agelders2021/xmitter/Documentation/doc_index.md

# Documentation index

Auto-generated by `tools/gen_doc_index.py` on 2026-07-24.  Do not
hand-edit — rerun the script after editing docs.

Two ways to find things:

- **By topic** — scan when you don't remember which file has what.
  Each topic lists file:line hits with the matching line quoted.
- **By file** — each .md's H1/H2/H3 outline. Scan when you know
  the file but not the section.

To search interactively in `less`, use `/pattern` inside the viewer.
For a raw search across all docs from the shell:

    python tools/gen_doc_index.py --search <regex>

---

## By topic

### Toroid winding & cores (T50-6, T68-6, T106-2, FT37, FT82, FT114)

- **Documentation/2026-06-16-supply-and-pcb-strategy.md**
    - L182: (body) toroidal or large E-I primary has 10x inrush regardless of what is
- **Documentation/balun_stage.md**
    - L47: Core: FT82-43 with 5+2 turns
- **Documentation/build_checklist.md**
    - L100: (body) - [ ] **Toroid cores**: T50-6 (VFO LPF — already needed this phase if not
- **Documentation/control_board_BOM_and_wire_plan.md**
    - L1: Control Board BOM + Magnet Wire Plan — 2026-06-16
    - L224: Toroidal inductors (control board)
    - L290: Magnet wire plan - three gauges by stage
- **Documentation/driver_stage.md**
    - L110: Driver output transformer (T68-6)
- **Documentation/jfet_library_readme.md**
    - L128: (body) *Models compiled by Al from OrCAD JFET library (National Semiconductor, 1998),
- **Documentation/LPF_stage.md**
    - L70: (body) L1 and L2 both 540 nH single-wound on a toroidal core.
- **Documentation/PA_stage.md**
    - L185: (body) Toroids are unsuitable for L4, L5, L6. The reasons:
- **Documentation/pcb_fab_checklist.md**
    - L233: (body) mounting holes without conflicting with U1 Si5351 or L6 toroid).
- **Documentation/vfo_input_stage.md**
    - L56: 7-pole low-pass filter (T68-6 inductors, original caps kept)

### Grid bias (OPA454, DAC, slam)

- **CLAUDE.md**
    - L56: (body) existing `bias.kicad_sch` (OPA454 bias generator + LM393 cathode
- **Documentation/2026-06-08-pa-validation.md**
    - L206: (body) DAC + HV op-amp (OPA454) circuit captured in `legacy/20m-leveled-keyed-buffer.md`.
- **Documentation/2026-06-16-supply-and-pcb-strategy.md**
    - L15: (body) + MCU + keyer logic) and PA module board (grid bias + cathode monitor).
- **Documentation/build_checklist.md**
    - L260: Phase 4 — PA + Grid Bias + Cathode Monitor (bias-slam fault path)
- **Documentation/construction.md**
    - L76: (body) Decision (2026-07-09): the control PCB (MC1496 keyer, MCP4921
- **Documentation/control_board_BOM_and_wire_plan.md**
    - L83: (body) **MCP4921** - 12-bit SPI DAC, PDIP-8
- **Documentation/cw_envelope_keyer.md**
    - L179: (body) - DAC: MCP4921, 12-bit, SPI, command word `0x3000` (ch A, buffered, 1x gain,
- **Documentation/design_review_7-5-26.md**
    - L155: (body) - **Grid-bias default state.** MCP4728 EEPROM code 0 → OPA454 output
- **Documentation/driver_stage.md**
    - L291: Q1 — Grid bias polarity
- **Documentation/front_panel_interface.md**
    - L197: (body) writes to the MCP4728 grid-bias DAC.
- **Documentation/grid_bias.md**
    - L1: Grid Bias Subsystem
- **Documentation/kicad_custom_symbols.md**
    - L169: xmitter:OPA454  (DONE — built 2026-06-22)
- **Documentation/pa_cathode_monitor.md**
    - L457: Watchdog gate (grid-bias slam, on the bias sheet)
- **Documentation/PA_stage.md**
    - L43: (body) bias rail (the OPA454 per-tube bias output)

### Cathode monitor, failsafe, fault chain

- **CLAUDE.md**
    - L56: (body) existing `bias.kicad_sch` (OPA454 bias generator + LM393 cathode
- **Documentation/2026-06-16-supply-and-pcb-strategy.md**
    - L15: (body) + MCU + keyer logic) and PA module board (grid bias + cathode monitor).
- **Documentation/build_checklist.md**
    - L260: Phase 4 — PA + Grid Bias + Cathode Monitor (bias-slam fault path)
- **Documentation/construction.md**
    - L88: (body) cathode monitor ADC path
- **Documentation/design_review_7-5-26.md**
    - L18: (body) Design is conceptually sound. The 7-layer cathode failsafe, DPDT T/R
- **Documentation/front_panel_interface.md**
    - L195: (body) cathode monitor path (currently spec'd at 1 kHz per channel on the
- **Documentation/grid_bias.md**
    - L28: (body) monitor's diode-OR; conceptually the "CT_FAULT" signal) via a 2N7000
- **Documentation/i2c_bus.md**
    - L81: (body) inter-board header, and its LM393 cathode monitor sends digital
- **Documentation/pa_cathode_monitor.md**
    - L1: PA Cathode Current Monitor and Failsafe Chain
    - L377: Why diode-OR (not the simpler wired-tie)
- **Documentation/PA_stage.md**
    - L325: Q3 — Cathode monitor and fault chain
- **Documentation/pcb_fab_checklist.md**
    - L7: (body) Scope: **analog control board only** (bias + cathode monitor + VFO +

### PA (6146B, operating point, push-pull, tank)

- **CLAUDE.md**
    - L3: (body) 20 m CW vacuum-tube transmitter. Push-pull 6146B PA, push-pull 12HG7 driver,
- **Documentation/2026-06-08-pa-validation.md**
    - L101: R17 sweep at V6 = 160 V
    - L123: V6 sweep at R17 = 300 Ω
    - L373: `tools/sweep_bias_drive.py` — paired (bias, V6) sweep for grid-voltage-constrained analysis
    - L430: 3. Koren tube model unphysical negative plate current
- **Documentation/2026-06-16-supply-and-pcb-strategy.md**
    - L33: (body) - Loads: 6146B plate center tap (push-pull pair)
- **Documentation/balun_stage.md**
    - L25: (body) differential PA output (driven push-pull from the PA link
- **Documentation/build_checklist.md**
    - L228: Phase 3 — Driver (push-pull 12HG7)
- **Documentation/construction.md**
    - L143: Balance and matching between the two push-pull channels
- **Documentation/control_board_BOM_and_wire_plan.md**
    - L259: (body) 12HG7 plates and 6146B grids. The only bifilar-wound transformer
- **Documentation/cw_envelope_keyer.md**
    - L23: (body) - **PA:** push-pull 6146B beam tetrodes
- **Documentation/driver_stage.md**
    - L3: (body) Push-pull pair of 12HG7 beam pentodes (TV horizontal-sweep tubes,
- **Documentation/grid_bias.md**
    - L3: (body) Per-tube negative grid-bias generation for the push-pull 6146B PA, with a
- **Documentation/LPF_stage.md**
    - L175: (body) - `Documentation/PA_stage.md` — upstream PA stage and tank
- **Documentation/pa_cathode_monitor.md**
    - L3: (body) Per-tube cathode-current monitoring on the push-pull 6146B PA, with all the
- **Documentation/PA_stage.md**
    - L1: PA Stage — Current State
- **Documentation/vfo_input_stage.md**
    - L33: (body) - Si5351 module produces a 3.3 V CMOS push-pull square wave at the

### Driver (12HG7, 12BY7A, output xfmr)

- **CLAUDE.md**
    - L3: (body) 20 m CW vacuum-tube transmitter. Push-pull 6146B PA, push-pull 12HG7 driver,
- **Documentation/2026-06-08-pa-validation.md**
    - L62: (body) - **Re = 200 Ω** (was 1 kΩ) — increases modulator gain (12HG7 driver wants ~8 V p-p input)
- **Documentation/2026-06-16-supply-and-pcb-strategy.md**
    - L45: (body) - Loads: 12HG7 plate center tap
- **Documentation/build_checklist.md**
    - L228: Phase 3 — Driver (push-pull 12HG7)
- **Documentation/construction.md**
    - L101: (body) PCB near the MC1496 output and reaches the 12HG7 driver grids
- **Documentation/control_board_BOM_and_wire_plan.md**
    - L9: (body) LM7171 post-amps + 12HG7 driver topology)
- **Documentation/cw_envelope_keyer.md**
    - L24: (body) - **Driver:** push-pull 12HG7 pentodes
- **Documentation/driver_stage.md**
    - L1: Driver Stage — Current State
    - L110: Driver output transformer (T68-6)
- **Documentation/PA_stage.md**
    - L40: (body) - Each tube grid is driven from the driver output transformer
- **Documentation/vfo_input_stage.md**
    - L272: (body) - The 12HG7 push-pull driver is on the driver board, not the

### Balun / broadband transformer

- **CLAUDE.md**
    - L52: (body) Empty stubs `pa/driver/balun/lpf_output.kicad_sch` still linked at
- **Documentation/2026-06-08-pa-validation.md**
    - L92: Balun subcircuit (`Balun_6to1_subcircuit.sch`)
- **Documentation/balun_stage.md**
    - L1: Balun Stage — Current State
- **Documentation/build_checklist.md**
    - L353: Phase 5 — Balun + Output LPF + ATU
- **Documentation/control_board_BOM_and_wire_plan.md**
    - L14: (body) driver / output LPF / future ATU toroids, #18 AWG for the balun
- **Documentation/design_review_7-5-26.md**
    - L10: (body) buffer_keyer, VFO, arduino, interface). Excluded: PA / driver / balun /
- **Documentation/LPF_stage.md**
    - L9: (body) Single-impedance design for 50 Ω only (PA → balun → this LPF → coax
- **Documentation/PA_stage.md**
    - L5: (body) (then through the 6:1 balun to 50 Ω unbalanced, through the LPF,
- **Documentation/pcb_fab_checklist.md**
    - L10: (body) still empty stubs — `pa`, `driver`, `balun`, `lpf_output` — are

### Output LPF (7-pole, Chebyshev)

- **Documentation/2026-06-08-pa-validation.md**
    - L36: (body) **LPF** upgraded from 5-pole to **7-pole Chebyshev** (same fc = 17.5 MHz, 0.1 dB ripple)
- **Documentation/balun_stage.md**
    - L4: (body) output to a 50 Ω unbalanced output for the output LPF, coax run,
- **Documentation/build_checklist.md**
    - L353: Phase 5 — Balun + Output LPF + ATU
- **Documentation/control_board_BOM_and_wire_plan.md**
    - L5: (body) toroidal inductor in the project (control board, driver, PA, output LPF).
- **Documentation/cw_envelope_keyer.md**
    - L184: (body) - **Reconstruction LPF + level scaler (single passive stage):**
- **Documentation/design_review_7-5-26.md**
    - L11: (body) LPF sheets (Phase 3–5), front-panel sheet population, firmware
- **Documentation/LPF_stage.md**
    - L1: Output LPF Stage — Current State
- **Documentation/pa_cathode_monitor.md**
    - L130: (body) supply. C_FILT in parallel makes the node a single-pole LPF with R_S:
- **Documentation/PA_stage.md**
    - L5: (body) (then through the 6:1 balun to 50 Ω unbalanced, through the LPF,
- **Documentation/vfo_input_stage.md**
    - L56: 7-pole low-pass filter (T68-6 inductors, original caps kept)

### VFO / Si5351 / VFO buffer

- **CLAUDE.md**
    - L49: (body) keyer chain), `vfo.kicad_sch` (Si5351 VFO), `arduino.kicad_sch` (Metro
- **Documentation/2026-06-08-pa-validation.md**
    - L22: VFO subcircuit (`vfo_subcircuit.sch`)
- **Documentation/2026-06-16-supply-and-pcb-strategy.md**
    - L207: Why this partition (not "VFO sensitivity to HV")
- **Documentation/build_checklist.md**
    - L29: Phase 1 — VFO
- **Documentation/component_bins.md**
    - L5: (body) **Sources:**  `KiCAD/analog` (+ `arduino`, `buffer_keyer`, `vfo`, `interface`),
- **Documentation/construction.md**
    - L77: (body) envelope DAC, Si5351 VFO, MCP4728 quad DAC, PCF8575 expander,
- **Documentation/control_board_BOM_and_wire_plan.md**
    - L3: (body) Sourcing-ready parts list for the control board (VFO + keyer + envelope
- **Documentation/cw_envelope_keyer.md**
    - L349: I²C address — MCP4728 vs Si5351 collision
- **Documentation/design_review_7-5-26.md**
    - L10: (body) buffer_keyer, VFO, arduino, interface). Excluded: PA / driver / balun /
- **Documentation/front_panel_interface.md**
    - L34: (body) - **Front panel** holds: WH2004A 20×4 LCD, MBL-600 optical encoder (VFO
- **Documentation/i2c_bus.md**
    - L30: (body) - **0x60 — Si5351A VFO.** Adafruit PID 5640 breakout. Analog control
- **Documentation/LPF_stage.md**
    - L167: (body) (cutoff 17.5 MHz, suppresses Si5351 harmonics) is a different
- **Documentation/pa_cathode_monitor.md**
    - L239: (body) already carries Si5351 (0x60), MCP4728 (0x62 after reprogram), and
- **Documentation/pcb_fab_checklist.md**
    - L7: (body) Scope: **analog control board only** (bias + cathode monitor + VFO +
- **Documentation/vfo_input_stage.md**
    - L1: VFO Input Stage — Current State
    - L145: Optional J310 source follower
    - L196: Q1 — J310 source follower: keep or remove?
    - L221: Q2 — Si5351 output drive strength
    - L239: Q3 — Pi pad value if Si5351 fundamental is too high
    - L257: Q4 — Termination of unused Si5351 outputs

### Keyer / CW envelope / raised cosine

- **CLAUDE.md**
    - L4: (body) MC1496-based VCA keyer with envelope shaping, Adafruit Metro ESP32-S3 control.
- **Documentation/2026-06-08-pa-validation.md**
    - L59: Keyer subcircuit (`keyer.sch`)
    - L67: LM7171 post-keyer amplifier (new subcircuit `Op_Amp_Out.sch`)
- **Documentation/2026-06-16-supply-and-pcb-strategy.md**
    - L15: (body) + MCU + keyer logic) and PA module board (grid bias + cathode monitor).
- **Documentation/build_checklist.md**
    - L101: (body) yet on hand), T68-6 (alternate), T106-2 (PA tank), FT37-43 (keyer
- **Documentation/construction.md**
    - L76: (body) Decision (2026-07-09): the control PCB (MC1496 keyer, MCP4921
- **Documentation/control_board_BOM_and_wire_plan.md**
    - L3: (body) Sourcing-ready parts list for the control board (VFO + keyer + envelope
- **Documentation/cw_envelope_keyer.md**
    - L1: CW Envelope Keyer — Context for Claude Code
    - L60: Public API (what the WinKey layer calls)
    - L150: Calibration (predistortion) — TODO
- **Documentation/design_review_7-5-26.md**
    - L106: (body) which feeds RS-422 receiver, envelope keyer, and cathode monitor
- **Documentation/front_panel_interface.md**
    - L262: (body) which source the WinKey scheduler reads. The unselected source is
- **Documentation/grid_bias.md**
    - L191: (body) normal key-up/key-down bias change. WinKey signals trigger the DAC
- **Documentation/kicad_custom_symbols.md**
    - L221: xmitter:MC1496  (optional, secondary priority)
- **Documentation/pa_cathode_monitor.md**
    - L132: (body) envelope's harmonics (well above the ~200 Hz envelope content); fast enough
- **Documentation/PA_stage.md**
    - L122: (body) Per-tube envelope at OPERATE (V_supply = 600 V, V_SCREEN = 200 V,
- **Documentation/pcb_fab_checklist.md**
    - L8: (body) buffer/keyer + Arduino carrier + Interface). The PA module is a separate
- **Documentation/vfo_input_stage.md**
    - L5: (body) sinusoidal signal to the MC1496 carrier input.

### Front panel / RJ45 umbilical / PCF8575 / LCD

- **CLAUDE.md**
    - L18: (body) | `KiCAD/` | KiCad PCB design files. One project per board: `analog/` (fabricated Rev A...
- **Documentation/2026-06-08-pa-validation.md**
    - L295: (body) The bias DAC's update rate (~360 kHz on MCP4725 fast-mode I²C) is far faster
- **Documentation/2026-06-16-supply-and-pcb-strategy.md**
    - L241: Umbilical considerations
- **Documentation/build_checklist.md**
    - L113: Phase 2 — User Interface (encoders + front panel)
- **Documentation/component_bins.md**
    - L6: (body) `KiCAD/bias`, `KiCAD/frontpanel`.
- **Documentation/construction.md**
    - L44: (body) - Result looks **punched, not filed** — front panel quality
- **Documentation/control_board_BOM_and_wire_plan.md**
    - L165: (body) **WH2004A LCD contrast**
- **Documentation/cw_envelope_keyer.md**
    - L369: (body) 0x20 / 0x21 PCF8575, and leaves room around 0x48 for any future
- **Documentation/design_review_7-5-26.md**
    - L46: (body) MCP4728 0.1" header (SDA/SCL) ─── PCB traces ─── PCF8575 x2 + RJ45
- **Documentation/front_panel_interface.md**
    - L272: RJE1D-188 footprint verification — REOPENED, pending Rev A fit check
    - L315: PCF8575 breakout footprint verification
- **Documentation/grid_bias.md**
    - L184: (body) - **DAC EEPROM safe-park.** MCP4725 startup value = 0 → bias = −85 V
- **Documentation/i2c_bus.md**
    - L10: (body) - **0x20 — PCF8575 (main).** Adafruit PID 5904 breakout. Analog control
- **Documentation/kicad_custom_symbols.md**
    - L268: (body) (Front Panel Express, SendCutSend, Protocase contacts).
- **Documentation/pa_cathode_monitor.md**
    - L240: (body) the two per-tube MCP4725 bias DACs.
- **Documentation/pcb_fab_checklist.md**
    - L66: RJE1D-188 shielded RJ45 socket
    - L90: PCF8575 breakout
- **KiCAD/MULTIBOARD_REVERT.md**
    - L22: (body) `bias/`, `frontpanel/`, pointing at the shared libs one directory up.

### I²C bus, addresses

- **CLAUDE.md**
    - L89: (body) | `Documentation/i2c_bus.md` | **Single source of truth** for I²C device addresses acro...
- **Documentation/2026-06-08-pa-validation.md**
    - L295: (body) The bias DAC's update rate (~360 kHz on MCP4725 fast-mode I²C) is far faster
- **Documentation/2026-06-16-supply-and-pcb-strategy.md**
    - L200: (body) - Bias DAC (MCP4728)
- **Documentation/build_checklist.md**
    - L38: (body) default **0x60** (no ADDR jumper — solder bridge is too small for
- **Documentation/construction.md**
    - L77: (body) envelope DAC, Si5351 VFO, MCP4728 quad DAC, PCF8575 expander,
- **Documentation/control_board_BOM_and_wire_plan.md**
    - L371: I²C bus routing — decision
- **Documentation/cw_envelope_keyer.md**
    - L349: I²C address — MCP4728 vs Si5351 collision
- **Documentation/design_review_7-5-26.md**
    - L30: C1. MCP4728 EEPROM reprogram single-point-of-failure — RESOLVED 2026-07-06
- **Documentation/front_panel_interface.md**
    - L329: Adafruit I²C QT Rotary Encoder footprint + pin-order verification
- **Documentation/grid_bias.md**
    - L185: (body) immediately on cold boot, before MCU initializes I²C or runs any
- **Documentation/i2c_bus.md**
    - L1: I²C bus address plan
- **Documentation/kicad_custom_symbols.md**
    - L138: xmitter:MCP4728  (DONE — built 2026-06-19)
- **Documentation/pa_cathode_monitor.md**
    - L238: (body) - **Bus simplicity.** One fewer I²C address to manage on a bus that
- **Documentation/PA_stage.md**
    - L305: (body) op-amp (one per tube) driven by a firmware MCP4728 DAC, per
- **Documentation/pcb_fab_checklist.md**
    - L99: I²C QT rotary encoder
    - L113: Si5351A STEMMA breakout

### Power supply, rails, transformer, sequencing

- **Documentation/2026-06-08-pa-validation.md**
    - L249: (body) #### Firmware sequencing
- **Documentation/2026-06-16-supply-and-pcb-strategy.md**
    - L1: Power Supply and PCB Strategy — 2026-06-16
    - L24: Power supply
    - L26: Rail inventory
    - L129: Sequencing
    - L146: Inrush limiting
    - L168: Tube filament inrush
- **Documentation/build_checklist.md**
    - L24: (body) Power supply design is being handled in a separate chat. Slots are reserved
- **Documentation/control_board_BOM_and_wire_plan.md**
    - L99: (body) **1N4738A** - 8.2V Zener diode for -8.3V rail derivation
- **Documentation/cw_envelope_keyer.md**
    - L367: (body) correct sequencing.
- **Documentation/design_review_7-5-26.md**
    - L96: C3. +12 V rail source on the analog board is ambiguous
- **Documentation/driver_stage.md**
    - L299: (body) small negative bias from the −105 V rail via a divider.
- **Documentation/front_panel_interface.md**
    - L384: (body) coils (filament, HV, T/R).
- **Documentation/grid_bias.md**
    - L180: Power-up sequencing and fail-safes
    - L196: Level 0 — Power supply tree
- **Documentation/i2c_bus.md**
    - L12: (body) (factory default). Drives the relay coil FETs (filament, HV, T/R).
- **Documentation/pa_cathode_monitor.md**
    - L135: (body) The +3.3 V rail must be **stiff enough to absorb the fault current** transient
- **Documentation/pcb_fab_checklist.md**
    - L144: (body) - [x] Filament / HV / T/R relay drivers are on the **arduino sheet**,

### PCB fab, DRC, ERC, footprint, JLCPCB

- **CLAUDE.md**
    - L46: (body) Analog control board Rev A fabricated (JLCPCB order Y2-13077341A,
- **Documentation/2026-06-08-pa-validation.md**
    - L474: (body) ngspice's ~20 MB footprint per process, that's nothing.
- **Documentation/2026-06-16-supply-and-pcb-strategy.md**
    - L16: (body) - Fab house: **JLCPCB** for both boards.
- **Documentation/build_checklist.md**
    - L140: (body) - [ ] RJ45 footprint verified against datasheet page 2 — see
- **Documentation/component_bins.md**
    - L97: (body) - The following `Value` fields leaked their footprint/pin info into
- **Documentation/construction.md**
    - L56: (body) lay parts on it to verify clearance, ergonomics, and visual
- **Documentation/design_review_7-5-26.md**
    - L6: (body) review — footprint verification and pin-order checks live in
- **Documentation/front_panel_interface.md**
    - L272: RJE1D-188 footprint verification — REOPENED, pending Rev A fit check
    - L315: PCF8575 breakout footprint verification
    - L329: Adafruit I²C QT Rotary Encoder footprint + pin-order verification
- **Documentation/grid_bias.md**
    - L160: (body) no polarity concern, smaller footprint).
- **Documentation/kicad_custom_symbols.md**
    - L33: (body) footprint in `KiCAD/xmitter.pretty/` — this doc extends the approach to
- **Documentation/kicad_routing_cheatsheet.md**
    - L137: DRC & save
- **Documentation/pa_cathode_monitor.md**
    - L534: (body) - [ ] PCB layout: cathode socket area to analog board distance, twisted-pair
- **Documentation/pcb_fab_checklist.md**
    - L59: 1. Custom footprint verification
    - L184: 3. Electrical rules check (ERC)
    - L207: 4. Component footprint coverage
    - L249: 6. Design rules (DRC) — set before routing
- **Documentation/vfo_input_stage.md**
    - L216: (body) footprint on the PCB with provision for a 0 Ω jumper bypass.
- **KiCAD/MULTIBOARD_REVERT.md**
    - L5: (body) KiCad projects sharing one footprint library:

### Firmware, ESP-IDF, FreeRTOS, tasks

- **CLAUDE.md**
    - L4: (body) MC1496-based VCA keyer with envelope shaping, Adafruit Metro ESP32-S3 control.
- **Documentation/2026-06-16-supply-and-pcb-strategy.md**
    - L91: (body) - Loads: Metro ESP32-S3 (via its USB or external power), cathode
- **Documentation/build_checklist.md**
    - L35: (body) - [ ] Adafruit Metro ESP32-S3 confirmed on hand and verified working
- **Documentation/construction.md**
    - L78: (body) Metro ESP32-S3) does **not** go inside the main chassis with the
- **Documentation/control_board_BOM_and_wire_plan.md**
    - L34: (body) optionally Metro ESP32-S3).
- **Documentation/cw_envelope_keyer.md**
    - L28: (body) - **Controller:** Adafruit Metro ESP32-S3, FreeRTOS, dual-core.
- **Documentation/ESP-IDF_Setup_Windows.md**
    - L1: ESP-IDF Setup on Windows
    - L26: Step 2: ESP-IDF Extension
- **Documentation/front_panel_interface.md**
    - L63: (body) quadrature/debounce/state-machine code in the ESP32-S3 firmware
- **Documentation/i2c_bus.md**
    - L20: (body) ESP32-S3 module itself. Not a discrete part in the design — comes with
- **Documentation/kicad_custom_symbols.md**
    - L4: (body) ESP32-S3, Adafruit Si5351A STEMMA QT, etc.) tend to show every pin with
- **Documentation/pa_cathode_monitor.md**
    - L218: (body) **built-in ESP32-S3 ADC** (12-bit, on-chip, ADC1 module). Two analog

### BOM, sourcing, cost

- **CLAUDE.md**
    - L19: (body) | `Documentation/` | Design docs, generated PDFs, sourcing spreadsheets, datasheets |
- **Documentation/2026-06-08-pa-validation.md**
    - L479: (body) - `20m-leveled-keyed-buffer.md` — VFO pad/LPF sections rewritten; BOM updated; added "P...
- **Documentation/2026-06-16-supply-and-pcb-strategy.md**
    - L407: (body) - Pick the actual Hammond part numbers and lock them into the BOM
- **Documentation/build_checklist.md**
    - L96: (body) - [ ] **OPA454** — HV op-amp, sometimes on extended lead at Mouser/DigiKey
- **Documentation/construction.md**
    - L4: (body) each phase of the build surfaces new techniques or sourcing
- **Documentation/control_board_BOM_and_wire_plan.md**
    - L1: Control Board BOM + Magnet Wire Plan — 2026-06-16
- **Documentation/front_panel_interface.md**
    - L78: (body) (Mouser 523-RJE1D18821401). Shielded 8P8C, right-angle THT, tab-down,
- **Documentation/grid_bias.md**
    - L281: BOM summary (this sheet)
- **Documentation/kicad_custom_symbols.md**
    - L51: File-write caveat (KiCad 10 BOM gotcha)
- **Documentation/pa_cathode_monitor.md**
    - L418: BOM
- **Documentation/pcb_fab_checklist.md**
    - L286: 8. Ordering / BOM alignment
- **Documentation/vfo_input_stage.md**
    - L61: (body) are E12 standard silver mica values for easy sourcing. The slight

### Build checklist, phases, long-lead

- **CLAUDE.md**
    - L37: Build checklist
- **Documentation/build_checklist.md**
    - L1: Build Checklist
    - L29: Phase 1 — VFO
    - L113: Phase 2 — User Interface (encoders + front panel)
    - L228: Phase 3 — Driver (push-pull 12HG7)
    - L260: Phase 4 — PA + Grid Bias + Cathode Monitor (bias-slam fault path)
    - L353: Phase 5 — Balun + Output LPF + ATU
    - L379: Phase 6 — Integration / first light
- **Documentation/cw_envelope_keyer.md**
    - L145: (body) **Edge time convention:** `edge_ms` is the **full** phase 0→1 duration. The
- **Documentation/design_review_7-5-26.md**
    - L11: (body) LPF sheets (Phase 3–5), front-panel sheet population, firmware
- **Documentation/front_panel_interface.md**
    - L404: (body) relay is chosen — see Phase 4 checklist).
- **Documentation/i2c_bus.md**
    - L44: (body) `build_checklist.md` Phase 1. Provides grid-bias control voltages
- **Documentation/pcb_fab_checklist.md**
    - L1: PCB Fabrication Pre-Flight Checklist
    - L312: 9. Fab-house-specific pre-flight

### Component bins / physical inventory

_no hits_

### Legacy / obsolete / superseded

- **Documentation/2026-06-08-pa-validation.md**
    - L206: (body) DAC + HV op-amp (OPA454) circuit captured in `legacy/20m-leveled-keyed-buffer.md`.
- **Documentation/build_checklist.md**
    - L221: (body) - [x] ~~**ADS1115 breakout** (Cathode Monitor phase).~~ No longer needed;
- **Documentation/control_board_BOM_and_wire_plan.md**
    - L8: (body) - Removal of the obsolete FT37-43 keyer T1 transformer (superseded by
- **Documentation/cw_envelope_keyer.md**
    - L231: (body) (original derivation is in `legacy/20m-leveled-keyed-buffer.md`).
- **Documentation/design_review_7-5-26.md**
    - L50: (body) Corresponding schematic changes: **SDA/SCL board connections removed
- **Documentation/driver_stage.md**
    - L146: (body) > The 4.8 µH / 1.14 µH numbers date from an earlier legacy analysis
- **Documentation/ESP-IDF_Setup_Windows.md**
    - L106: (body) - **"Configure ESP-IDF Extension"** command no longer exists in extension
- **Documentation/front_panel_interface.md**
    - L43: (body) paddle (see "Paddle jack — two possible paths" below). **No longer
- **Documentation/PA_stage.md**
    - L229: (body) resonance with grid drive removed
- **Documentation/pcb_fab_checklist.md**
    - L88: (body) shield tails (Ø1.57 plated), not 4. Original guesses removed.
- **Documentation/vfo_input_stage.md**
    - L8: (body) are referenced for context but their specifics live in legacy docs.

---

## By file (outline)

### CLAUDE.md

- L1: xmitter project — Claude Code project instructions
  - L13: Directory map
  - L23: If the user ever sets up another fresh machine
  - L37: Build checklist
  - L44: Current focus
  - L77: Existing design references
  - L92: Conventions
  - L105: Tooling regeneration commands

### Documentation/2026-06-08-pa-validation.md

- L1: PA Validation Session — 2026-06-08
  - L8: Summary
  - L20: Changes committed this session
    - L22: VFO subcircuit (`vfo_subcircuit.sch`)
    - L59: Keyer subcircuit (`keyer.sch`)
    - L67: LM7171 post-keyer amplifier (new subcircuit `Op_Amp_Out.sch`)
    - L85: PA subcircuit (`PA_subcircuit.sch`)
    - L92: Balun subcircuit (`Balun_6to1_subcircuit.sch`)
  - L96: PA sweep results
    - L101: R17 sweep at V6 = 160 V
    - L123: V6 sweep at R17 = 300 Ω
    - L149: Grid voltage constraint (the binding limit)
    - L186: Corrected operating point
    - L202: Bias rail strategy: hardware−rail vs firmware−adjusted
    - L224: Two-state bias operation (refinement of the strategy above)
    - L308: Grid-bias subcircuit implementation files
  - L332: New tooling
    - L334: `tools/sweep_param.py` — generic ngspice parameter sweep
    - L373: `tools/sweep_bias_drive.py` — paired (bias, V6) sweep for grid-voltage-constrained analysis
    - L388: `tools/gui_plot.py` change
    - L393: `tools/plot.py` change
  - L399: Lessons learned (worth remembering)
    - L401: 1. ngspice transient sampling vs. RMS/mean accuracy
    - L418: 2. ngspice transient window length vs. RMS/mean validity
    - L430: 3. Koren tube model unphysical negative plate current
    - L444: 4. Diode in series with a 0 V voltage source = SPICE pain
    - L455: 5. The `uic` flag and `.IC` components in QUCS-S
    - L467: 6. Parallel ngspice == real speedup
  - L476: Updated/replaced docs
  - L481: Deferred (next session)

### Documentation/2026-06-16-supply-and-pcb-strategy.md

- L1: Power Supply and PCB Strategy — 2026-06-16
  - L9: Summary of decisions made this session
  - L24: Power supply
    - L26: Rail inventory
    - L96: Topology — three transformers
    - L129: Sequencing
    - L146: Inrush limiting
    - L168: Tube filament inrush
  - L186: PCB partitioning
    - L188: Decision: two boards
    - L207: Why this partition (not "VFO sensitivity to HV")
    - L241: Umbilical considerations
    - L253: Board stackup and rules
  - L270: Fab house decision
  - L298: Surface finish decision
  - L322: EDA tool decision
  - L348: KiCad project structure
    - L381: Net classes for the PA module board
  - L398: Open items for next session

### Documentation/balun_stage.md

- L1: Balun Stage — Current State
  - L9: Block diagram
  - L29: Component values
  - L47: Core: FT82-43 with 5+2 turns
  - L80: Wire gauge
  - L94: Power dissipation
  - L111: Open question
    - L113: Common-mode choking on the antenna coax
  - L123: What is NOT in this stage
  - L133: References

### Documentation/build_checklist.md

- L1: Build Checklist
  - L29: Phase 1 — VFO
    - L33: Verify before starting
    - L74: Verify before declaring done
    - L91: Procure now for later phases
  - L113: Phase 2 — User Interface (encoders + front panel)
    - L117: Verify before starting
    - L161: PCB Rev A fab order
    - L175: Verify before declaring done
    - L215: Procure now for later phases
  - L228: Phase 3 — Driver (push-pull 12HG7)
    - L232: Verify before starting
    - L241: Verify before declaring done
    - L251: Procure now for later phases
  - L260: Phase 4 — PA + Grid Bias + Cathode Monitor (bias-slam fault path)
    - L268: Verify before starting
    - L314: Verify before declaring done
    - L344: Procure now for later phases
  - L353: Phase 5 — Balun + Output LPF + ATU
    - L357: Verify before starting
    - L363: Verify before declaring done
    - L373: Procure now for later phases
  - L379: Phase 6 — Integration / first light
    - L383: Verify before starting
    - L391: Verify before declaring done
  - L412: Reference

### Documentation/component_bins.md

- L1: xmitter component bins  —  24-bin allocation
  - L15: Resistors  (8 bins)
  - L31: Capacitors  (6 bins)
  - L45: Semiconductors  —  bagged & labeled  (2 bins)
  - L55: Individual ICs  —  one bin each  (8 bins)
  - L71: Summary
  - L84: Notes

### Documentation/construction.md

- L1: Construction Notes
  - L7: Chassis and front-panel fabrication
    - L9: Custom CNC panel / chassis services
    - L38: Workflow advantages for this build
    - L47: Caveat — commit the layout first
    - L62: Open items
  - L74: Electronics-in-a-separate-box strategy
    - L83: Why the two-box split
    - L98: Signal chain from PCB to driver tubes
    - L123: Why BNC (not RCA, SMA, or PL-259)
    - L143: Balance and matching between the two push-pull channels
    - L158: Grounding scheme summary
    - L175: Open items — two-box construction

### Documentation/control_board_BOM_and_wire_plan.md

- L1: Control Board BOM + Magnet Wire Plan — 2026-06-16
  - L24: Suppliers used in this list
  - L47: Active devices (control board)
  - L107: Passives - resistors (control board)
  - L190: Passives - capacitors (control board)
  - L224: Toroidal inductors (control board)
  - L253: Cores and inductors - other project boards
  - L290: Magnet wire plan - three gauges by stage
  - L336: Sockets and connectors
  - L371: I²C bus routing — decision
  - L404: Trim caps for tuning
  - L413: Summary by supplier
  - L478: Open items

### Documentation/cw_envelope_keyer.md

- L1: CW Envelope Keyer — Context for Claude Code
  - L9: What this module does
    - L19: Where it sits in the rig
  - L46: RTOS / core model
  - L60: Public API (what the WinKey layer calls)
    - L74: Minimal integration example
  - L94: Design decisions that must NOT be undone
  - L128: Tuning parameters (top of the .cpp)
  - L150: Calibration (predistortion) — TODO
  - L166: Fail-safe requirement (do not skip — this is a tube PA)
  - L177: Hardware notes
  - L297: Next-phase enhancement: DAC-driven digital carrier null
    - L322: Hardware additions
    - L349: I²C address — MCP4728 vs Si5351 collision
    - L388: Coverage analysis
    - L413: Firmware
    - L426: Tradeoff vs running PNPs at fixed bias only
  - L446: Open work / next steps
  - L458: Environment

### Documentation/design_review_7-5-26.md

- L1: Design Review — 2026-07-05
  - L16: Bottom line
  - L28: Real conceptual concerns
    - L30: C1. MCP4728 EEPROM reprogram single-point-of-failure — RESOLVED 2026-07-06
    - L77: C2. K_MAIN mains-interlock relay is not schematically represented
    - L96: C3. +12 V rail source on the analog board is ambiguous
  - L117: Correctly deferred (not concerns)
  - L130: Housekeeping items (already known, not conceptual)
  - L144: Confirmed conceptually sound
  - L194: Explore-agent findings that were false-positives
  - L226: Recommended next-phase work order

### Documentation/driver_stage.md

- L1: Driver Stage — Current State
  - L12: Block diagram
  - L53: Component values
    - L55: Grid path (per tube; lower index = lower tube)
    - L67: Screen path (per tube — see C2/C4 split below)
    - L77: Plate path (per tube)
    - L88: C2 and C4 are two physical caps each
  - L110: Driver output transformer (T68-6)
  - L194: Power dissipation
    - L200: Per-tube tube dissipation
    - L215: Resistor power dissipation
    - L229: Supply currents needed
  - L244: Component selection notes
    - L246: Resistors
    - L254: Capacitors
    - L271: Inductors
    - L282: Sockets
  - L289: Open questions
    - L291: Q1 — Grid bias polarity
    - L301: Q2 — Plate supply voltage tolerance
    - L309: Q3 — Heater wiring (series vs parallel)
  - L317: What is NOT in this stage
  - L326: References

### Documentation/ESP-IDF_Setup_Windows.md

- L1: ESP-IDF Setup on Windows
  - L8: Prerequisites
  - L20: Step 1: VS Code
  - L26: Step 2: ESP-IDF Extension
  - L31: Step 3: Open the xmitter workspace
  - L35: Step 4: Launch EIM (Installation Manager)
  - L44: Step 5: EIM Custom Install
  - L61: Step 6: Reconnect VS Code to the install
  - L83: Step 7: Verify
  - L93: Paths created on disk
  - L104: Gotchas
  - L117: Hardware-side step (for the machine where the Metro lives)
  - L127: Keep both machines in sync

### Documentation/front_panel_interface.md

- L1: Front-Panel Interface
  - L32: Physical topology
  - L94: T568B pin map
  - L120: Grounding rule (SINGLE-POINT)
  - L135: RS-422 termination
  - L152: Interrupt handling (decision: polling now, INT hardware reserved)
  - L232: Paddle jack — two possible paths
  - L267: Open items (verify before PCB fab)
    - L272: RJE1D-188 footprint verification — REOPENED, pending Rev A fit check
    - L315: PCF8575 breakout footprint verification
    - L329: Adafruit I²C QT Rotary Encoder footprint + pin-order verification
    - L357: Schematic — Interface sheet complete (2026-07-13)
    - L395: Control functions — not yet designed
    - L410: Ordering
    - L437: Fabrication (front-panel PCB)
  - L455: Signal chain (end-to-end, for reference)

### Documentation/grid_bias.md

- L1: Grid Bias Subsystem
  - L10: Why this matters
  - L34: System block diagram
  - L78: Architecture decisions
    - L80: Precision reference vs supply rail are SEPARATE nets
    - L101: Why the LM4040 bias resistor is 2.2 kΩ
    - L110: Why R_pad sits between the DAC input and the IN+ pin
    - L127: Why both 2N7000s share one R_GATE
    - L136: Why bypass caps are shared between U5 and U10
    - L153: Why 1 µF instead of 10 µF on the bulk caps
  - L162: Transfer function
  - L180: Power-up sequencing and fail-safes
  - L194: Layer-by-layer design
    - L196: Level 0 — Power supply tree
    - L212: Level 1 — Bias gain stage (one per tube)
    - L229: Level 2 — Bias-slam (one MOSFET per tube, shared gate driver)
    - L241: Level 3 — Supply bypass (shared between U5 and U10)
  - L257: Inter-sheet I/O
  - L281: BOM summary (this sheet)
  - L308: Calibration procedure (bring-up)
  - L328: Open items
  - L343: Related docs

### Documentation/i2c_bus.md

- L1: I²C bus address plan
  - L8: Device inventory
  - L47: Bus topology
  - L77: Bias board
  - L85: Reserved / expansion slots
  - L92: Ruled-out configurations (do not re-propose)
  - L104: Cross-references

### Documentation/jfet_library_readme.md

- L1: Qucs-S Extended JFET & Dual-Gate MOSFET Library
  - L2: Files Included
  - L14: Installation
  - L25: The BF961 — Important Notes
    - L42: Typical Bias (VHF Amplifier)
    - L48: AGC Operation
    - L52: BF961 vs BF981 vs BF998
  - L66: JFET Library — Device Quick Reference
    - L68: N-Channel JFETs
    - L89: P-Channel JFETs
  - L102: SPICE Model Caveats
  - L115: Simulation Tips for Dual-Gate MOSFETs in Qucs-S

### Documentation/kicad_custom_symbols.md

- L1: KiCad Custom Symbols — xmitter library
  - L13: Why custom symbols
  - L36: Library location
  - L51: File-write caveat (KiCad 10 BOM gotcha)
  - L62: Workflow — building a custom symbol
  - L94: Planned custom symbols for this project
    - L96: xmitter:Metro_ESP32S3
    - L132: xmitter:MCP4921_DAC  (optional, secondary priority)
    - L138: xmitter:MCP4728  (DONE — built 2026-06-19)
    - L169: xmitter:OPA454  (DONE — built 2026-06-22)
    - L221: xmitter:MC1496  (optional, secondary priority)
  - L229: Verification checklist before placing a custom symbol
  - L246: Reference — KiCad symbol file format
  - L263: Related docs

### Documentation/kicad_routing_cheatsheet.md

- L1: KiCad 10 PCB Routing Cheatsheet
  - L8: Routing
  - L21: Layers & vias
  - L32: Track width & router mode
  - L44: Edit & select
  - L58: Zones (ground pour)
    - L68: "B doesn't fill my pour" — troubleshooting
  - L114: View & navigation
  - L127: Measurement & info
  - L137: DRC & save
  - L146: Grid & display
  - L155: Cursor tricks
  - L161: Handy workflow

### Documentation/LPF_stage.md

- L1: Output LPF Stage — Current State
  - L14: Block diagram
  - L28: Component values
  - L40: Design choices
  - L68: Inductor build
  - L90: Capacitor selection
  - L113: Expected response
  - L137: Power dissipation
  - L149: ATU interaction
  - L159: What is NOT in this stage
  - L171: References

### Documentation/pa_cathode_monitor.md

- L1: PA Cathode Current Monitor and Failsafe Chain
  - L6: Why this matters
  - L21: System block diagram
  - L57: Layer-by-layer design
    - L59: Level 0 — Cathode resistor + RF bypass
    - L78: Level 1 — PTC fuse (resettable thermal)
    - L97: Level 2 — Series current limiter
    - L119: Level 3 — Schottky clamps + anti-alias filter
    - L143: Level 4 — Op-amp buffer (ADC isolation)
    - L169: Level 5 — Hardware comparator (FAST hardware trip)
    - L215: Level 6 — Firmware soft trip
    - L265: Level 7 — Persistent fault log
  - L283: Per-tube wiring + grounding
  - L310: Layout rules (binding decisions for this build)
    - L312: F1 and R_S stay paired in F1 → R_S order
    - L329: F1 thermal: chassis muffin fan over 6146 socket area
    - L338: Sense cable: shielded coax, shield grounded at tube end
  - L349: Calibration procedure (bring-up)
  - L366: Per-tube → both-tubes summing
    - L377: Why diode-OR (not the simpler wired-tie)
  - L418: BOM
  - L457: Watchdog gate (grid-bias slam, on the bias sheet)
  - L493: Open items
  - L537: Related docs

### Documentation/PA_stage.md

- L1: PA Stage — Current State
  - L12: Block diagram
  - L57: Component values (per side; lower index = lower tube)
    - L59: Grid network
    - L69: Cathode
    - L77: Screen path (per tube — two bypass caps each)
    - L88: Plate path (per tube)
    - L101: Output coupling / load
  - L111: Operating point (validated 2026-06-08)
  - L145: Plate tank design
  - L172: Parasitic suppression
  - L183: Construction notes — air-core coils required
  - L221: Neutralization
  - L233: Power dissipation
    - L235: Per-tube dissipation budget (OPERATE state)
    - L251: Resistor power (worst-case bounds)
    - L276: Supply currents
  - L293: Tube sockets
  - L300: Open questions
    - L302: Q1 — Per-tube bias control
    - L316: Q2 — Bench-time peak grid voltage margin
    - L325: Q3 — Cathode monitor and fault chain
  - L332: What is NOT in this stage
  - L344: References

### Documentation/pcb_fab_checklist.md

- L1: PCB Fabrication Pre-Flight Checklist
  - L31: Current status snapshot (2026-07-14)
  - L59: 1. Custom footprint verification
    - L66: RJE1D-188 shielded RJ45 socket
    - L90: PCF8575 breakout
    - L99: I²C QT rotary encoder
    - L113: Si5351A STEMMA breakout
  - L127: 2. Schematic completeness
    - L132: Interface sheet — `KiCAD/interface.kicad_sch`
    - L156: Arduino sheet — `KiCAD/arduino.kicad_sch`
    - L164: Front_Panel sheet — `KiCAD/front_panel.kicad_sch`
    - L173: Root — `KiCAD/KiCAD.kicad_sch`
  - L184: 3. Electrical rules check (ERC)
  - L207: 4. Component footprint coverage
  - L226: 5. Physical / mechanical
  - L249: 6. Design rules (DRC) — set before routing
  - L271: 7. Two-board directory split — decided (deferred)
  - L286: 8. Ordering / BOM alignment
  - L312: 9. Fab-house-specific pre-flight
  - L336: Sign-off

### Documentation/vfo_input_stage.md

- L1: VFO Input Stage — Current State
  - L10: Block diagram
  - L44: Components and values
    - L46: Pi-pad attenuator (20 dB, 50 Ω in / 50 Ω out)
    - L56: 7-pole low-pass filter (T68-6 inductors, original caps kept)
    - L135: Output coupling and termination
    - L145: Optional J310 source follower
  - L155: Source of truth
  - L167: Simulation vs hardware
  - L194: Open design questions
    - L196: Q1 — J310 source follower: keep or remove?
    - L221: Q2 — Si5351 output drive strength
    - L239: Q3 — Pi pad value if Si5351 fundamental is too high
    - L257: Q4 — Termination of unused Si5351 outputs
  - L265: What is NOT in this stage
  - L278: Related docs and files

### KiCAD/MULTIBOARD_REVERT.md

- L1: Multi-board split — how to revert
  - L26: If the split turns out to be a mistake
    - L28: Option 1 — throw away the branch entirely (cleanest)
    - L38: Option 2 — you already merged the split into master
    - L49: Option 3 — surgical rollback (keep some stages, drop others)
  - L62: What to check after any revert
  - L70: Files intentionally NOT changed by the migration
