agelders2021/xmitter/Documentation/Grid_Bias_Schematic.pdf

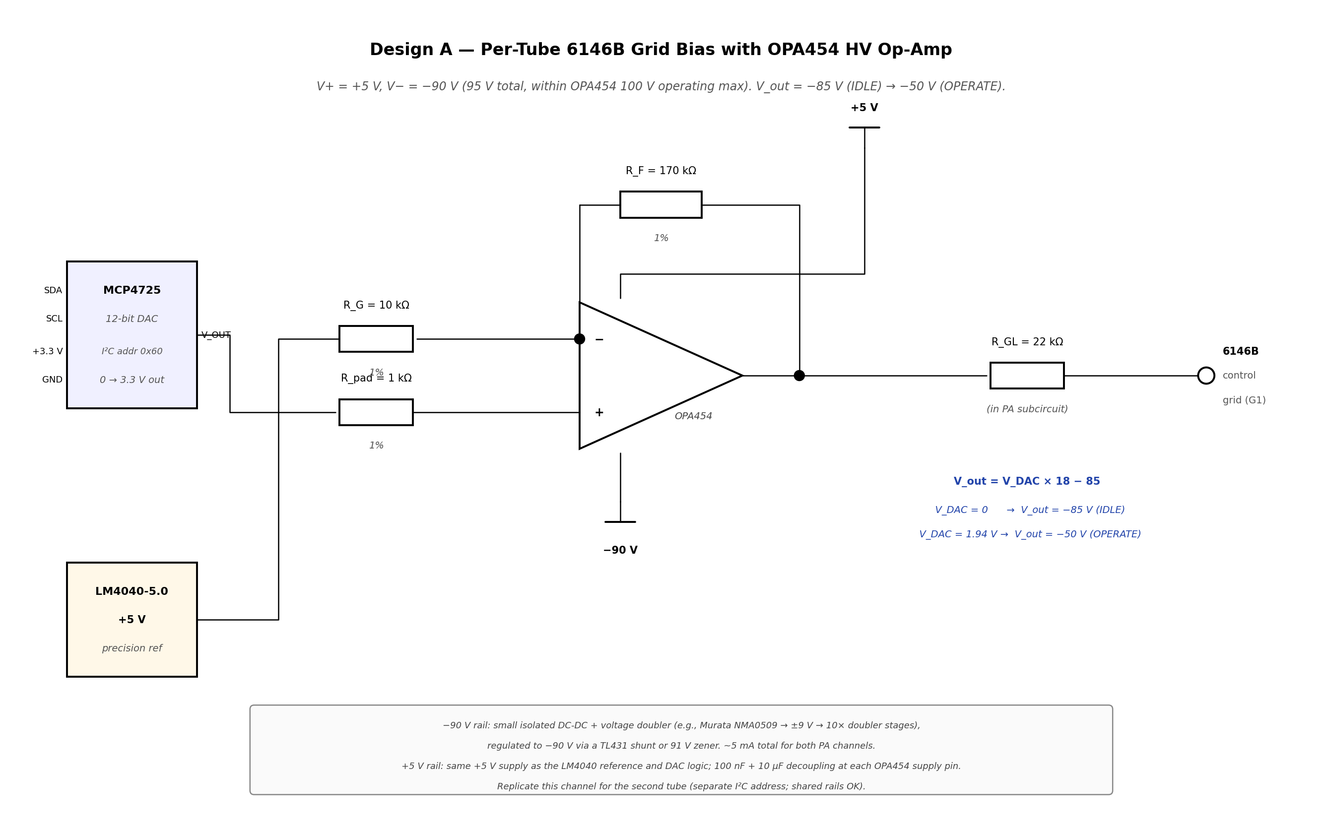
[picture p2: page 1]

Figure 1. Design A — OPA454 HV op-amp version. One channel; replicate for the second tube.

# Design A — OPA454 Components & Transfer Function

Ref | Value / Part | Notes
DAC | MCP4725 (×2) | I²C 12-bit; EEPROM startup = 0 → output = 0 V → V_out = −85 V (IDLE)
Op-amp | OPA454 (×2) | HV op-amp, V+ = +5 V / V− = −90 V (95 V total, within 100 V op max)
V_REF | LM4040DIZ-5.0 | Precision +5 V shunt reference
R_pad | 1 kΩ 1% | DAC → (+) input series; impedance matching
R_G | 10 kΩ 1% | (−) input ↔ V_REF (+5 V)
R_F | 170 kΩ 1% (or 169 kΩ E96) | Feedback (−) ↔ V_out
Decoupling | 100 nF X7R + 10 µF on each rail at the OPA454
+5 V rail | Same as DAC / LM4040 supply | Trivial current; share existing rail
−90 V rail | Isolated DC-DC (e.g., Murata NMA0509) + voltage doubler + TL431 shunt regulator ~5 mA for both PA channels
R_GL | 22 kΩ (already in PA subcircuit) | Unchanged

## Transfer Function

V_out = V_DAC × (1 + R_F/R_G) − V_REF × R_F/R_G = V_DAC × 18 − 85

V_DAC = 0 V → V_out = −85 V (IDLE: tubes deeply cut off, zero plate current)
V_DAC = 1.94 V → V_out = −50 V (OPERATE: shallow class C, ready for envelope) — DAC code 2410 (of 4095)
V_DAC = 3.3 V → V_out = −25.6 V (firmware MUST cap below this — would forward-bias the grid)

Common-mode input range check: with V+ = +5 V / V− = −90 V and OPA454's typical 3 V CM margin, the (+) input range is roughly −87 V to +2 V. V_DAC at the (+) input swings 0 to ~2 V (firmware-bounded), inside the range with margin.
Output swing check: rail-to-rail−2 V gives output range −88 V to +3 V. Comfortably covers −85 V (IDLE) and −50 V (OPERATE).
Supply margin: the +5 V / −90 V choice gives 95 V total — 5 V under the OPA454 100 V operating max, well under the 105 V absolute max.

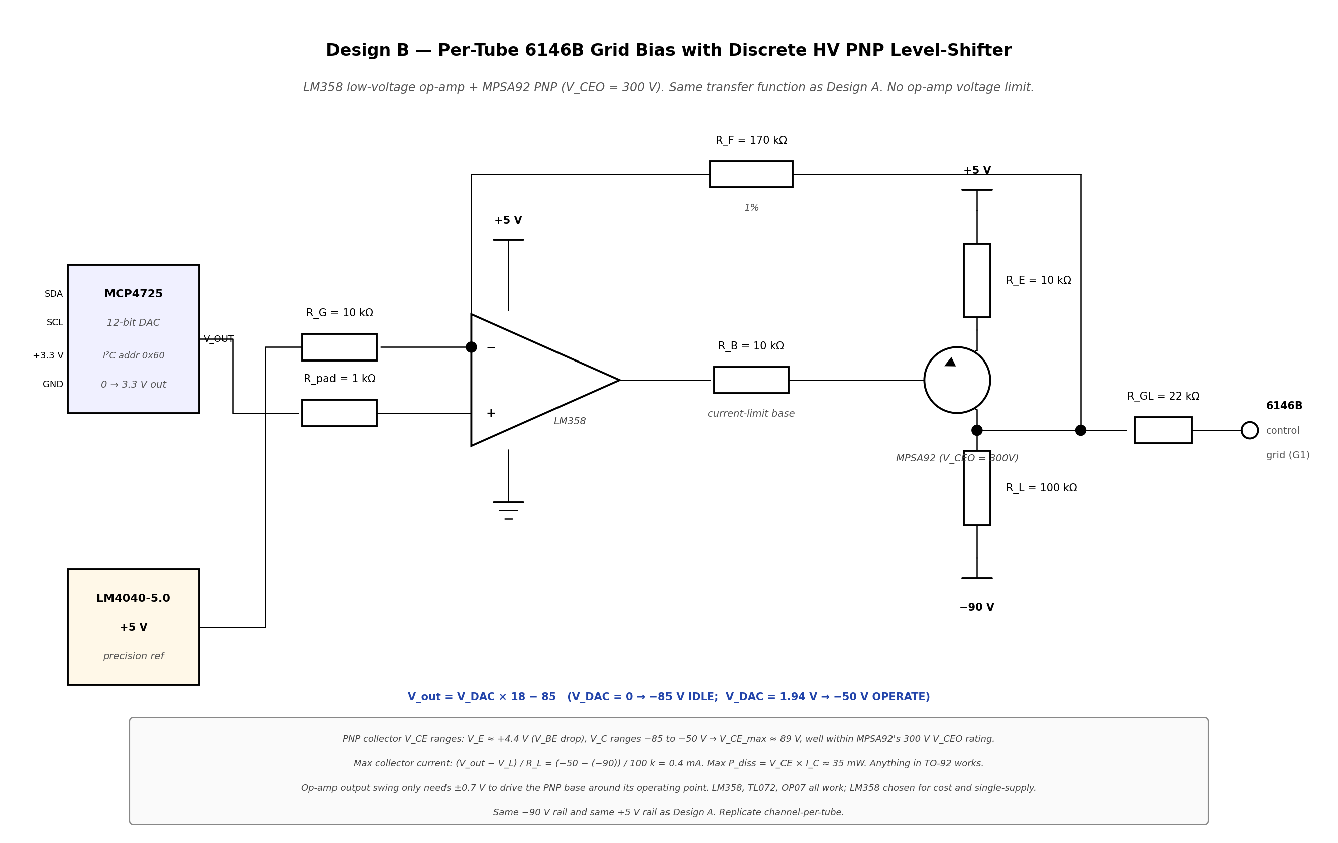
[picture p3: page 3]

Figure 2. Design B — LM358 + discrete MPSA92 PNP level-shifter. Same transfer function as Design A; no op-amp voltage limit.

# Design B — Discrete PNP Components & Notes

Ref | Value / Part | Notes
DAC | MCP4725 (×2) | Same as Design A
Op-amp | LM358 (×2; one half each), or TL072 | LV op-amp, single +5 V supply — no HV constraint
HV transistor | MPSA92 (×2) | PNP, V_CEO = 300 V, TO-92; alternative: KSP44, ZTX560, 2N5401 (160 V)
V_REF | LM4040DIZ-5.0 | Same +5 V shunt reference as Design A
R_pad | 1 kΩ 1% | DAC → (+) input series
R_G | 10 kΩ 1% | (−) input ↔ V_REF (+5 V)
R_F | 170 kΩ 1% (or 169 kΩ E96) | Feedback from PNP collector ↔ (−) input
R_B | 10 kΩ | Base current limit; sets loop slew comfortably
R_E | 10 kΩ | Emitter resistor to +5 V; sets ~0.4 mA emitter current
R_L | 100 kΩ | Collector pull-down to −90 V; sets load impedance
Decoupling | 100 nF X7R at each LM358 supply pin; 1 nF NP0 across each transistor B-E for HF stability
+5 V rail | Shared with DAC, LM4040, LM358
−90 V rail | Same isolated DC-DC as Design A | Loads R_L (×2 tubes); ~1 mA total
R_GL | 22 kΩ (already in PA subcircuit) | Unchanged

## Transfer Function and Operation

Same as Design A: V_out = V_DAC × 18 − 85
The PNP collector node is the output. LM358 closes the loop via R_F sensing the collector voltage; the op-amp drives the PNP base to whatever level forces V_(−) = V_(+) = V_DAC. No supply-voltage limits on the loop because the HV stress is borne entirely by the PNP transistor.

PNP stress check: V_CE_max ≈ V_E − V_C_min = +4.4 V − (−85 V) = 89 V — well below MPSA92's 300 V V_CEO rating (3.4× margin). Max I_C = (V_out − V_neg) / R_L = (−50 − (−90)) / 100 kΩ = 0.4 mA. Max P_diss = V_CE × I_C ≈ 35 mW (any TO-92 fits comfortably).
Op-amp swing required: the LM358 only needs to swing about ±0.7 V around the PNP base operating point — fully within single-supply LM358 specs. Even at the IDLE end (V_out = −85 V → I_C ≈ 0), the op-amp output stays within rails.
Why this exists: if the OPA454 is unobtainable, of dubious authenticity (the marketplace has counterfeits), or you prefer not to operate any single part at its supply max, the discrete design is electrically equivalent and built from in-stock generics. The MPSA92 is a $0.10 part in singles.

# Shared: Two-State Operation, Power-Up, Fail-Safe, Layout

## Two-State Operation

Bias has two firmware-managed states with smooth transitions:
IDLE (key-up): DAC = 0 → V_out = −85 V → 6146B fully cut off, plate current = 0, standby dissipation = 0 W per tube. This is the safe-park state.
OPERATE (key-down): DAC = 2410 (of 4095) → V_out = −50 V → shallow class C, smooth conduction onset, full envelope dynamic range available to the predistortion LUT.
Per-tube trim: the OPERATE DAC code may differ by a few counts between tubes to balance for tube-to-tube spread. Calibrated at bring-up via the cathode-current monitor.

## Power-Up Sequence and Firmware Timing

Power-on: Rails come up (+5 V, −90 V). MCP4725 EEPROM startup value = 0 → DAC = 0 V → V_out = −85 V on both tubes. PA is in deep cutoff before the MCU finishes booting.
Key-down sequence: (1) WinKey signals key-down; (2) per-tube bias DACs commanded IDLE → OPERATE (each ~25 µs over I²C); (3) wait 200 µs for op-amp + grid input cap to settle; (4) launch envelope DAC raised-cosine ramp from 0 → CODE_FULL.
Key-up sequence: (1) envelope DAC ramps to 0 over 3–5 ms; (2) wait 1 ms guard after envelope nulls; (3) bias DACs commanded OPERATE → IDLE; (4) wait 200 µs to confirm tubes back in cutoff.

## Fail-Safe

Three independent layers:
(1) DAC EEPROM safe-park: startup value 0 → IDLE bias on cold boot, before MCU initializes I²C.
(2) Watchdog gate: esp_task_wdt pulls a hardware GPIO that removes screen voltage if the MCU hangs. PA goes dark even if the DAC is stuck in OPERATE.
(3) Cathode-current monitor: independent ADC-based sense (separate circuit) triggers a soft-shutdown if either tube exceeds its current limit. Captured separately in the cathode-sense design notes.

## Layout Notes

- Keep the op-amp/transistor output trace short and away from RF; the 22 kΩ grid leak provides isolation but route bias on a separate layer from RF signals where possible.
- −90 V rail is small-current but high-voltage. Use ≥150 V rated film/ceramic capacitors for bypass. Standard 25 V ceramics will fail.
- Allocate distinct I²C addresses for the two per-tube DACs (MCP4725 supports 0x60–0x67 via the A0/A1/A2 pads). Collisions kill the I²C bus.

- Design B only: mount the PNP transistor close to its base resistor and decouple its emitter with 100 nF to its supply pin side. The PNP is fast (f_T ≈ 50 MHz) and can ring without proper damping if the base is driven through long inductive traces.

## Design A vs. Design B Comparison

| Design A (OPA454) | Design B (Discrete PNP)
Op-amp | OPA454 (HV) | LM358 (LV) + MPSA92 PNP
Cost | ~$5 (single-source TI) | ~$0.50 (LM358 + MPSA92)
Supply margin | 5 V under op max (100 V) — adequate | Unlimited (PNP V_CEO = 300 V)
Parts count | 5 R + 1 IC + 1 ref + bypass | 6 R + 1 IC + 1 transistor + 1 ref + bypass
Convenience | Single IC handles everything | Two-stage; transistor needs care for HF stability
Counterfeit risk | OPA454 has known counterfeit sources | MPSA92 / LM358 are generic — no incentive to fake
Authenticity check | Power test before installing; check the laser-etched marking; genuine vs. relabel can be hard to tell Not really an issue
