agelders2021/xmitter/Documentation/ATU_analysis.pdf

L1 2.14 uH

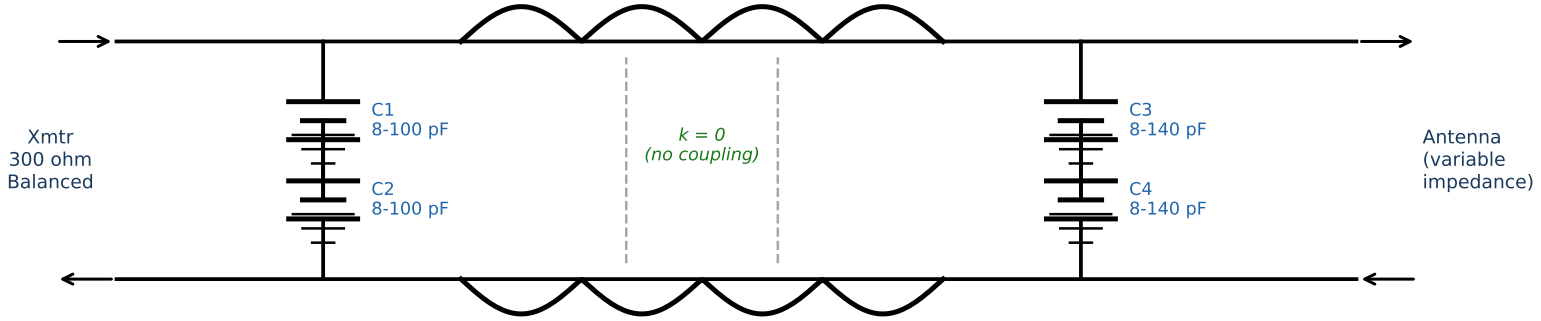
[picture p10: figure]
Xmtr 300 ohm Balanced; k = 0 (no coupling); Antenna (variable impedance)

L2 2.14 uH

### Balanced Pi-Network Topology

k | Effective XL (diff.) | % of k=0 | Assessment
0.99 (original) | 3.8 ohm | 1% | Essentially zero | matching impossible
0.90 | 38.2 ohm | 10% | Severely limited matching range
0.00 (recommended) | 382 ohm | 100% | Full matching range available

### Coupling Constant Effect on Differential Inductance (L = 2.14 uH each, f = 14.2 MHz)

Why k = 0 is required:

For a balanced (push-pull) circuit the two inductors carry equal and opposite currents.
The effective differential inductance is 2L(1-k), so a high coupling constant drastically
reduces the series reactance available for impedance matching.

With k=0.99 the inductors act as near-perfect transformers and cancel each other differentially, leaving only 3.8 ohm of series reactance far too little for any useful matching.
The inductors must not be magnetically coupled: wind them on separate cores or orient at 90 deg.

# ATU Matching Range Analysis

20m CW Transmitter Balanced Pi-Network ATU Analysis | 14.2 MHz

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

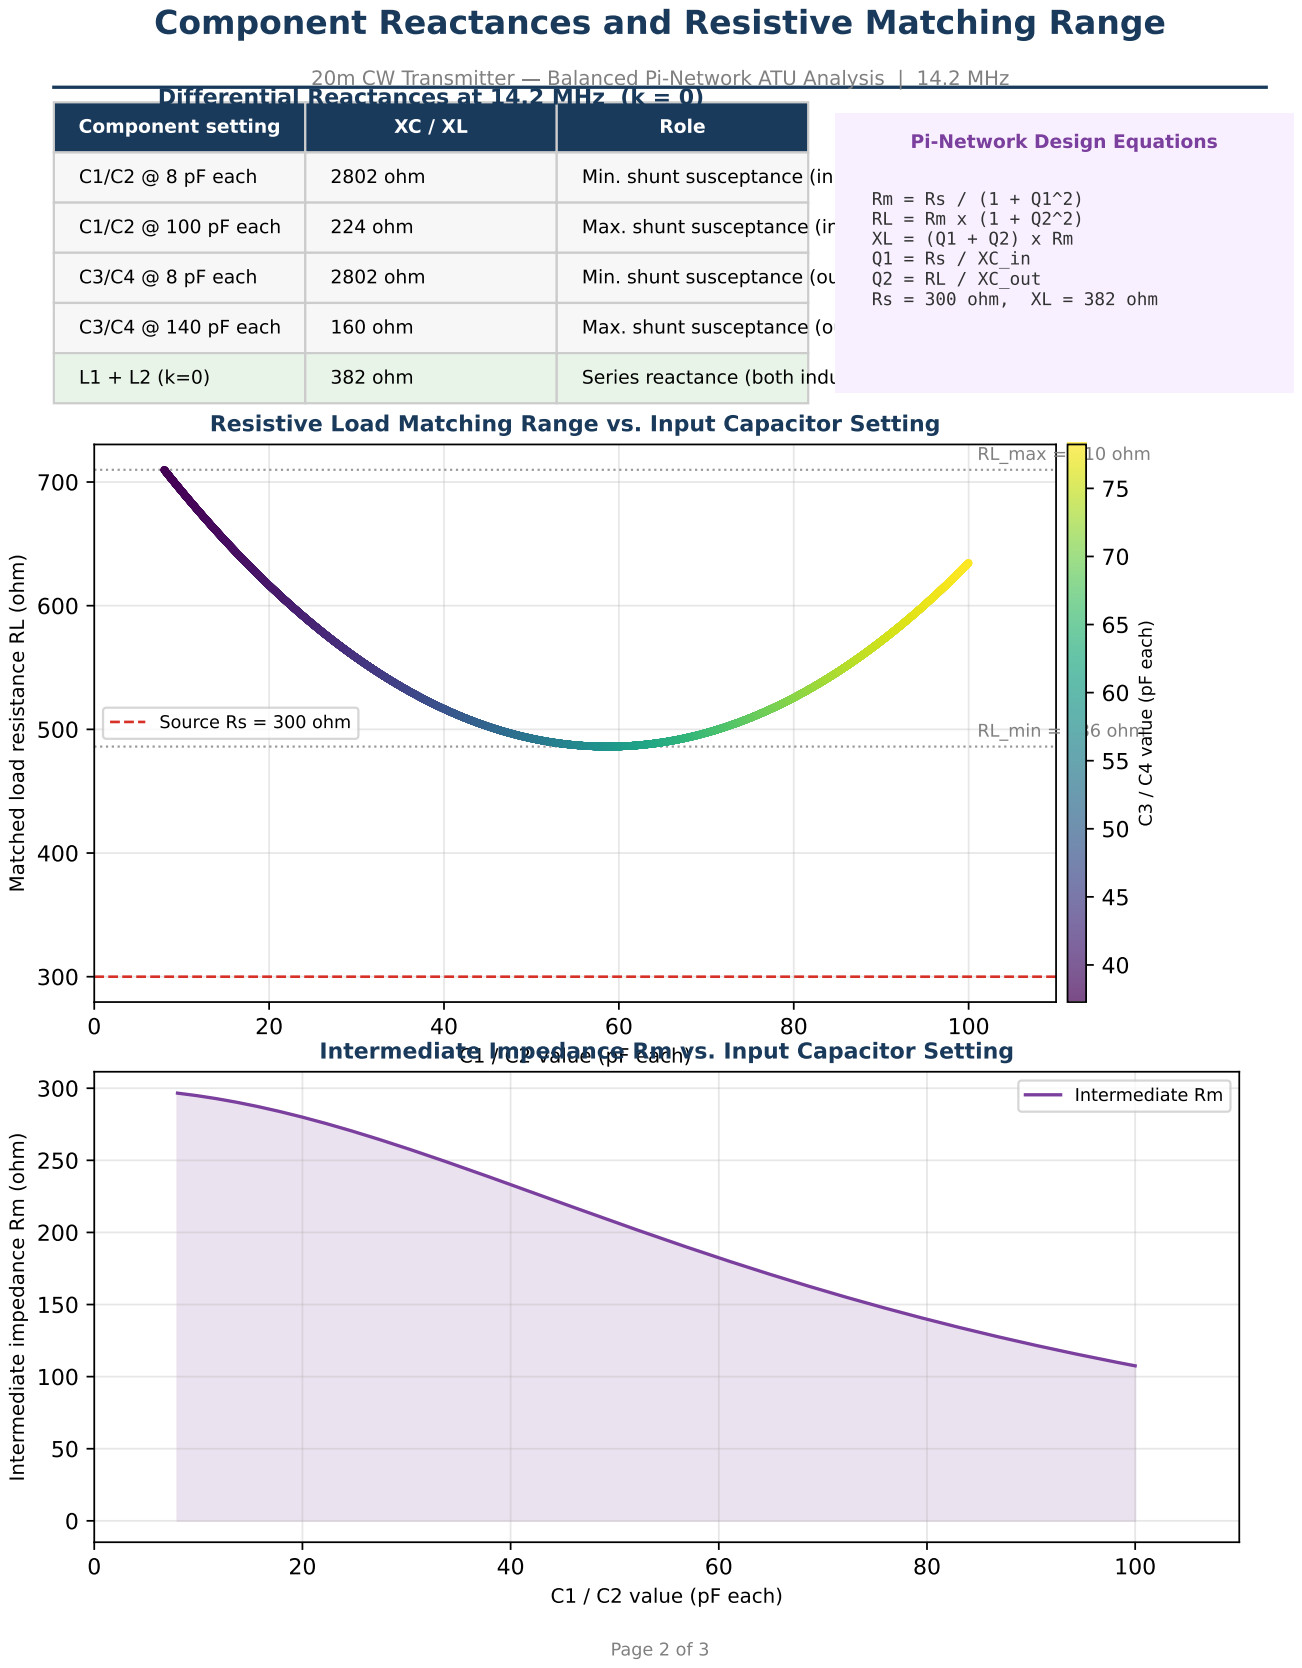
[picture p11: page 2]

500 | 400 | 300 | 200 | 100 | 0 | 100 | 200 | 300
Load reactance X (ohm) | antenna terminal, differential

+160
ohm

-382
ohm
Series inductors (k=0) | Output C3/C4 @ 140 pF

### Approximate Tunable Load Reactance Range

Inductive | loads (output | cap @ 140 pF: | XC = 160 ohm)
Capacitive loads (series | inductors: XL | = 382 ohm)

Inductive limit (+160 ohm): set by the maximum output capacitance (140 pF each). The output cap must resonate the inductive load component. Larger output caps extend this limit.

Capacitive limit (-382 ohm): set by the total series inductance (XL = 382 ohm, k=0). The inductor resonates a capacitive load; larger inductors extend this limit. Both bounds are conservative | the actual tunable range for complex loads is somewhat wider because the resistive and reactive parts interact.
Parameter | Value / Range
Frequency | 14.2 MHz (20m CW)
Source impedance | 300 ohm balanced
Each inductor | 2.14 uH -> XL = 191 ohm per inductor
Series XL (k=0, diff.) | 382 ohm (both inductors, push-pull drive)
Input caps C1/C2 | 8 pF - 100 pF each -> XC_diff: 224 - 2800 ohm
Output caps C3/C4 | 8 pF - 140 pF each -> XC_diff: 160 - 2800 ohm
Coupling constant | k = 0 (physically separate, non-coupled inductors)
Resistive load range | 486 - 710 ohm (always steps UP from 300 ohm source)
Max inductive load X | +160 ohm (output cap limited)
Max capacitive load X | -382 ohm (series inductor limited)
Approximate network Q | 1.1 - 1.3 across the tuning range

## Design Summary

Observations: The network steps the 300 ohm source UP to 486 - 710 ohm for purely resistive loads. It cannot match loads below ~486 ohm because the series inductance (382 ohm > Rs = 300 ohm) forces a minimum network Q of ~1.1. For a near-resonant folded dipole (~300 ohm +/- small X) this ATU works well. For low-impedance loads (short antenna, ground-mounted vertical) a different topology or smaller inductors would be needed. The inductive range (+160 ohm) may be limiting if the antenna operates well below resonance; larger output capacitors would extend it.

# Reactive Load Range and Design Summary

20m CW Transmitter Balanced Pi-Network ATU Analysis | 14.2 MHz
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
