agelders2021/xmitter/Documentation/driver_pushpull_6CL6.pdf

# Push-Pull 6CL6 RF Driver Stage

Class AB1 push-pull -- more drive headroom for the upgraded PA

## Why push-pull now

With the recent PA upgrade, single-ended 6CL6 was running near its plate dissipation limit. Going to a push-pull pair of 6CL6s splits the load between two tubes, giving substantial headroom while improving linearity and even-harmonic suppression in the driver itself.

## Architecture

Two 6CL6 tubes, mirror-image layout. Each tube drives one half of an interstage transformer with center-tapped primary AND center-tapped secondary. The secondary feeds the PA grids directly, with the secondary CT providing the bias return path. This new Tr_int replaces the existing Tr2 in the PA subcircuit.

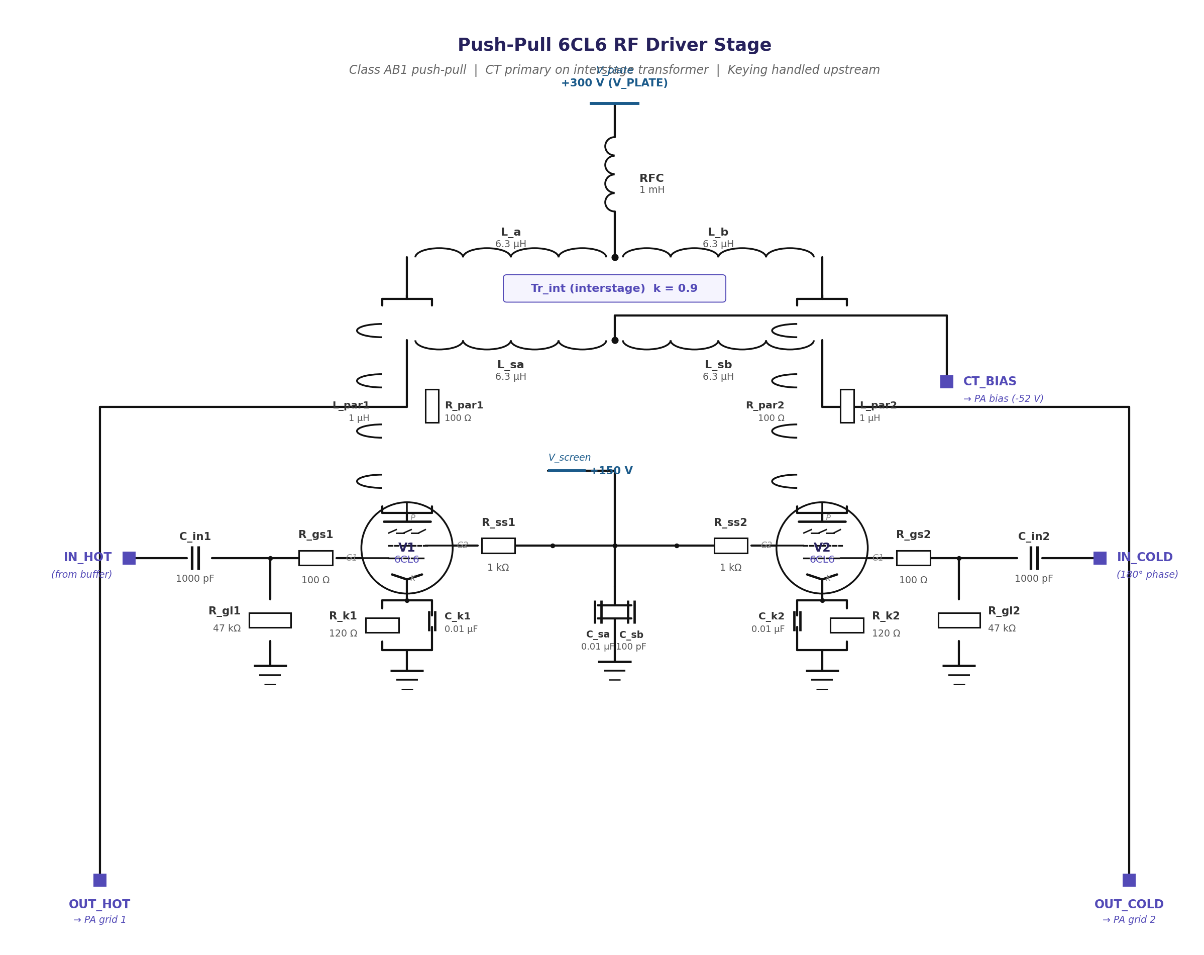
[picture p15: figure]

Figure 1 -- Push-pull 6CL6 driver schematic. Signal flow: IN_HOT/IN_COLD enter from the sides, drive the two grids through coupling caps and grid stoppers. Plates connect to the primary of Tr_int via plate parasitic suppressors. Primary CT goes through RFC to B+. Secondary endpoints route to OUT_HOT/OUT_COLD ports at the bottom; secondary CT becomes the CT_BIAS port for the PA bias return.

## Operating Point

Parameter | Value (per tube)
V_p (plate) | +300 V
V_g2 (screen) | +150 V
V_K (cathode) | +3 V (self-bias)
V_g1 (grid) | −3 V (relative to cathode)
I_p idle | ≈25 mA per tube
I_p peak | ≈60 mA per tube
I_g2 idle | ≈5 mA per tube
Plate dissipation idle | 7.5 W per tube
Class | AB1 push-pull
Combined output capability | ≈10 W to PA grids

## Component Values

Ref | Value | Notes
V1, V2 | 6CL6 | 9-pin beam pentode pair, matched
C_in1, C_in2 | 1000 pF / 500 V | Grid coupling caps
R_gl1, R_gl2 | 47 kΩ / 0.5 W | Grid-leak return to ground
R_gs1, R_gs2 | 100 Ω / 0.5 W | Grid stoppers at G1 pin
R_k1, R_k2 | 120 Ω / 1 W | Cathode self-bias resistors
C_k1, C_k2 | 0.01 µF / 50 V | Cathode bypass caps
R_ss1, R_ss2 | 1 kΩ / 2 W | Screen series stoppers
C_sa | 0.01 µF / 200 V | Screen HF bypass (shared bus)
C_sb | 100 pF / 200 V | Screen VHF bypass (shared bus)
L_par1, L_par2 | 1 µH | Plate parasitic suppressor chokes
R_par1, R_par2 | 100 Ω / 2 W | Plate parasitic damping resistors
RFC | 1 mH / 100 mA | CT-to-B+ choke
Tr_int | CT primary, CT secondary | Interstage transformer; replaces existing Tr2

## Keying Strategy

Keying happens in the buffer/phase-splitter stage that produces IN_HOT and IN_COLD. The driver itself runs continuously when the transmitter is powered. When the keying stage is open, no drive reaches the driver grids, the driver tubes draw only their idle plate current, and no RF reaches the PA.

## Advantages of upstream keying:

* Driver simplified -- no KEY switch in cathode or grid

* Bias network simpler -- both tubes share a clean self-bias setup

* The keying shaper (RC envelope) sees small-signal levels, much easier to design than driving a high-power cathode switching transistor

* No transient bias shift in the driver during keying

## Layout Considerations

Push-pull operation depends on physical symmetry. Important items for the real build:

1. Place V1 and V2 side-by-side with mirror-image wiring
2. Match plate lead lengths to within ~1/2 inch
3. Common screen bypass should be centered between the tubes, with equal-length leads to each tube's screen pin
4. RFC and B+ feed at the primary CT should be physically centered
5. Use matched-pair 6CL6 tubes if possible. If not, add small trimmers (200 Ω in series with each R_k) and adjust for equal plate currents

## Integration with PA Subcircuit

Required changes to PA_Subcircuit.sch:

* Remove the existing Tr2 (L1, L2, L3 and their three K-coupling elements)
* Remove R12 and R13 (the 1Ω series resistor and 1 MΩ DC reference that were associated with the old Tr2 primary)

* Update PA ports from {IN_HOT, IN_COLD, OUT_HOT, OUT_COLD} to {GRID_1, GRID_2, BIAS_IN, OUT_HOT, OUT_COLD}

* Wire the new GRID_1 port directly to V1 grid (through the existing R2 grid stopper and C3 coupling cap which stay in place)
* Wire BIAS_IN through the existing R4/R8 bias isolation resistors to the grid bias junctions

* Same for V2 side: GRID_2 to V2 grid, BIAS_IN reaches both via the existing isolation resistors

## Top-level wiring in Xmitter_top.sch:

Driver_PP_Subcircuit.sch ports {OUT_HOT, OUT_COLD, CT_BIAS} connect to PA_Subcircuit.sch ports {GRID_1, GRID_2, BIAS_IN}. The -52 V bias supply at the top level connects to CT_BIAS directly (the secondary CT of Tr_int will feed it through to both PA grids via the in-PA bias network).

## Simulation Plan

1. Build Driver_PP_Subcircuit.sch with the components shown
2. Test the driver in isolation first: load OUT_HOT/OUT_COLD with a 10 kΩ differential resistor (representing the PA grid loading), drive IN_HOT and IN_COLD with two anti-phase sine sources at 0.1 V, 14.2 MHz. Verify clean differential output at

~30-50 V pk-pk

3. Adjust Tr_int turns ratio if needed for the load impedance
4. Modify PA_Subcircuit.sch as described, save
5. Update Xmitter_top.sch with the new driver-PA wiring
6. Use the same IC and NODESET pattern we developed for the PA, but now also need IC values for the driver plate nodes (≈+300 V) and cathode nodes (≈+3 V)

## Tube Model Note

Verify tube.lib has a 6CL6 model. If not, the 12BY7A model is a close electrical equivalent and can be substituted for simulation purposes. A 6AG7 model would also work with slightly different bias point.
