agelders2021/xmitter/Documentation/flat-toroid.jpg

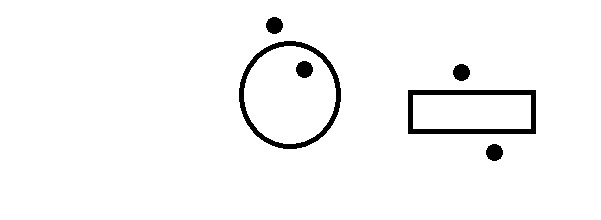
Documentation/flat-toroid.jpg
