agelders2021/xmitter/xmitter_prj/12by7a_pchar.png

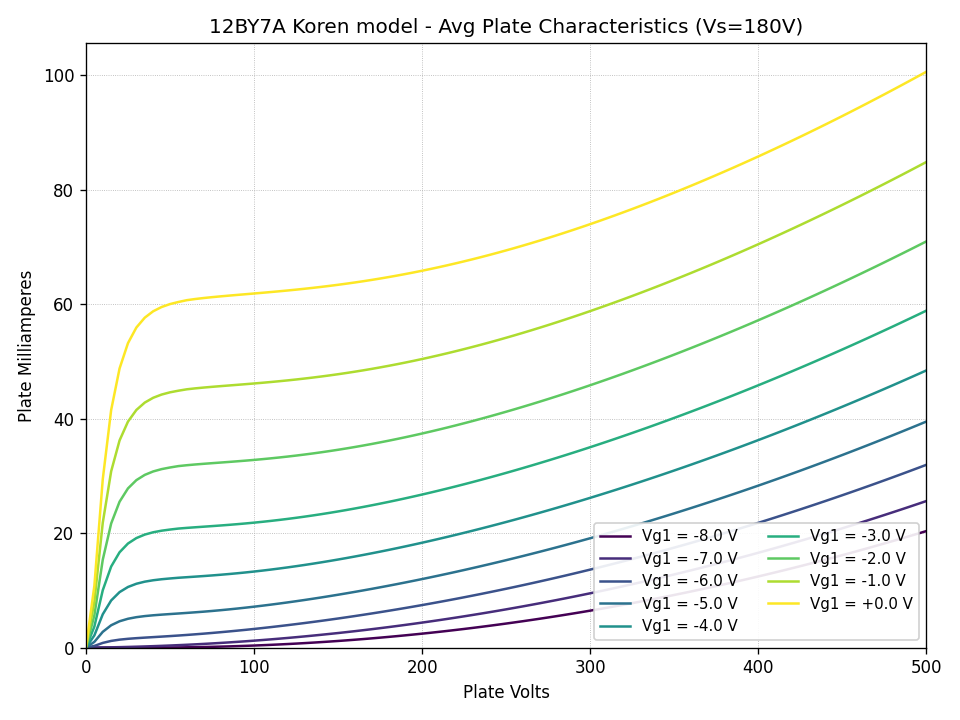
xmitter_prj/12by7a_pchar.png
