agelders2021/xmitter/xmitter_prj/12hg7_pchar.png

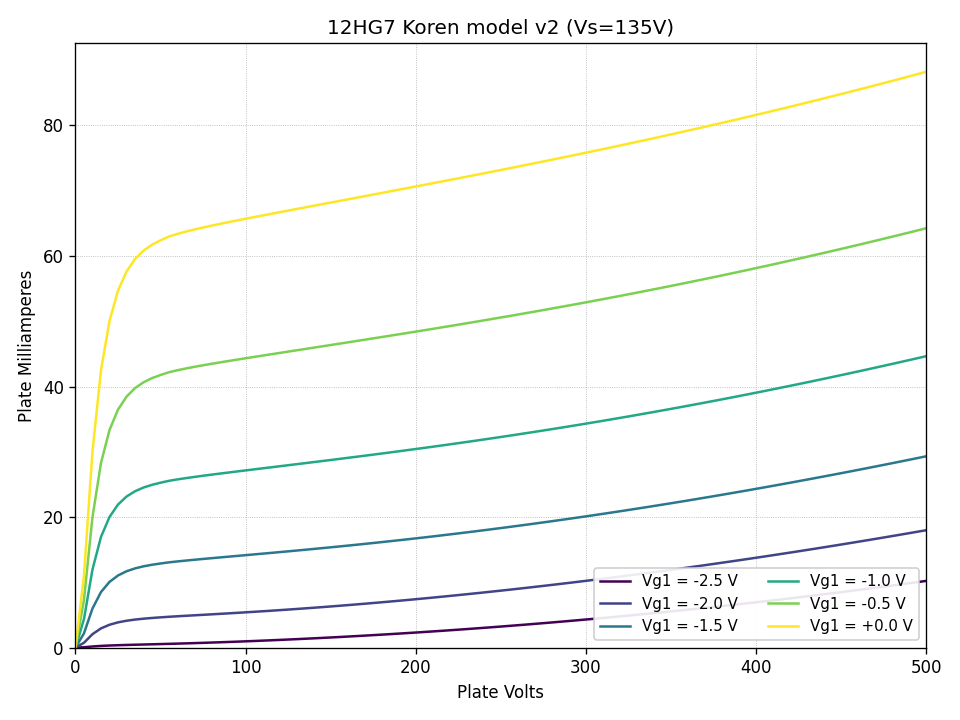
xmitter_prj/12hg7_pchar.png
