agelders2021/xmitter/xmitter_prj/6146b_pchar.png

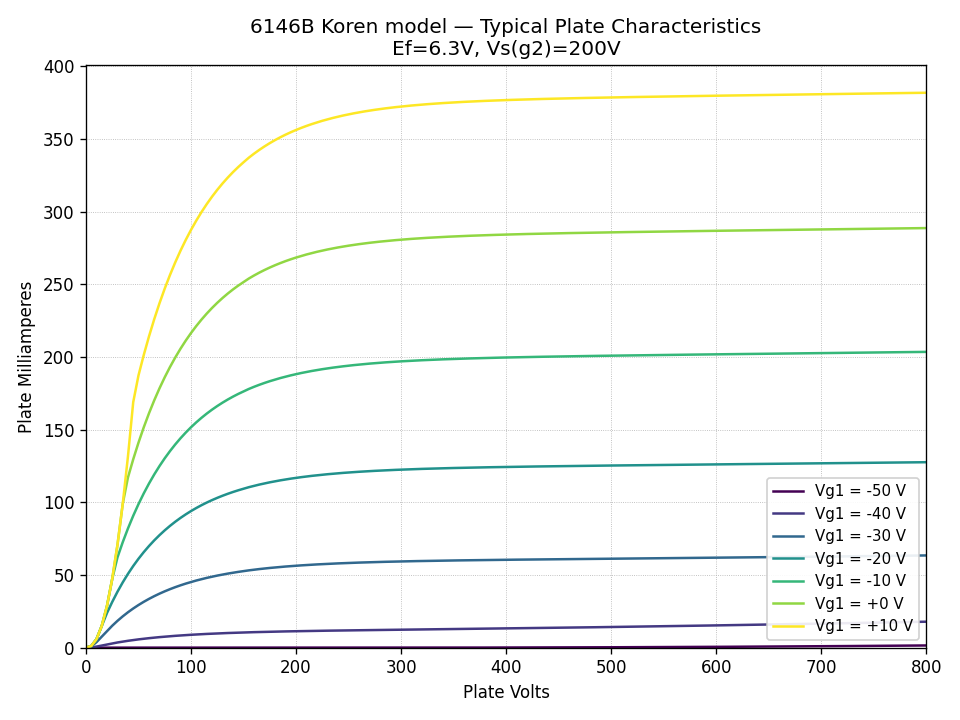
xmitter_prj/6146b_pchar.png
