agelders2021/xmitter/Documentation/VFO_Keyer_Order.xlsx

Sheet: VFO + Keyer Order
Section | Ref | Value / Description | Package | Qty | On Hand | Ordered | Received | Ordered From | Mfr P/N | Mouser P/N | Digi-Key P/N | Unit $ | Ext $ | Notes
VFO |  | --- Si5351 module + jumper hardware ---
VFO | U1 | Adafruit Si5351A STEMMA QT breakout | breakout | 1 | 1 | 1 |  | Adafruit | Adafruit 5566 |  | 1528-5566-ND | $11.95 |  | OWN this; Adafruit P/N 5566. Adafruit-only part. | Adafruit PID 5640
VFO | MTG | M2.5 x 10 mm nylon standoff (F-F) | mech | 4 |  | 10 |  | M |  | 855-R30-1001003 | 36-3475-ND | $0.60 |  | Corner standoffs for Si5351 | Essentra spacers (not threaded)
VFO | SCR | M2.5 x 5 mm nylon pan-head screw | mech | 8 |  | 10 |  | M |  | 534-29390 | 36-29390-ND | $0.20 |  | 2 per standoff
VFO | WIRE | 24 AWG insulated hookup wire (asst colors) | wire | 1 |  | 20 |  |  |  | 602-9314-4-100-NC025 |  | $12.00 |  | For 7 jumpers Si5351 to PCB + general use | Use existing 24 AWG hookup wire stock
VFO |  | --- VFO input + pi pad + 7-pole LPF ---
VFO | RS | 0 ohm 1/4W metal film (damping option) | axial THT | 1 | 1 |  |  |  |  | 603-MFR-25FBF52-0R0 |  | $0.10 |  | Optional damper, default 0R | Have 0Ω in stock
VFO | C_coup | 10 nF NPO/C0G ceramic 100V 5% | radial disc D5mm | 1 |  | 10 |  | M |  | 581-SR152A103JAR |  | $0.45 |  | Si5351 CLK0 to pi pad coupling; blocks 1.65V offset | Vishay Y5P 10nF (fine for DC blocking)
VFO | RP1, RP3 | 62 ohm 1% metal film 1/4W | axial THT | 2 |  | 20 |  | M |  | 603-MFR-25FRF52-62R |  | $0.10 |  | Pi pad input shunt; Pi pad output shunt
VFO | RP2 | 240 ohm 1% metal film 1/4W | axial THT | 1 |  | 10 |  | M |  | 603-MFR-25FRF52-240R |  | $0.10 |  | Pi pad series
VFO | CF1, CF7 | 220 pF silver mica 500V 5% (or 240 if surplus) | axial THT | 2 |  | 4 |  | M | CD15FD221JO3F | 598-CD15FD221JO3F | CD15FD221JO3F-ND | $1.85 |  | LPF outer; surplus item 189 (240pF) acceptable; Same as CF1 | Surplus 240pF × 5 (item 189) + Mouser 220pF × 4 — KEEP ONE, REMOVE OTHER
VFO | CF3, CF5 | 390 pF silver mica 500V 5% | axial THT | 2 |  | 5 |  | Surplus | CD15FD391JO3F | 598-CD15FD391JO3F | CD15FD391JO3F-ND | $1.95 |  | LPF; surplus item 192 exact match | Surplus item 192 (390pF × 5)
VFO | L2-6 | T68-6 iron-powder toroid core | toroid | 5 |  | 14 |  | eBay+Surplus |  |  |  | $0.85 |  | KitsAndParts.com only - neither Mouser nor DK stocks Micrometals cores | Amidon eBay (4) + surplus (10) = 14 T68-6 cores
VFO | WIRE2 | #24 AWG enameled magnet wire (1/4 lb spool) | spool | 1 |  |  |  |  |  |  |  | $8.00 |  | KitsAndParts.com - neither Mouser nor DK stocks ham magnet wire | KitsAndParts #24 AWG 1/4 lb — separate order still needed
VFO | RT1 | 50 ohm 1% metal film 1/4W | axial THT | 1 |  | 5 |  | M |  | 603-MFR-25FRF52-49R9 |  | $0.10 |  | LPF output termination (49.9 ohm = nearest E96) | 50Ω termination
VFO | RGL | 1 Mohm 1% metal film 1/4W | axial THT | 1 | 1 |  |  |  |  | 603-MFR-25FRF52-1M |  | $0.10 |  | MC1496 carrier-port grid-leak; ADD TO SCH | Have 1MΩ in stock
VFO |  | --- J310 source follower buffer (optional, can jumper-bypass) ---
VFO | Q1 | J310 N-channel JFET | TO-92 | 2 |  | 4 |  | M | J310 | 512-J310 | J310-ND | $0.85 |  | 1 + 1 spare; static-sensitive
VFO | R6_V | 270 ohm 1% metal film 1/4W | axial THT | 1 |  | 5 |  | M |  | 603-MFR-25FRF52-270R |  | $0.10 |  | J310 source resistor | 270Ω
VFO | CC1 | 10 nF NPO/C0G ceramic 100V | radial disc D5mm | 1 |  | 10 |  |  |  | 581-SR152A103JAR |  | $0.45 |  | J310 output coupling to MC1496
KEYER |  | --- MC1496 keyer + bias network ---
KEYER | U2 | MC1496P balanced modulator | DIP-14 | 2 |  | 5 |  | eBay | MC1496P | 511-MC1496P | MC1496PG-ND | $2.45 |  | 1 + 1 spare; static-sensitive | eBay 5pcs MC1496PG ($15.30)
KEYER | XU2 | DIP-14 IC socket, machined pin | DIP-14 socket | 1 |  | 4 |  | M | Mill-Max 110-43-314 (machined) | 575-1102873 | AE9990-ND | $0.85 |  | Mill-Max machined preferred over stamped | Mill-Max premium machined
KEYER | R1, R3, R4 | 51 ohm 1% metal film 1/4W | axial THT | 3 |  | 6 |  | M |  | 603-MFR-25FRF52-51R |  | $0.10 |  | MC1496 carrier port termination; MC1496 modulator port; Modulator port + DAC injection shunt at pin 1
KEYER | R2 | 6.8 kohm 1% metal film 1/4W | axial THT | 1 |  | 10 |  | M |  | 603-MFR-25FRF52-6K8 |  | $0.10 |  | MC1496 Iee setting (pin 5) | 6.8kΩ
KEYER | RLa, RLb | 3.9 kohm 1% metal film 1/4W (match w/ RLb) | axial THT | 2 |  | 6 |  | M |  | 603-MFR-25FRF52-3K9 |  | $0.10 |  | Output load; order 4-5 and match by DMM; See RLa note | Yageo 0.5% precision (better than spec)
KEYER | R5, R7, R9, R10 | 8.2 kohm 1% metal film 1/4W | axial THT | 4 | 4 | 8 |  | M |  | 603-MFR-25FRF52-8K2 |  | $0.10 |  | PNP T1 base (symmetry); PNP T2 base (symmetry; match R5); PNP null injection | Have 8.2k in stock — can REMOVE from cart
KEYER | R6_K, R8_K | 2.7 kohm 1% metal film 1/4W | axial THT | 2 |  | 6 |  | M |  | 603-MFR-25FRF52-2K7 |  | $0.10 |  | PNP T1 collector bias; PNP T2 collector bias (match R6_K)
KEYER | R11, R12 | 22 kohm 1% metal film 1/4W | axial THT | 2 | 2 |  |  |  |  | 603-MFR-25FRF52-22K |  | $0.10 |  | Carrier bias divider top; Carrier bias divider bottom | Have 22k in stock
KEYER | R13 | 1.5 kohm 1% metal film 1/4W | axial THT | 1 | 1 |  |  |  |  | 603-MFR-25FRF52-1K5 |  | $0.10 |  | Modulator input divider | Have 1.5k in stock
KEYER | Re | 2.0 kohm 1% metal film 1/4W | axial THT | 1 | 1 |  |  |  |  | 603-MFR-25FRF52-2K |  | $0.10 |  | MC1496 emitter degen (gain set) | Have 2k in stock
KEYER | C1 | 330 pF NPO/C0G ceramic 100V (or silver mica) | radial disc D5mm | 1 |  | 5 |  | Surplus | CD15FD331JO3F (silver mica option) | 581-SR152A331JAR |  | $0.45 |  | Carrier port coupling; surplus item 191 also fine | Surplus item 191 (330pF silver mica × 5)
KEYER | C2 | 0.1 uF X7R ceramic 50V | radial 5mm | 2 |  | 5 |  | mou |  | 80-C320C104K5R | 399-9866-ND | $0.20 |  | MC1496 pin 10 bypass + 1 spare
KEYER | T1 | 2N3906 PNP general-purpose | TO-92 | 4 |  | 5 |  | M | 2N3906 | 610-2N3906 | 2N3906FS-ND | $0.20 |  | PNP null injection; buy 4 and pair by Vbe | 2N3906 PNP; match by Vbe
KEYER | T2 | 2N3906 (covered above) | TO-92 | 0 |  |  |  |  |  |  |  |  |  | Paired with T1 from the 4 ordered
KEYER |  | --- LM7171 differential post-amps (one per MC1496 output side) ---
KEYER | U3,4 | LM7171AIN high-speed op-amp | DIP-8 | 3 | 4 | 4 |  | M | LM7171AIN/NOPB | 926-LM7171AIN/NOPB | LM7171AIN/NOPB-ND | $7.95 |  | 2 needed + 1 spare | LM7171BIN (B grade, not A — fine for AC-coupled RF use)
KEYER | XU3,4 | DIP-8 IC socket, machined pin | DIP-8 socket | 3 | 4 | 4 |  | M | (machined) | 575-1102871 | AE9986-ND | $0.55 |  | For LM7171 x 2 + MCP4921 | Mill-Max DIP-8 machined
KEYER | C_IN, C_OUT | 100 nF X7R ceramic 50V | radial 5mm | 8 |  | 30 |  | m | m | 80-C320C104K5R | 399-9866-ND | $0.20 |  | 2 per LM7171 input AC couple; 2 per LM7171 output AC couple
KEYER | R_B | 100 kohm 1% metal film 1/4W | axial THT | 2 | 2 |  |  |  |  | 603-MFR-25FRF52-100K |  | $0.10 |  | LM7171 input bias | Have 100k in stock — REMOVE from cart (qty 5)
KEYER | R_F | 47 kohm 1% metal film 1/4W | axial THT | 2 | 2 |  |  |  |  | 603-MFR-25FRF52-47K |  | $0.10 |  | LM7171 feedback (gain 5.8) | Have 47k in stock — REMOVE from cart (qty 5)
KEYER | R_G | 10 kohm 1% metal film 1/4W | axial THT | 2 | 2 | 5 |  | M | m | 603-MFR-25FRF52-10K |  | $0.10 |  | LM7171 inverting leg to GND | Have 10k 1% in stock; ordered 0.1% precision (optional upgrade)
KEYER |  | --- Envelope DAC + reconstruction LPF ---
KEYER | U5 | MCP4921-E/P 12-bit SPI DAC | DIP-8 | 2 | 2 | 2 |  | eBay | MCP4921-E/P | 579-MCP4921-E/P | MCP4921-E/P-ND | $3.25 |  | 1 + 1 spare | eBay 2pcs MCP4921 DIP-8 ($17.43) — REMOVE Mouser line 22
KEYER | R_F_D | 1.5 kohm 1% metal film 1/4W | axial THT | 1 | 1 |  |  |  |  | 603-MFR-25FRF52-1K5 |  | $0.10 |  | DAC output to MC1496 pin 1 | Have 1.5k in stock (same as R13)
KEYER | C_F | 680 nF polypropylene film (MKP) 63V+ | box 5mm | 2 |  | 4 |  | M | Wima MKP4 680 nF / 63 V | 871-B32921C3684K | 495-1395-ND | $1.20 |  | DAC reconstruction LPF + 1 spare | WIMA MKP4 680nF/100V
KEYER |  | --- Per-IC supply bypass (one cap per supply pin) ---
KEYER | CB_IC | 100 nF X7R ceramic 50V (per-IC bypass) | radial 5mm | 10 |  | 30 |  | M |  | 80-C320C104K5R | 399-9866-ND | $0.20 |  | 1 at MC1496 pin 7 + 4 at LM7171 supplies + 1 at MCP4921 + spares | Kemet 0.1uF X7R × 30 (covers C2/C_IN/C_OUT/bypass)
KEYER | CB_BLK | 10 uF tantalum 25V (per-rail bulk) | radial 5mm | 4 |  | 10 |  | M | Kemet T350F106K025AT | 80-T350F106K025AT | 399-3801-ND | $0.85 |  | Bulk: +12V, -8.3V, +5V, +3.3V | Aluminum electrolytic ECA-1EM100 (substituted from tantalum, saved $13)
KEYER | U_NULL | MCP4728 (Adafruit 4470 breakout) | Breakout PCB, 0.1" 10-pin header | 1 | 1 | 1 | 1 | Adafruit | Adafruit 4470 |  |  |  |  | Quad 12-bit I2C DAC. Used for digital carrier null (2 ch) + spare (2 ch). Factory addr 0x60 collides with Si5351 — reprogram EEPROM to 0x62 in firmware bring-up (LDAC sequence). Wire LDAC to ESP32 GPIO.
POWER |  | --- Power input terminal block + -8.3V derivation from -90V ---
POWER | J_PWR | 2-pos screw terminal block 5.08 mm pitch (3 blocks = 6 positions for 5 rails) | THT 2pos × 3 | 3 |  | 3 |  | M |  | 651-1715022 | 277-1273-ND | $1.85 |  | 5-pos (1715061) was out of stock; using 3 × 2-pos for 6 total positions. Suggested rail groupings: (+12V, GND) (+5V, GND) (-8.3V, -90V). Phoenix Contact MKDSN 1,5/2-5,08.
POWER | D1 | 1N4738A 8.2V zener 1W | DO-41 | 5 |  | 8 |  | M | 1N4738A | 512-1N4738A | 1N4738A-TPCT-ND | $0.18 |  | -8.3V derivation from -90V + spares
POWER | R_DROP | 15 kohm 1W metal film resistor | axial 1W | 2 |  | 5 |  | M |  | 603-PR01000101502JR500 |  | $0.55 |  | -8.3V dropper from -90V rail + 1 spare | 15kΩ 1W (different from 1/4W stock)
CONN |  | --- Off-board connectors / headers ---
CONN | J_RFOUT | 3-pin male header 0.1" pitch | THT 1x3 | 1 |  | 2 |  | M |  | 649-69190-403HLF | S1011E-03-ND | $0.50 |  | RF output to driver: HOT+, HOT-, GND
CONN | J_SPI | 5-pin male header 0.1" pitch | THT 1x5 | 1 |  | 2 |  | M |  | 649-69190-405HLF | S1011E-05-ND | $0.55 |  | SPI to MCU: SCK, MOSI, CS, LDAC, GND
CONN | J_PAD | 2-pin male header 0.1" pitch | THT 1x2 | 1 |  | 2 |  | M |  | 649-69190-402HLF | S1011E-02-ND | $0.45 |  | Paddle dit/dah input (or use jumper wires)
CONN | WIRE3 | Hookup wire kit 22 AWG (6 colors) | wire | 1 |  |  |  |  |  | 602-9314-4-100-WT005 |  | $30.00 |  | Inter-board + paddle wiring; OWN already? | Use existing hookup wire stock
TEST |  | --- Bench bring-up extras (not on PCB) ---
TEST | PROBE | 50 ohm BNC bulkhead jack | panel | 2 |  |  |  |  |  | 523-31-221-RFX | ACX1230-ND | $6.50 |  | Scope tap-offs at LPF out and MC1496 out (optional) | Optional, defer
 |  |  |  |  |  |  |  |  |  |  | TOTAL:

Sheet: Instructions
VFO + Keyer Parts Order - Instructions
Columns:
Section VFO / KEYER / POWER / CONN / TEST
Ref Reference designator from the KiCad schematic
Value Spec to order (value + tolerance + voltage)
Package Physical form factor for the PCB footprint
Qty Number to order (includes spares where critical)
On Hand Mark X if you already have it in stock
Ordered Mark X when the PO goes out
Received Mark X when the parts arrive
Ordered From Which supplier you actually ordered from (M / DK / A / KP)
Mouser P/N Mouser catalog number
Digi-Key P/N Digi-Key catalog number (where known; some parts left blank
because Yageo MFR-25 axial resistor P/Ns vary by value - search
Digi-Key for "Yageo MFR-25" + value + tolerance)
Unit $ Estimated unit price (verify when ordering)
Ext $ Auto = Qty x Unit $
Notes Substitutions, matching requirements, gotchas
Sections:
VFO Si5351 module + jumper hardware + pi pad + 7-pole LPF + J310 buffer
KEYER MC1496 + bias network + PNP null injection + LM7171 post-amps + MCP4921 envelope DAC
POWER Power input terminal block + bulk bypass + -8.3V derivation from -90V
CONN Off-board headers (SPI, RF out, paddle)
TEST Bench bring-up extras (BNC tap-offs for scope, etc.)
Bench bring-up notes:
- Bench supplies provide +12V, -8.3V, +5V (and -90V if testing on-board zener+dropper)
- First bring-up: bypass J310 source follower with 0R jumper at Q1 footprint
- Match PNP transistors T1/T2 by DMM Vbe (~5mV tolerance) for cleanest carrier null
- Match RLa/RLb (3.9k) by DMM for differential balance (~1% tolerance)
- MC1496 R4 (51 ohm at pin 1) forms divider with R_F_D (1.5k); sets envelope DAC scale
NOT included on this list (separate orders):
- WH2004A LCD display (separate parts list when display section is built)
- Rotary encoder + paddle key (your choice; not blocking bench bring-up)
- MCU board (Adafruit Metro ESP32-S3 - already owned)
- PA-side parts: bias DAC MCP4728, OPA454, cathode monitor, MCP23017 GPIO expander
- Power supply transformers, mains hardware, chassis
