agelders2021/xmitter/Documentation/Parts_List.xlsx

Sheet: xmitter.sch
xmitter.sch
18 components
Reference | Type | Value | Type / Spec (core, voltage, wattage)
R1 | R | 50Ohm | Metal film 1/4 W 1 % 50Ohm (default; check operating power)
R6 | R | 1MOhm | Metal film 1/4 W 1 % 1MOhm (default; check operating power)
R7 | R | 1 MOhm | Metal film 1/4 W 1 % 1 MOhm (default; check operating power)
R8 | R | 1 MOhm | Metal film 1/4 W 1 % 1 MOhm (default; check operating power)
V2 | Vac | {V_IN} | Voltage source: {V_IN} (rail or test source)
V1 | Vac | {V_IN} | Voltage source: {V_IN} (rail or test source)
V3 | Vdc | 275 V | Voltage source: 275 V (rail or test source)
LPF | Sub | LPF_50ohm_subcircuit.sch | Sub-schematic instance: LPF_50ohm_subcircuit.sch
V4 | Vrect | 3.3 V | 3.3 V
V6 | Vdc | 0V | Voltage source: 0V (rail or test source)
Balun | Sub | Balun_6to1_subcircuit.sch | Sub-schematic instance: Balun_6to1_subcircuit.sch
Driver_transformer | Sub | Driver_output_transformer_subcircuit.sch | Sub-schematic instance: Driver_output_transformer_subcircuit.sch
VFO_SUB | Sub | vfo_subcircuit.sch | Sub-schematic instance: vfo_subcircuit.sch
V5 | Vdc | 1.65V | Voltage source: 1.65V (rail or test source)
Driver | Sub | Driver_subcircuit.sch | Sub-schematic instance: Driver_subcircuit.sch
KEYER | Sub | keyer.sch | Sub-schematic instance: keyer.sch
V7 | Vdc | 3.3V | Voltage source: 3.3V (rail or test source)
PA | Sub | PA_subcircuit.sch | Sub-schematic instance: PA_subcircuit.sch

Sheet: vfo_subcircuit.sch
vfo_subcircuit.sch |  |  |  | Need to order
19 components
Reference | Type | Value | Type / Spec (core, voltage, wattage)
VIN | Vac | 1 V | Voltage source: 1 V (rail or test source)
RS | R | 50 Ohm | Metal film 1/4 W 1 % 50 Ω (Si5351 source termination) | x
RT | R | 50 Ohm | Metal film 1/4 W 1 % 50 Ω (LPF load termination) | x
CC1 | C | 10 nF | Ceramic NP0 50 V, 10 nF (J310 gate AC-coupling) | x
RGL | R | 1 MOhm | Metal film 1/4 W 1 % 1 MΩ (J310 gate leak)
VDD | Vdc | 12 V | Voltage source: 12 V (rail or test source)
RS1 | R | 270 Ohm | Metal film 1/4 W 1 % 270 Ω (J310 source bias) | x
T1_J310 | JFET | nfet | JFET (nfet) | x (2)
V2 | Vrect | 3.3 V | 3.3 V
CF1 | C | 220 pF | Silver mica or C0G ceramic, 50 V, 5 %, 220 pF | x
LF2 | L_SPICE | 647nH | 11 t #22 AWG enam. on T68-6 (yel., A_L=5.7 nH/N^2, OD 17.5 / ID 9.4 mm). Target 647 nH; 11 t gives ~690 nH -- spread turns slightly to trim down. Alt core: T50-6 @ 13 t. | x
CF7 | C | 220 pF | Silver mica or C0G ceramic, 50 V, 5 %, 220 pF | x
LF6 | L_SPICE | 647nH | 11 t #22 AWG enam. on T68-6. Same as LF2 (647 nH). Alt core: T50-6 @ 13 t. | x
LF4 | L_SPICE | 715nH | 11 t #22 AWG enam. on T68-6. Target 715 nH; 11 t gives ~690 nH -- bunch turns slightly to trim up. Alt core: T50-6 @ 14 t. | x
CF3 | C | 390 pF | Silver mica or C0G ceramic, 50 V, 5 %, 390 pF (or 360 + 27 pF parallel) | x
CF5 | C | 390 pF | Silver mica or C0G ceramic, 50 V, 5 %, 390 pF | x
RP1 | R | 62 Ohm | Metal film 1/4 W 1 % 62 Ω (E24) or 61.9 Ω (E96) | x
RP2 | R | 240 Ohm | Metal film 1/4 W 1 % 240 Ω (E24) or 249 Ω (E96) | x
RP3 | R | 62Ohm | Metal film 1/4 W 1 % 62 Ω (E24) or 61.9 Ω (E96) | x

Sheet: keyer.sch
keyer.sch |  |  |  | Need to order
34 components
Reference | Type | Value | Type / Spec (core, voltage, wattage)
X1 | SpLib | C:/Users/AlAnd/Git Backed Projects/xmitter/xmitter_prj/MC1496_MODEL.cir | MC1496 / LM1496 (DIP-14 or SO-14) -- balanced modulator
RLa | R | 3.9kOhm | Metal film 1/4 W 1 % 3.9 kΩ (MC1496 load to +12 V) | x
RLb | R | 3.9kOhm | Metal film 1/4 W 1 % 3.9 kΩ (MC1496 load to +12 V) | x
V1 | Vdc | 12 V | Voltage source: 12 V (rail or test source)
R1 | R | 51Ohm | Metal film 1/4 W 1 % 51 Ω (carrier port termination) | x
R2 | R | 6.8 kOhm | Metal film 1/4 W 1 % 6.8 kΩ (MC1496 R_BIAS, pin 5 to GND) | x
R3 | R | 51Ohm | Metal film 1/4 W 1 % 51 Ω (signal port pin 4 bias to GND) | x
R4 | R | 51Ohm | Metal film 1/4 W 1 % 51 Ω (signal port pin 1 bias to GND)
T1 | _BJT | pnp | BJT (pnp) | x
T2 | _BJT | pnp | BJT (pnp) | x
V6 | Vdc | 8.3 V | Voltage source: 8.3 V (rail or test source)
C1 | C | 330pF | Ceramic NP0 100 V, 330 pF, 5 % (carrier coupling to pin 10) | x
C2 | C | 0.1uF | Ceramic NP0 100 V, 0.1 µF (pin 8 AC bypass) | x
V7 | Vdc | 8.3 V | Voltage source: 8.3 V (rail or test source)
V4 | Vdc | 5V | Voltage source: 5V (rail or test source)
R7 | R | 8.2kOhm | Metal film 1/4 W 1 % 8.2 kΩ (null PNP collector load to VEE)
R9 | R | 8.2kOhm | Metal film 1/4 W 1 % 8.2 kΩ (null injection R_INJ to MC1496 pin 1)
R6 | R | 2.7kOhm | Metal film 1/4 W 1 % 2.7 kΩ (null PNP emitter to +5 V) | x
R8 | R | 2.7kOhm | Metal film 1/4 W 1 % 2.7 kΩ (null PNP emitter to +5 V) | x
R5 | R | 8.2kOhm | Metal film 1/4 W 1 % 8.2 kΩ (null PNP collector load to VEE)
R11 | R | 22 kOhm | Metal film 1/4 W 1 % 22 kΩ (pin 8 bias divider, top)
R12 | R | 22kOhm | Metal film 1/4 W 1 % 22 kΩ (pin 8 bias divider, bottom)
R13 | R | 1.5 kOhm | Metal film 1/4 W 1 % 1.5 kΩ (envelope LPF series; also signal-port pin 1 divider top)
C3 | C | 680nF | Film MKT/MKP 50 V, 680 nF (envelope reconstruction LPF, to GND at pin 1) | x
R10 | R | 8.2 kOhm | Metal film 1/4 W 1 % 8.2 kΩ (null injection R_INJ to MC1496 pin 4)
V10 | Vrect | 3.3 V | 3.3 V
OP_AMP2 | Sub | Op_Amp_Out.sch | Sub-schematic instance: Op_Amp_Out.sch
OP_AMP1 | Sub | Op_Amp_Out.sch | Sub-schematic instance: Op_Amp_Out.sch
VFO_SUB1 | Sub | vfo_subcircuit.sch | Sub-schematic instance: vfo_subcircuit.sch
V8 | Vdc | 1.65 V | Voltage source: 1.65 V (rail or test source) | x
R15 | R | 1 MOhm | Metal film 1/4 W 1 % 1 MOhm (default; check operating power)
R16 | R | 1 MOhm | Metal film 1/4 W 1 % 1 MOhm (default; check operating power)
Re | R | 2000Ohm | Metal film 1/4 W 1 % 200 Ω (MC1496 R_E, pins 2-3) | x
V9 | Vdc | 0.0 V | Voltage source: 0.0 V (rail or test source)

Sheet: Op_Amp_Out.sch
Op_Amp_Out.sch
5 components
Reference | Type | Value | Type / Spec (core, voltage, wattage)
R1 | R | 100kOhm | Metal film 1/4 W 1 % 100 kΩ (op-amp + input bias to GND)
RF | R | 30 kOhm | Metal film 1/4 W 1 % 47 kΩ (LM7171 feedback; gain = 5.8)
C_IN | C | 100 nF | Ceramic X7R 50 V, 100 nF (op-amp + input AC coupling)
C_OUT | C | 100 nF | Ceramic X7R 50 V, 100 nF (op-amp output AC coupling)
RG | R | 10 kOhm | Metal film 1/4 W 1 % 10 kΩ (LM7171 inverting input leg to GND)

Sheet: Driver_subcircuit.sch
Driver_subcircuit.sch
26 components
Reference | Type | Value | Type / Spec (core, voltage, wattage)
SUB1 | SpLib | C:/Users/AlAnd/Git Backed Projects/xmitter/xmitter_prj/12hg7_koren.lib | SPICE library device: C:/Users/AlAnd/Git Backed Projects/xmitter/xmitter_prj/12hg7_koren.lib
R2 | R | 1 kOhm | Metal film 1 W 1 % 1 kΩ (screen dropper)
R4 | R | 47 kOhm | Metal film 1/4 W 1 % 47 kΩ (grid leak)
R1 | R | 100Ohm | Carbon comp or metal oxide 1 W 100 Ω (grid stopper)
R3 | R | 100Ohm | Carbon comp or metal oxide 1 W 100 Ω (grid stopper)
C2 | C | 0.01001uF | Ceramic NP0 500 V, 10 nF (cathode bypass)
V1 | Vdc | 150 V | Screen supply rail (+150 V regulated)
L2 | L | 1 mH | Wind on toroid (core TBD) for 1 mH, or molded RFC
SUB2 | SpLib | C:/Users/AlAnd/Git Backed Projects/xmitter/xmitter_prj/12hg7_koren.lib | SPICE library device: C:/Users/AlAnd/Git Backed Projects/xmitter/xmitter_prj/12hg7_koren.lib
R6 | R | 1 kOhm | Metal film 1 W 1 % 1 kΩ (screen dropper)
R7 | R | 47 kOhm | Metal film 1/4 W 1 % 47 kΩ (grid leak)
R8 | R | 100Ohm | Carbon comp or metal oxide 1 W 100 Ω (grid stopper)
R9 | R | 100Ohm | Carbon comp or metal oxide 1 W 100 Ω (grid stopper)
C4 | C | 0.01001uF | Ceramic NP0 500 V, 10 nF (cathode bypass)
V5 | Vdc | 150 V | Screen supply rail (+150 V regulated)
L4 | L | 1 mH | Wind on toroid (core TBD) for 1 mH, or molded RFC
L3 | L | 1uH | 1 µH RF choke -- molded or 12 t T37-2 (red), #26 AWG
L1 | L | 1uH | 1 µH RF choke -- molded or 12 t T37-2 (red), #26 AWG
C5 | C | .01001uF | Ceramic NP0 500 V, 10 nF (screen bypass)
C6 | C | .01uF | Silver mica or C0G 500 V, 10 nF (grid coupling)
C7 | C | .01uF | Silver mica or C0G 500 V, 10 nF (grid coupling)
V2 | Vdc | 275V | Voltage source: 275V (rail or test source)
V6 | Vdc | 275V | Voltage source: 275V (rail or test source)
V11 | Vdc | 3V | Cathode bias rail (+3 V; ideally from independent ref)
V10 | Vac | {V_IN} | Voltage source: {V_IN} (rail or test source)
V8 | Vac | {V_IN} | Voltage source: {V_IN} (rail or test source)

Sheet: Driver_tank_subcircuit.sch
Driver_tank_subcircuit.sch
5 components
Reference | Type | Value | Type / Spec (core, voltage, wattage)
LQ1 | INDQ | {L} | Q-modelled inductor ({L}); construction in transformer notes
LQ2 | INDQ | {L} | Q-modelled inductor ({L}); construction in transformer notes
C1 | C | 25pF | Ceramic X7R or electrolytic, voltage TBD, 25pF
C3 | C | 1000pF | Ceramic X7R or electrolytic, voltage TBD, 1000pF
C4 | C | 1000pF | Ceramic X7R or electrolytic, voltage TBD, 1000pF

Sheet: Driver_output_transformer_subci
Driver_output_transformer_subcircuit.sch
14 components
Reference | Type | Value | Type / Spec (core, voltage, wattage)
LQ1 | INDQ | {INPUT_L} | Driver-side primary half-winding. Wind on a single common core (FT82-43 or T106-2).
LQ2 | INDQ | {INPUT_L} | Driver-side primary half-winding (same core as LQ1).
K1 | K_SPICE | LQ1 | Coupling coefficient k = LQ1 (transformer winding pair, not a physical part)
K2 | K_SPICE | LQ1 | Coupling coefficient k = LQ1 (transformer winding pair, not a physical part)
K3 | K_SPICE | LQ1 | Coupling coefficient k = LQ1 (transformer winding pair, not a physical part)
K4 | K_SPICE | LQ2 | Coupling coefficient k = LQ2 (transformer winding pair, not a physical part)
K5 | K_SPICE | LQ2 | Coupling coefficient k = LQ2 (transformer winding pair, not a physical part)
K6 | K_SPICE | LQ3 | Coupling coefficient k = LQ3 (transformer winding pair, not a physical part)
LQ3 | INDQ | {OUTPUT_L} | PA-grid secondary half-winding (same core).
LQ4 | INDQ | {OUTPUT_L} | PA-grid secondary half-winding (same core).
C1 | C | {C_IN} | Silver mica 1 kV, 6 pF (interwinding stray modelling)
C2 | C | {C_IN} | Silver mica 1 kV, 6 pF (interwinding stray modelling)
C3 | C | 1000pF | Silver mica 1 kV, 1 nF (grid coupling cap)
C4 | C | 1000pF | Silver mica 1 kV, 1 nF (grid coupling cap)

Sheet: PA_subcircuit.sch
PA_subcircuit.sch
38 components
Reference | Type | Value | Type / Spec (core, voltage, wattage)
SUB1 | SpLib | C:/Users/AlAnd/Git Backed Projects/xmitter/xmitter_prj/6146b_koren.lib | SPICE library device: C:/Users/AlAnd/Git Backed Projects/xmitter/xmitter_prj/6146b_koren.lib
R1 | R | 10Ohm | Carbon comp or metal-oxide 2 W 10 Ω (cathode resistor; sense across this)
R3 | R | 1 kOhm | Wirewound 5 W 1 kΩ (screen dropper)
R4 | R | 22 kOhm | Metal film or carbon comp 1/4 W 22 kΩ (grid leak; only ~µA flow)
R5 | R | 10Ohm | Carbon comp or metal-oxide 2 W 10 Ω (cathode resistor; sense across this)
R7 | R | 1 kOhm | Wirewound 5 W 1 kΩ (screen dropper)
R8 | R | 22 kOhm | Metal film or carbon comp 1/4 W 22 kΩ (grid leak)
R10 | R | 1 MOhm | Metal film 1/4 W 1 MΩ (sim load only -- do NOT populate in hardware)
R11 | R | 1 MOhm | Metal film 1/4 W 1 MΩ (sim load only -- do NOT populate in hardware)
K4 | K_SPICE | L4 | Coupling coefficient k = L4 (transformer winding pair, not a physical part)
K5 | K_SPICE | L4 | Coupling coefficient k = L4 (transformer winding pair, not a physical part)
L4 | L_SPICE | 1.71uH | Plate tank inductor half, 1.71 µH. Wind on T106-2 (red, 14 mm OD) or air-core ~20t #18 AWG enamelled, 20 mm diam.
L5 | L_SPICE | 1.71uH | Plate tank inductor half, 1.71 µH. Same core as L4 (push-pull center-tap).
K6 | K_SPICE | L5 | Coupling coefficient k = L5 (transformer winding pair, not a physical part)
C7 | C | 0.24pF | Silver mica 2 kV 1 % 0.24 pF -- VERY small; consider trimmer or stray-only
C6 | C | 0.24pF | Silver mica 2 kV 1 % 0.24 pF -- VERY small; consider trimmer or stray-only
R15 | R | 47Ohm | Carbon comp 5 W 47 Ω (plate stopper; nonmagnetic)
R14 | R | 47Ohm | Carbon comp 5 W 47 Ω (plate stopper; nonmagnetic)
C9 | C | 100pF | Silver mica 500 V, 100 pF (screen RF bypass)
C8 | C | 0.01uF | Ceramic NP0 500 V, 10 nF (screen bypass)
C11 | C | 100pF | Silver mica 500 V, 100 pF (screen RF bypass)
C10 | C | 0.01uF | Ceramic NP0 500 V, 10 nF (screen bypass)
L11 | L | 1 uH | 1 µH plate decouple RFC -- molded, 1 W or 12 t T50-2 (red)
L10 | L | 1 uH | 1 µH plate decouple RFC -- molded, 1 W or 12 t T50-2 (red)
C13 | C | {C_TANK} | Variable tuning cap, 2 kV, ~10-50 pF (plate tank, ±33 pF nominal)
C12 | C | {C_TANK} | Variable tuning cap, 2 kV, ~10-50 pF (plate tank, ±33 pF nominal)
R6 | R | 220Ohm | Carbon comp 2 W 220 Ω (grid stopper)
R2 | R | 220Ohm | Carbon comp 2 W 220 Ω (grid stopper)
V4 | Vdc | {SCREEN} | Screen supply rail (+200 V regulated; ~30 mA per tube)
V2 | Vdc | {SCREEN} | Screen supply rail (+200 V regulated; ~30 mA per tube)
L6 | L_SPICE | 0.27uH | Output link, 0.27 µH. ~4t #18 AWG, 20 mm diam. (or one turn on the L4/L5 chassis-mount tank).
X1 | SpLib | C:/Users/AlAnd/Git Backed Projects/xmitter/xmitter_prj/6146b_koren.lib | SPICE library device: C:/Users/AlAnd/Git Backed Projects/xmitter/xmitter_prj/6146b_koren.lib
R17 | R | 300Ohm | External load model (300 Ω target via balun reflection); not a physical part
V5 | Vdc | 600V | Plate supply rail (+600 V; ~150 mA per tube CW)
V6 | Vac | 160V | Voltage source: 160V (rail or test source)
SUB2 | Sub | grid_bias.sch | Sub-schematic instance: grid_bias.sch
SUB3 | Sub | grid_bias.sch | Sub-schematic instance: grid_bias.sch
V7 | Vdc | 1V | Voltage source: 1V (rail or test source)

Sheet: grid_bias.sch
grid_bias.sch
9 components
Reference | Type | Value | Type / Spec (core, voltage, wattage)
X1 | SpLib | C:/Users/AlAnd/Git Backed Projects/xmitter/xmitter_prj/opa454.lib | OPA454 (DIP-8 or SOIC-8). 100 V op-supply max. ~$5.
LM40405 | Vdc | 5 V | LM4040DIZ-5.0 (TO-92) + 1.5 kΩ 1/4 W bias resistor from +12 V
R_pad | R | 1 kOhm | Metal film 1/4 W 1 % 1 kΩ (DAC -> (+) input impedance)
V2 | Vdc | 85V | -85 V supply rail (small isolated DC-DC + TL431 shunt regulator)
V3 | Vdc | 12 V | +12 V system supply rail
R_GL | R | 22kOhm | Metal film 1/4 W 1 % 22 kΩ (grid leak / RFC to PA grid)
R_F | R | 170 kOhm | Metal film 1/4 W 1 % 170 kΩ (OPA454 feedback; sets gain 18)
R_G | R | 10 kOhm | Metal film 1/4 W 1 % 10 kΩ ((-) input return to +5 V LM4040)
R_GATE | R | 10 kOhm | Metal film 1/4 W 1 % 10 kΩ (Q_SLAM gate driver)

Sheet: grid_bias_check.sch
grid_bias_check.sch
4 components
Reference | Type | Value | Type / Spec (core, voltage, wattage)
RL | R | 1 MOhm | Metal film 1/4 W 1 % 1 MOhm (default; check operating power)
V2 | Vdc | 0V | Voltage source: 0V (rail or test source)
V1 | Vdc | 3.3V | Voltage source: 3.3V (rail or test source)
SUB1 | Sub | grid_bias.sch | Sub-schematic instance: grid_bias.sch

Sheet: Balun_6to1_subcircuit.sch
Balun_6to1_subcircuit.sch
4 components
Reference | Type | Value | Type / Spec (core, voltage, wattage)
LP | L_SPICE | 14uH | Balun primary 14 µH. ~17 turns on FT82-43 ferrite toroid bifilar with secondary.
LS | L_SPICE | 2.33uH | Balun secondary 2.33 µH. ~7 turns on the same FT82-43 core (6:1 impedance, ~2.45:1 turns).
K1 | K_SPICE | LP | Coupling coefficient k = LP (transformer winding pair, not a physical part)
R1 | R | 0.5Ohm | Carbon comp 5 W 0.5 Ω (sim convergence series R; 0 Ω in hardware)

Sheet: LPF_subcircuit.sch
LPF_subcircuit.sch
19 components
Reference | Type | Value | Type / Spec (core, voltage, wattage)
R3 | R | 1 MOhm | Metal film 1/4 W 1 % 1 MOhm (default; check operating power)
R7 | R | 1 MOhm | Metal film 1/4 W 1 % 1 MOhm (default; check operating power)
C3 | C | 52pF | Ceramic X7R or electrolytic, voltage TBD, 52pF
C4 | C | 52pF | Ceramic X7R or electrolytic, voltage TBD, 52pF
L1 | L | {L_OUTER} | Wind on toroid (core TBD) for {L_OUTER}, or molded RFC
L2 | L | {L_OUTER} | Wind on toroid (core TBD) for {L_OUTER}, or molded RFC
L5 | L | {L_OUTER} | Wind on toroid (core TBD) for {L_OUTER}, or molded RFC
L6 | L | {L_OUTER} | Wind on toroid (core TBD) for {L_OUTER}, or molded RFC
L3 | L | {L_MIDDLE} | Wind on toroid (core TBD) for {L_MIDDLE}, or molded RFC
L4 | L | {L_MIDDLE} | Wind on toroid (core TBD) for {L_MIDDLE}, or molded RFC
C5 | C | 37 pF | Ceramic X7R or electrolytic, voltage TBD, 37 pF
V1 | Vac | 1 V | Voltage source: 1 V (rail or test source)
V2 | Vac | 1 V | Voltage source: 1 V (rail or test source)
C6 | C | 4.7pF | Ceramic X7R or electrolytic, voltage TBD, 4.7pF
C7 | C | 4.7pF | Ceramic X7R or electrolytic, voltage TBD, 4.7pF
R11 | R | 225Ohn | Metal film 1/4 W 1 % 225Ohn (default; check operating power)
R8 | R | 225Ohn | Metal film 1/4 W 1 % 225Ohn (default; check operating power)
R10 | R | 450Ohm | Metal film 1/4 W 1 % 450Ohm (default; check operating power)
C8 | C | 37pF | Ceramic X7R or electrolytic, voltage TBD, 37pF

Sheet: LPF_50ohm_subcircuit.sch
LPF_50ohm_subcircuit.sch
5 components
Reference | Type | Value | Type / Spec (core, voltage, wattage)
C1 | C | 300pF | Silver mica 500 V, 300 pF (output LPF shunt)
L1 | L | 540nH | 540 nH series inductor. ~13 t on T50-2 (red, μ=10) #20 AWG. Alt: T50-6.
C2 | C | 450pF | Silver mica 500 V, 450 pF (output LPF shunt center; or 470 pF)
L2 | L | 540nH | 540 nH series inductor. Same as L1.
C3 | C | 300pF | Silver mica 500 V, 300 pF (output LPF shunt)

Sheet: ATU_subcircuit.sch
ATU_subcircuit.sch
12 components
Reference | Type | Value | Type / Spec (core, voltage, wattage)
C1 | C | {C_IN} | Ceramic NP0/X7R 50-100 V, {C_IN}
C2 | C | {C_IN} | Ceramic NP0/X7R 50-100 V, {C_IN}
C3 | C | {C_OUT} | Ceramic NP0 or silver mica 50-500 V, {C_OUT}
C4 | C | {C_OUT} | Ceramic NP0 or silver mica 50-500 V, {C_OUT}
L1 | L_SPICE | {L_LEG} | Wind on toroid (core TBD) for {L_LEG}; see notes for core / turns / wire
L2 | L_SPICE | {L_LEG} | Wind on toroid (core TBD) for {L_LEG}; see notes for core / turns / wire
K1 | K_SPICE | L1 | Coupling coefficient k = L1 (transformer winding pair, not a physical part)
R3 | R | 225Ohm | Metal film 1/4 W 1 % 225Ohm (default; check operating power)
R4 | R | 225Ohm | Metal film 1/4 W 1 % 225Ohm (default; check operating power)
R5 | R | 450Ohm | Metal film 1/4 W 1 % 450Ohm (default; check operating power)
V1 | Vac | 1 V | Voltage source: 1 V (rail or test source)
V2 | Vac | 1 V | Voltage source: 1 V (rail or test source)

Sheet: Digital_subcircuit.sch
Digital_subcircuit.sch
0 components
Reference | Type | Value | Type / Spec (core, voltage, wattage)
