agelders2021/xmitter/Documentation/parts_inventory.xlsx

Category | Part Number | Description | Package | Quantity | Location/Bin | Notes
IC - DDS Synthesizer | AD9852ASTZ | Analog Devices 300 MSPS complete DDS | LQFP-80 (SMD)
IC - Motor Driver | L293DN | Quadruple half-H driver, 600 mA | PDIP-16
IC - Comparator | LM2903N | Dual comparator (best guess) | PDIP-8 |  |  | Dictated 'SN92903'; best guess LM2903N dual comparator
Optocoupler | H11L1VM | Optocoupler with Schmitt trigger output | DIP-6 |  |  | Dictated as 'H11L1V dash M'
IC - Logic | SN74HC174N | Hex D-type flip-flop with clear, 74HC174 | PDIP-16
IC - Timer | NE556N | Dual 556 timer | PDIP-14
IC - Logic | CD4069UBE | Hex inverter (CMOS) | PDIP-14 | 10 |  | Qty dictated 5, corrected to 10
Inductor | 70F106AI | 1 uH RF choke coil | Axial | 6 |  | Qty corrections: 5 -> 1 -> 6 (final 6)
Transistor - JFET | LSK489 | Linear Systems dual low-noise JFET | TO-71 | 3
Transistor - NPN | 2N2222A | NPN general purpose transistor | TO-18 | 6
IC - Logic | 74F10PC | Triple 3-input NAND, FAST logic | PDIP-14 | 10
Resistor |  | 20 ohm 1% metal film resistor | Axial |  |  | No quantity given
Relay |  | SPST RF relay, 28 VDC coil |  | 20 |  | Two dictated entries merged: first (28V coil, no qty) + later 'RF relay SPST qty 20' - VERIFY same part
Unknown |  | Unknown digital display device |  |  |  | No part number or quantity
IC - Logic | CD4013BCN | Dual D flip-flop (CMOS) | PDIP-14 | 10
Socket |  | PLCC socket, 52-pin | PLCC-52 | 3
IC - Timer | TLC555 | TLC555 CMOS timer | PDIP-8 | 1
Oscillator |  | Crystal oscillator, 110.9 MHz |  | 1
IC - Logic | CD4027BCN | Dual JK flip-flop (CMOS) | PDIP-16 | 10 |  | Dictated 'CD40278CN'; best guess CD4027BCN dual JK flip-flop
IC - Memory | CY7C199 | Cypress 32K x 8 static RAM (best guess) | DIP-28 |  |  | Dictated 'Texas Instruments CY78199'; best guess CY7C199 SRAM ('7C199' misheard as '78199')
IC - Comparator | LM339N | Quad comparator | PDIP-14 |  |  | No quantity given
IC - Op Amp | LM324N | Quad op-amp | PDIP-14 |  |  | Dictated '324 in'; best guess LM324N quad op-amp
IC - Logic | SN74LS27N | Triple 3-input NOR | PDIP-14 | 10
IC - Microcontroller | MC68HC811E2 | Motorola 8-bit MCU, 68HC11 family, 2K EEPROM | PLCC-52 | 20 |  | Best guess full part MC68HC811E2FN (PLCC-52); likely pairs with the 52-pin PLCC sockets
Module |  | Digital keyboard/keypad interface module |  | 1
IC - Logic | 74HC04N | Hex inverter | PDIP-14 | 10 |  | Qty originally dictated 3; updated to 10 per later entry
Transistor - PNP | 2N6109G | PNP power transistor | TO-220 | 5
Transformer |  | Power transformer, 25.2 V, 2 A |  | 1
IC - DDS Synthesizer | AD9854ASTZ | Analog Devices 300 MSPS quadrature DDS | LQFP-80 (SMD) | 2 |  | Distinct from AD9852ASTZ in batch 1
Connector |  | Plugs with connectors, male and female |  | ~10 |  | Corrected entry: originally dictated as 'panel mount LEDs unknown, qty 6', then changed per dictation
Resistor |  | Half-watt carbon resistors, value(s) unspecified | Axial | 50+ |  | Dictation began with '20' (ambiguous); qty recorded as 50+
Connector |  | Multiple power connectors, appear to be high voltage |  |  |  | No description / quantity dictated
Resistor |  | 25 ohm 1 W silicon resistor | Axial | 3 |  | Dictated 'silicon' - possibly silicone-coated wirewound
Transistor - PNP | 2N3905 | PNP transistor | TO-92 | 3 |  | Dictated '2N3905 ND' - '-ND' is likely a Digi-Key suffix, dropped
Switch |  | Toggle switch, DPST, 15 A, screw terminals |  | 1 |  | Transcribed 'tub switch'; best guess toggle switch
Socket |  | Wire-wrap IC sockets, approx 16-20 pin | DIP | many |  | Quantity dictated as 'many'
IC - Logic | 74HC02N | Quad 2-input NOR | PDIP-14 | 10
IC - Logic | 74HC00N | Quad 2-input NAND | PDIP-14 | 10 |  | Entered as '73HC00N'; corrected to 74HC00N (no 73-series exists)
IC - Logic | 74HC357N | Quad 2-input multiplexer, 3-state (74x357 family) | PDIP-16 | 8
IC - Power Management | MAX713CPE | Maxim NiCd/NiMH fast-charge controller | PDIP-16 | 3
Diode - Rectifier | 1N5400G | Rectifier diode, 3 A, 50 V | DO-201AD (axial) | 1
Diode - Rectifier | 1N4001-T | Rectifier diode, 1 A, 50 V | Axial | 6
