agelders2021/xmitter/Documentation/Resistor_Sourcing.xlsx

Sheet: Strategy
Resistor Sourcing Strategy
Three-tier approach to covering all ~150 resistor positions:
Tier | Source | Approx Cost | Coverage
1 | 1280-pc 1 % metal-film kit from Amazon (Aniann / Bojack / MCIGICM / Bojack -- all same content) | $15-25 | ~75 % of build (E12-ish, 10R to 1M, 1/4 W, 1 %)
2 | Yageo MFR-25 metal-film 1 % singles from DigiKey | $3-5 | 5 specific values for impedance / gain setting that the kit misses
3 | Specialty parts from DigiKey or Mouser: Ohmite carbon comp + Ohmite Brown Devil wirewound + metal oxide | $25-35 | Plate stoppers, screen droppers, driver high-power positions
Order Checklist
[ ] Amazon: 1280-pc 1 % metal-film resistor kit ($15-25)
[ ] DigiKey: 5 specific metal-film values (see 'DigiKey Metal Film' sheet)
[ ] DigiKey: Ohmite OD series carbon comp 47 ohm 5 W (PA plate stoppers)
[ ] DigiKey: Ohmite Brown Devil 1 kohm 5 W wirewound (PA screen droppers)
[ ] DigiKey: Metal oxide 1 W (driver stage)
[ ] Optional but useful: 0.1 % precision pair for V_REF divider if you want exact 1.5 V threshold
Total estimated cost: $45-65 covering every resistor in the build with spares.

Sheet: Kit Coverage
1280-pc Amazon kit -- value-by-value coverage
Aniann / Bojack / MCIGICM / EEEEE: identical 63-value content.
Value | Status | Used for
1 ohm | skip | Not used in this build
2.2 ohm | skip | Not used in this build
4.7 ohm | skip | Not used in this build
5.6 ohm | skip | Not used in this build
7.5 ohm | skip | Not used in this build
8.2 ohm | skip | Not used in this build
10 ohm | OK | Cathode sense R_C (NB also need 1 W carbon comp version)
15 ohm | skip | Not used in this build
22 ohm | skip | Not used in this build
27 ohm | skip | Not used in this build
33 ohm | skip | Not used in this build
39 ohm | skip | Not used in this build
47 ohm | carbon | PA plate stoppers -- METAL FILM NOT SUITABLE here; use Ohmite OD carbon comp 5 W
56 ohm | skip | Not used in this build
68 ohm | skip | Not used in this build
75 ohm | skip | Not used in this build
82 ohm | skip | Not used in this build
100 ohm | OK | Driver grid stoppers (driver also needs 1 W version)
120 ohm | skip
150 ohm | OK | Possible alt R_F
180 ohm | skip | Not used in this build
220 ohm | OK | PA grid stoppers (R_2, R_6); also 22k positions
270 ohm | OK | J310 source bias RS1
330 ohm | skip | Not used in this build
390 ohm | skip | Not used in this build
470 ohm | OK | Misc
510 ohm | skip | Not used in this build
680 ohm | skip | Not used in this build
820 ohm | skip | Not used in this build
1 kohm | OK | R_pad in keyer + grid_bias, driver screen dropper (also need 1 W wirewound version)
1.5 kohm | OK | LM4040 bias resistor; envelope LPF R13
2.2 kohm | OK | Close-enough alt for 2.32k V_REF divider
3 kohm | OK | V_REF divider top leg
3.9 kohm | OK | MC1496 load RLa, RLb
4.7 kohm | OK | LM393 R_PULL
5.6 kohm | skip | Not used in this build
6.8 kohm | OK | MC1496 R_BIAS
7.5 kohm | skip | Not used in this build
8.2 kohm | OK | Null PNP collector load (R5, R7, R9, R10)
10 kohm | OK | R_G, R_GATE, R_S (in cathode monitor), many places
15 kohm | skip | Not used in this build
22 kohm | OK | PA grid leak, R_GL, MC1496 pin 8 divider
33 kohm | skip | Not used in this build
39 kohm | skip | Not used in this build
47 kohm | OK | LM7171 R_F (= 47k for gain 5.8), driver grid leak
56 kohm | skip | Not used in this build
68 kohm | skip | Not used in this build
75 kohm | skip | Not used in this build
82 kohm | skip | Not used in this build
100 kohm | OK | Op-amp + input bias
150 kohm | OK | Possible alt
180 kohm | skip | Not used in this build
220 kohm | OK | Misc
330 kohm | skip | Not used in this build
470 kohm | OK | LM393 R_HYST hysteresis
560 kohm | skip | Not used in this build
680 kohm | skip | Not used in this build
1 Mohm | OK | Gate leak (J310), sim test loads
1.5 Mohm | skip | Not used in this build
2 Mohm | skip | Not used in this build
3.3 Mohm | skip | Not used in this build
4.7 Mohm | skip | Not used in this build
5.6 Mohm | skip | Not used in this build
10 Mohm | skip | Not used in this build

Sheet: DigiKey Metal Film
DigiKey order -- metal-film 1 % singles the kit doesn't have
These 5 values are impedance- or gain-critical; must be exact. About $2.50-4.00 total for 10 each.
Value | DigiKey search term | Qty | Used for | Why exact value matters
51 ohm | Yageo MFR-25FBF52-51R | 10 | MC1496 R1 R3 R4 -- signal port + carrier port impedance terminations | Substituting 47 R or 56 R shifts MC1496 port impedance; 51 R is the design value
62 ohm | Yageo MFR-25FBF52-62R | 10 | VFO 20 dB Pi pad shunt resistors RP1 RP3 | Pad attenuation depends on exact value; 56 R or 68 R drifts pad ~1.5 dB
200 ohm | Yageo MFR-25FBF52-200R | 10 | MC1496 Re (between pins 2-3) -- sets modulator gain | Modulator gain = R_L / Re. 180 R or 220 R from kit shifts gain ~10 %
240 ohm | Yageo MFR-25FBF52-240R | 10 | VFO 20 dB Pi pad series resistor RP2 | Pad attenuation depends on exact value
170 kohm | Yageo MFR-25FBF52-170K | 10 | OPA454 R_F in grid_bias -- sets bias transfer function gain | V_out = V_DAC * 18 - 85 requires R_F / R_G = 17. Kit's 150 k or 220 k shifts gain too far

Sheet: DigiKey Specialty
DigiKey / Mouser -- specialty parts no general assortment covers
Carbon composition, wirewound, metal oxide. Tube-specific positions where metal film isn't right.
Type | Value | Part / DigiKey search | Qty | Used for | Notes
Carbon comp 5 W | 47 ohm | Ohmite OD470JE or OD470KE | 4 | PA plate stoppers R14 R15 -- one per tube + spares | Non-magnetic / non-inductive structure beats metal film at 14 MHz. Also handles pulse loads.
Carbon comp 2 W | 220 ohm | Ohmite OF221JE | 4 | PA grid stoppers R2 R6 (optional upgrade from metal film) | Metal film works here but carbon comp is the conservative choice for tube grid stoppers.
Wirewound 5 W | 1 kohm | Ohmite Brown Devil B5J1K0E | 4 | PA screen droppers R3 R7 -- one per tube + spares | Non-inductive style (Ohmite Series E). 5 W handles screen current droop.
Metal oxide 1 W | 100 ohm | Yageo FMP100JR-52-100R | 8 | Driver grid stoppers (driver subcircuit) | Non-inductive metal oxide. Carbon comp would also be fine here.
Metal oxide 1 W | 1 kohm | Yageo FMP100JR-52-1K | 4 | Driver screen droppers R2 R6 in driver subcircuit | Drives ~25 mA at 150 V; 1 W gives margin.
Metal film 1 W | 10 ohm | Yageo PR01000101000JR500 | 4 | Cathode sense resistor R_C in PA cathode monitor | 1 W gives 4x margin at 150 mA cathode current (0.225 W dissipation).
Carbon comp 5 W | 0.5 ohm | (any 5 W resistor, sim convergence only) | 1 | Balun primary Rser -- sim convergence ONLY; do NOT install in hardware | 0.5 ohm in series with the balun primary stops a singular matrix in ngspice. The real hardware has no series R.

Sheet: Resistor Inventory
Resistor inventory by value, with source
Cross-reference of every distinct value, where used, what type, and where to buy.
Value | Schematic | Ref desigs | Type required | Source / part
10 ohm | PA_subcircuit | R1, R5 | 1 W metal film | DigiKey: Yageo PR01000101000JR500 (×4)
47 ohm | PA_subcircuit | R14, R15 | 5 W carbon comp | DigiKey: Ohmite OD470 (×4)
51 ohm | keyer | R1, R3, R4 | 1/4 W metal film 1 % | DigiKey: Yageo MFR-25FBF52-51R (×10)
62 ohm | vfo_subcircuit | RP1, RP3 | 1/4 W metal film 1 % | DigiKey: Yageo MFR-25FBF52-62R (×10)
100 ohm | Driver_subcircuit | R1, R3, R8, R9 | 1 W metal oxide | DigiKey: Yageo FMP100JR-52-100R (×8)
200 ohm | keyer | Re | 1/4 W metal film 1 % | DigiKey: Yageo MFR-25FBF52-200R (×10)
220 ohm | PA_subcircuit | R2, R6 | 2 W carbon comp (or metal film) | Kit covers; DigiKey OF221JE if going carbon comp
240 ohm | vfo_subcircuit | RP2 | 1/4 W metal film 1 % | DigiKey: Yageo MFR-25FBF52-240R (×10)
270 ohm | vfo_subcircuit | RS1 | 1/4 W metal film 1 % | Kit covers
470 ohm | various | misc | 1/4 W metal film 1 % | Kit covers
1 kohm | Driver_subcircuit | R2, R6 | 1 W metal oxide | DigiKey: Yageo FMP100JR-52-1K (×4)
1 kohm | PA_subcircuit | R3, R7 | 5 W wirewound non-inductive | DigiKey: Ohmite Brown Devil B5J1K0E (×4)
1 kohm | grid_bias, others | R_pad, misc | 1/4 W metal film 1 % | Kit covers
1.5 kohm | grid_bias | LM4040 bias | 1/4 W metal film 1 % | Kit covers
1.5 kohm | keyer | R13 | 1/4 W metal film 1 % | Kit covers
2.2 kohm | -- alt for 2.32 k | V_REF divider | 1/4 W metal film 1 % | Kit covers; gives ~1.47 V instead of 1.5 V (trim pot covers)
3 kohm | (V_REF top leg) |  | 1/4 W metal film 1 % | Kit covers
3.9 kohm | keyer | RLa, RLb | 1/4 W metal film 1 % | Kit covers
4.7 kohm | cathode_monitor | R_PULL | 1/4 W metal film 1 % | Kit covers
6.8 kohm | keyer | R2 (R_BIAS) | 1/4 W metal film 1 % | Kit covers
8.2 kohm | keyer | R5, R7, R9, R10 | 1/4 W metal film 1 % | Kit covers
10 kohm | many | R_G, R_GATE, R_S | 1/4 W metal film 1 % | Kit covers
22 kohm | PA, grid_bias | R4, R8, R_GL | 1/4 W metal film 1 % | Kit covers
47 kohm | Op_Amp_Out | RF (LM7171) | 1/4 W metal film 1 % | Kit covers
47 kohm | Driver | R4, R7 | 1/4 W metal film 1 % | Kit covers
100 kohm | Op_Amp_Out | R1 (op-amp + bias) | 1/4 W metal film 1 % | Kit covers
170 kohm | grid_bias | R_F (OPA454) | 1/4 W metal film 1 % | DigiKey: Yageo MFR-25FBF52-170K (×10)
470 kohm | cathode_monitor | R_HYST | 1/4 W metal film 1 % | Kit covers
1 Mohm | vfo, grid_bias | RGL, R_LOAD test | 1/4 W metal film 1 % | Kit covers
