agelders2021/xmitter/Documentation/Components/40673.pdf

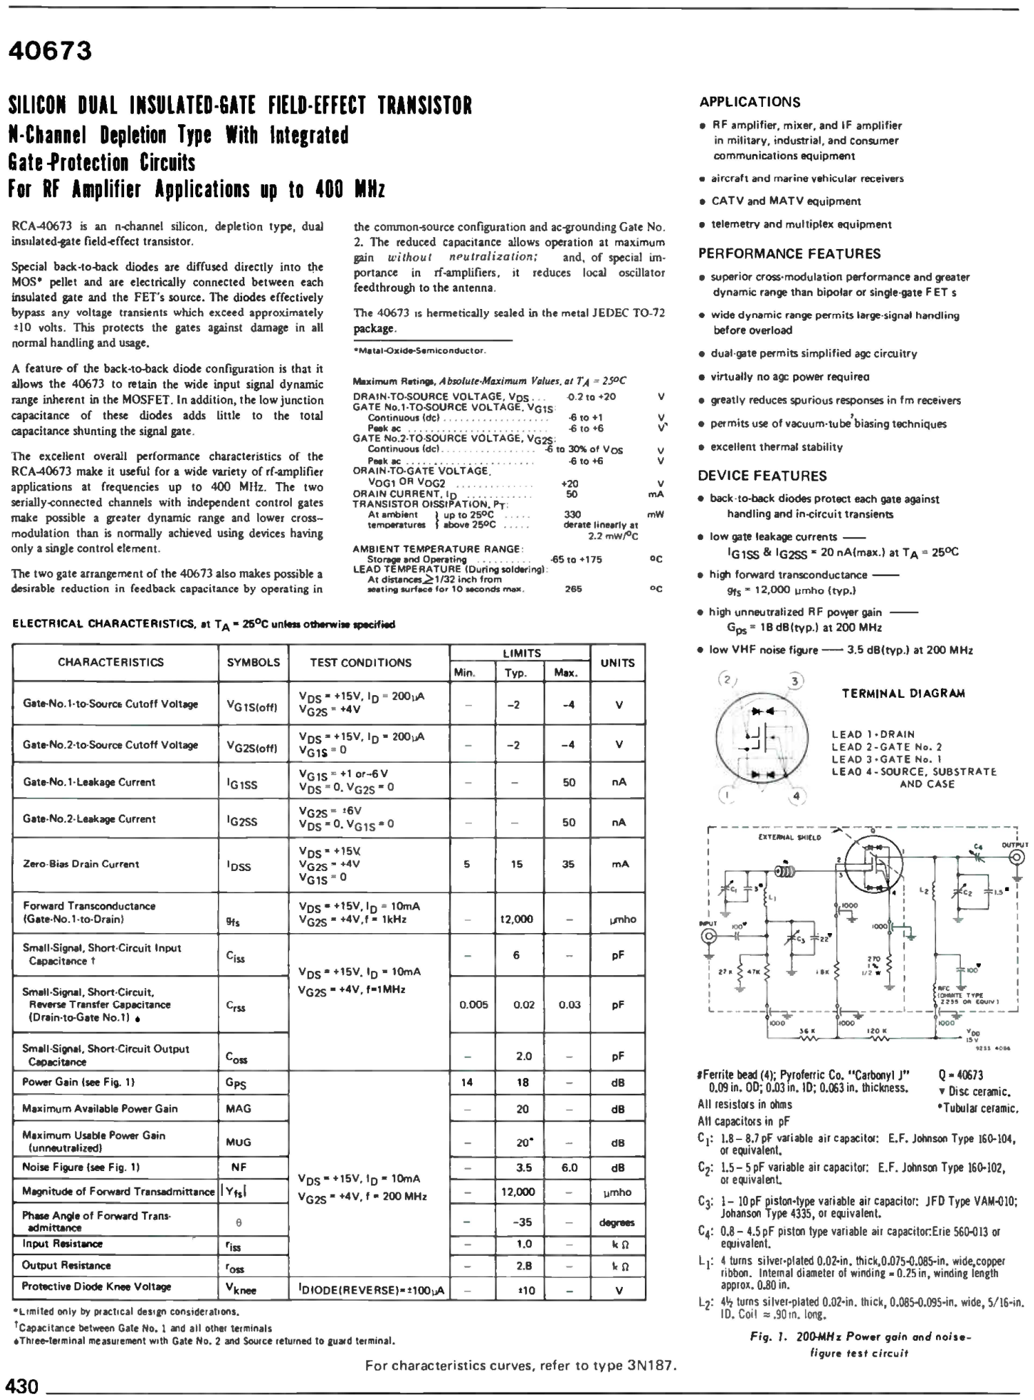
[picture p21: page 1]
