agelders2021/xmitter/Documentation/Components/12HG7.pdf

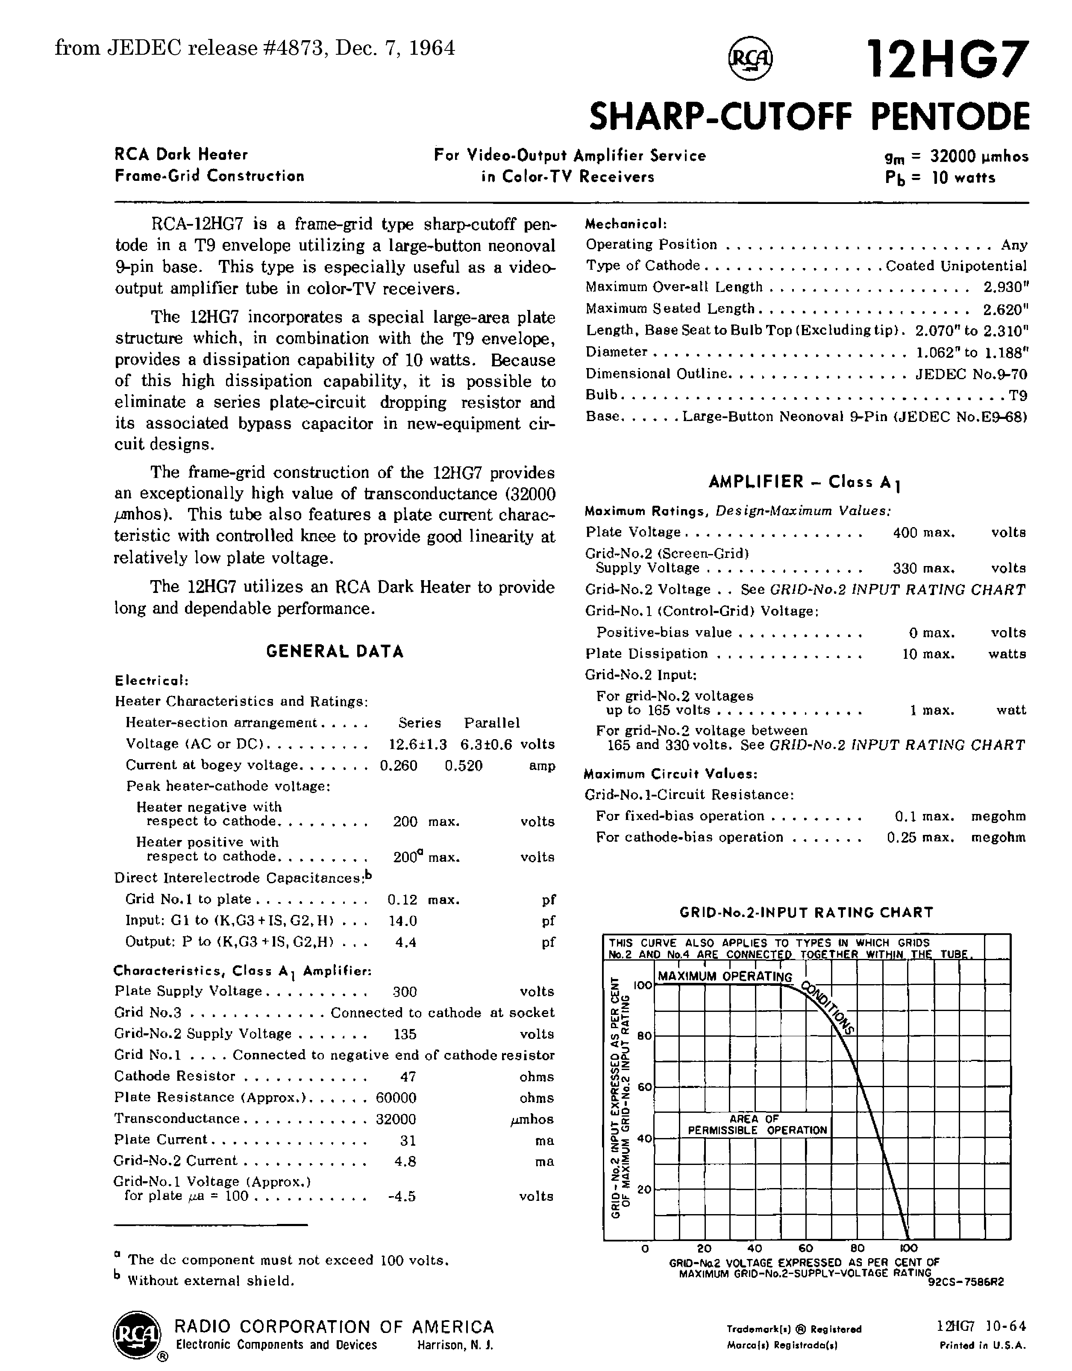
[picture p22: page 1]
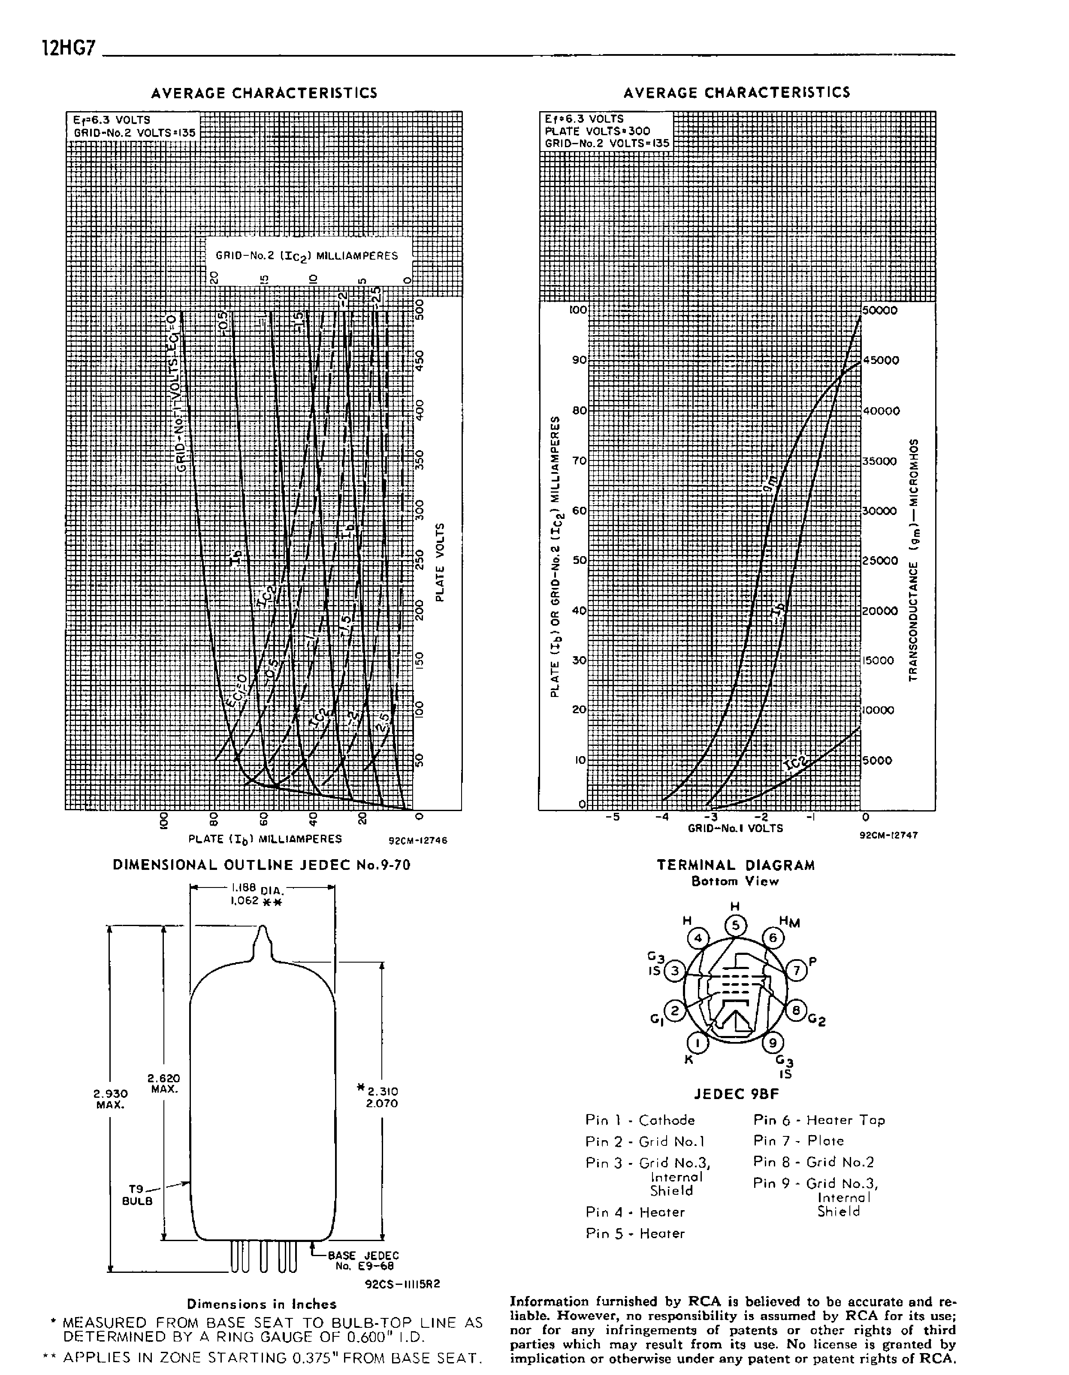
[picture p23: page 2]
