agelders2021/xmitter/Documentation/Components/rotary_encoder_datasheet.jpg

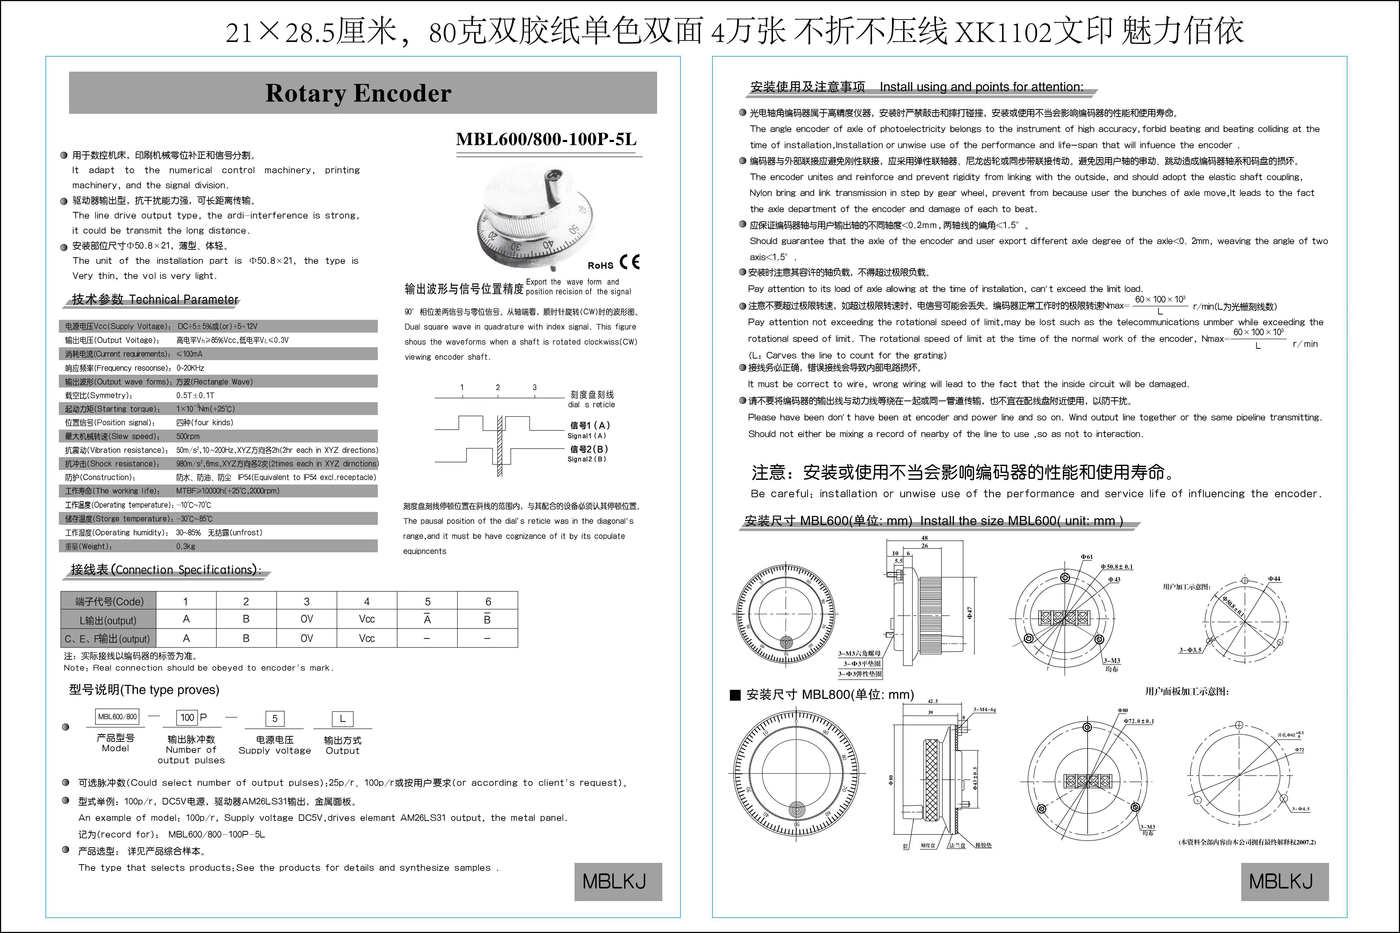
Documentation/Components/rotary_encoder_datasheet.jpg
