agelders2021/xmitter/Documentation/mc1496_buffer_signal_flow.pdf

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

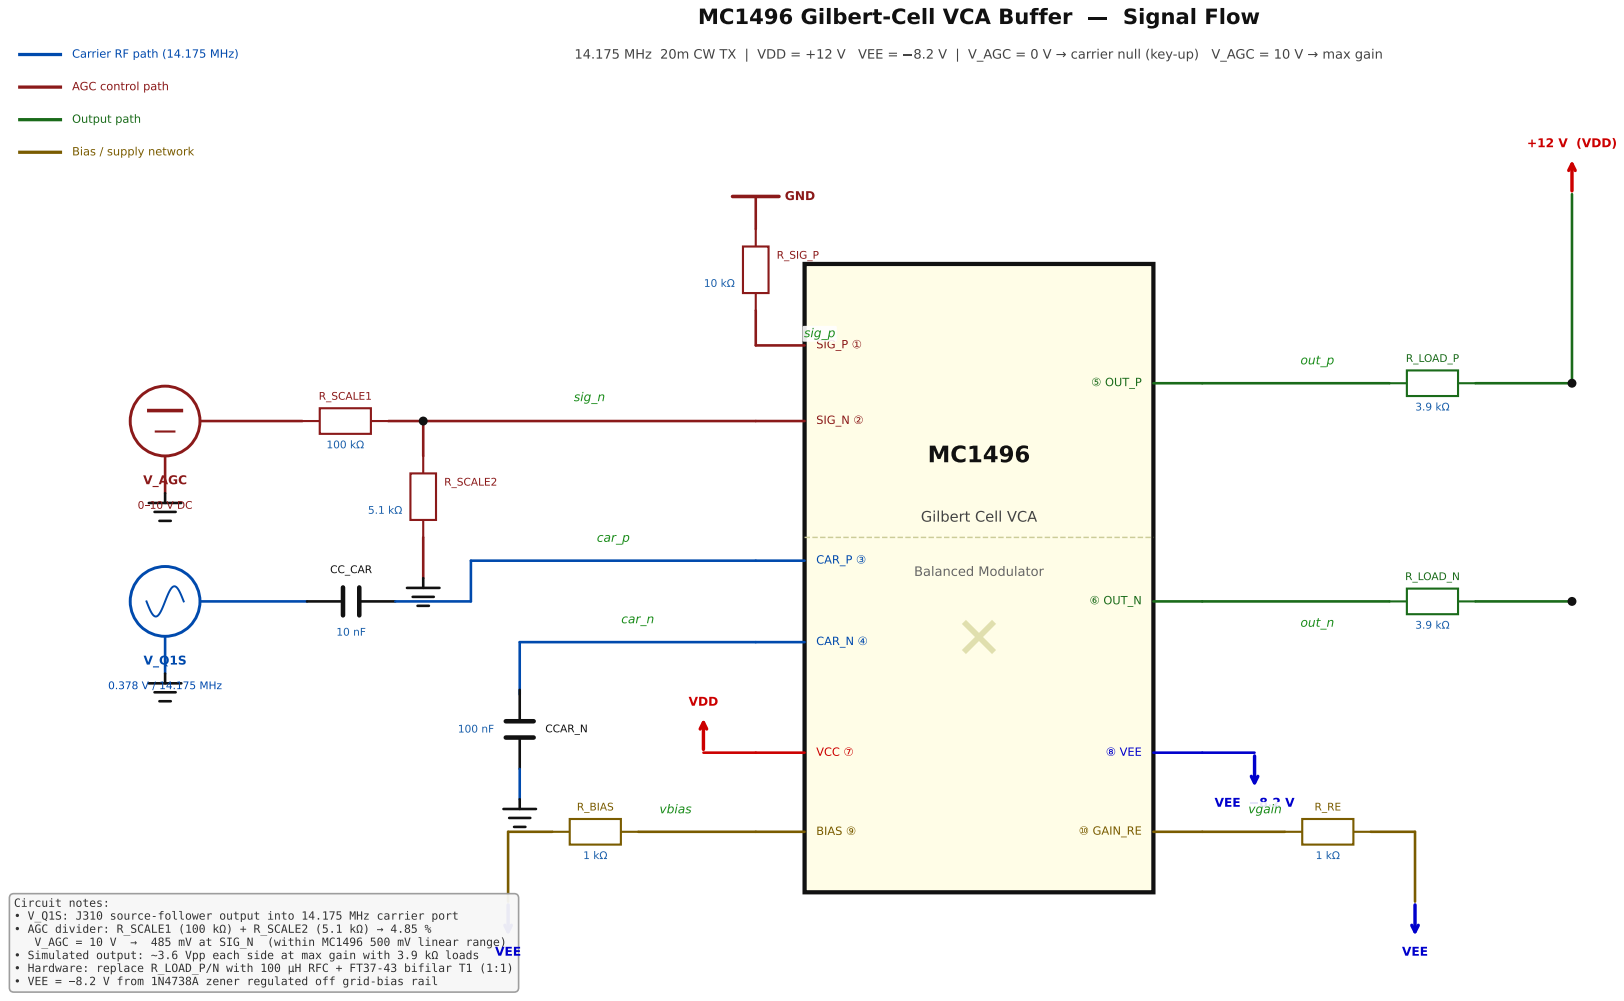
[picture p27: page 1]
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
