agelders2021/xmitter/KiCAD/frontpanel/frontpanel.kicad_pcb

## KiCad design KiCAD/frontpanel/frontpanel.kicad_pcb (2026-07-22)

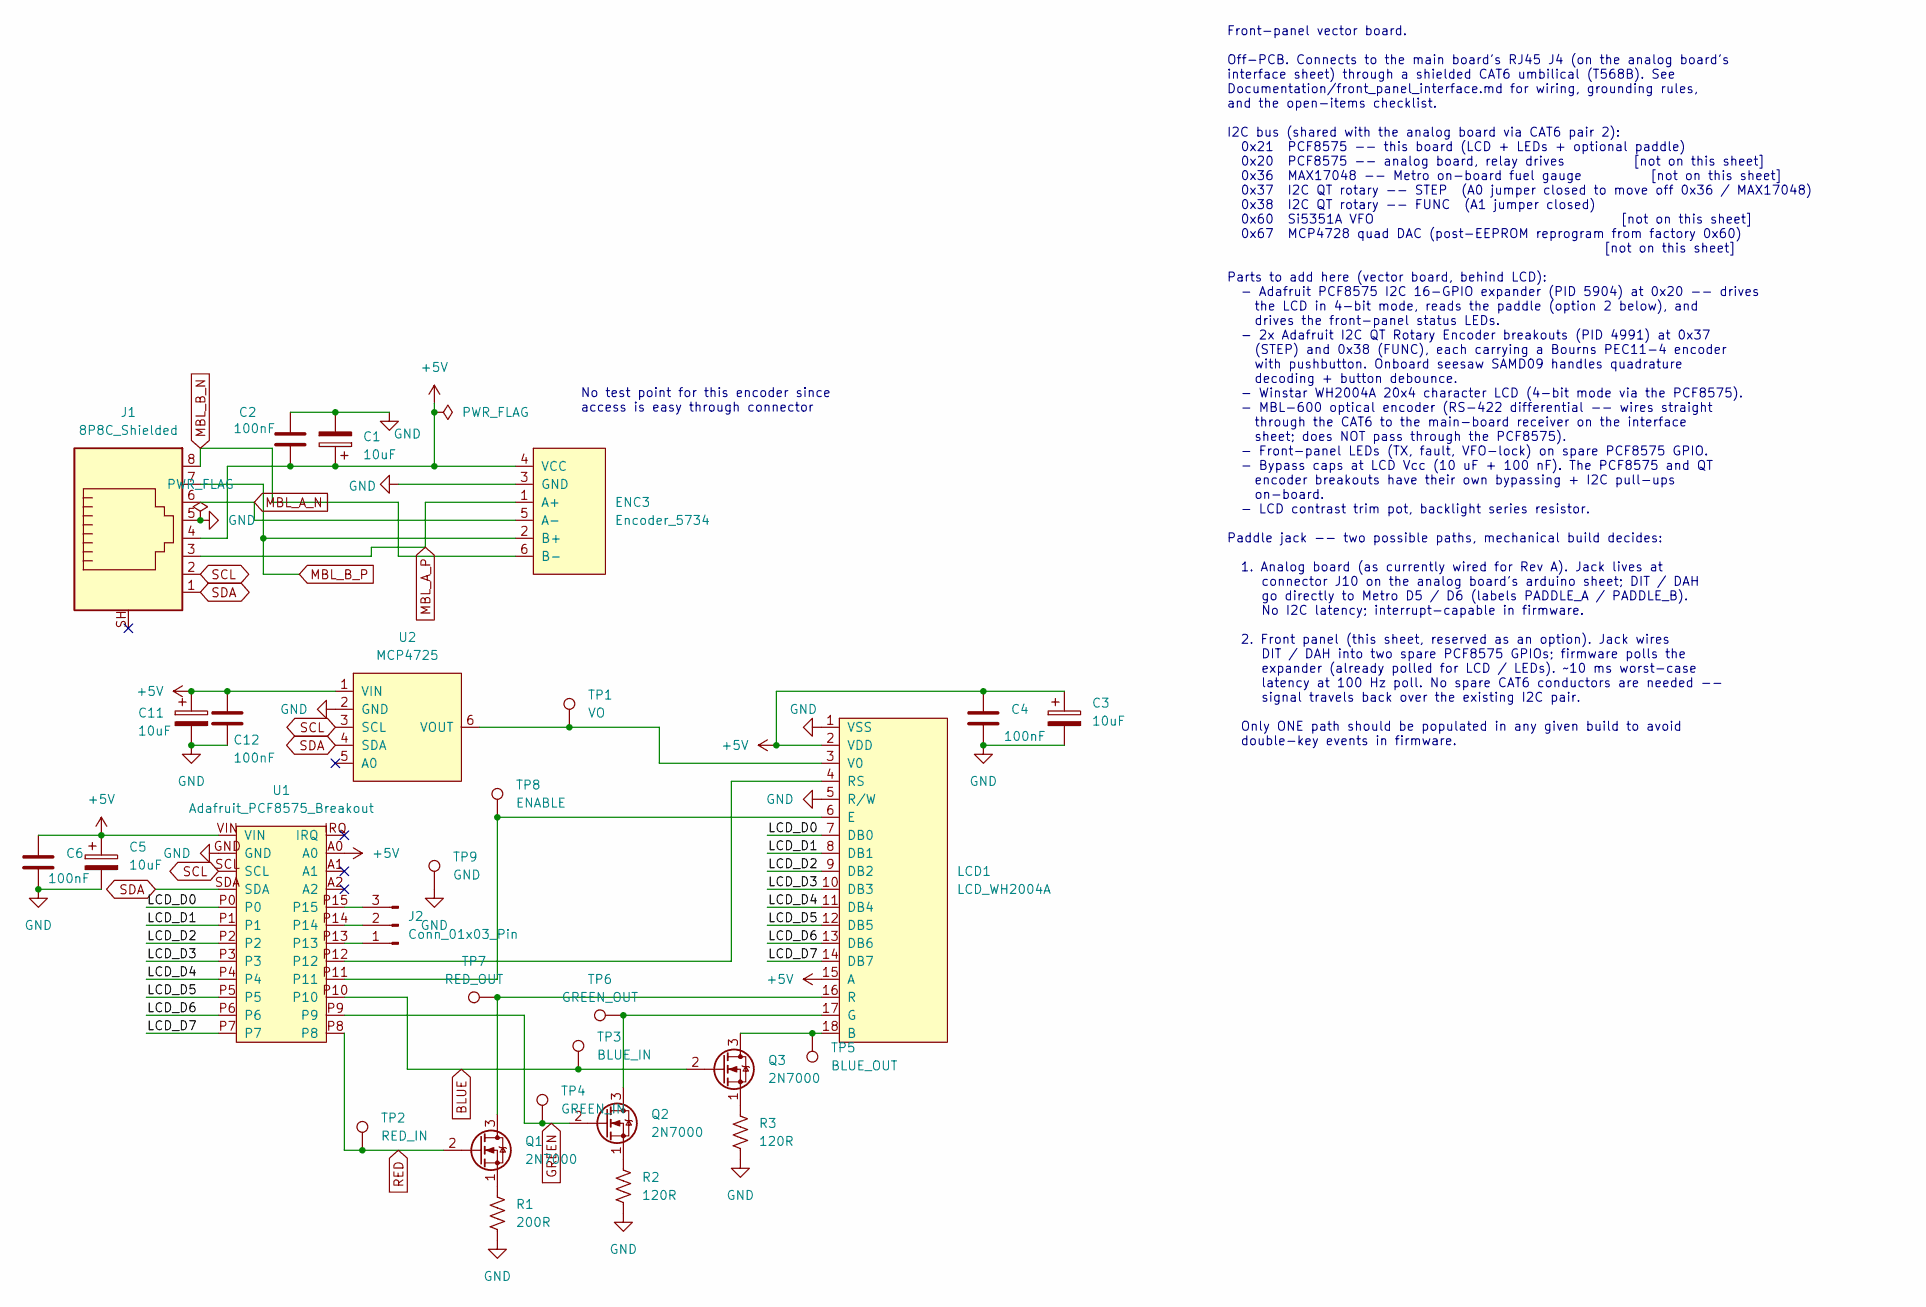
[picture p28: schematic frontpanel.kicad_sch]

Parts:
C1, C3, C5, C11: 10uF; CP_Radial_D5.0mm_P2.00mm
C2, C4, C6, C12: 100nF; C_Disc_D5.0mm_W2.5mm_P5.00mm
ENC3: Encoder_5734; PinHeader_1x06_P2.54mm_Vertical; MPN Adafruit #5734
J1: 8P8C_Shielded; Amphenol_RJE1D-188_Horizontal_Shielded
J2: Conn_01x03_Pin; PinHeader_1x03_P2.54mm_Vertical
LCD1: LCD_WH2004A; PinHeader_1x18_P2.54mm_Vertical; MPN WH2004A-CFH-JT# / Adafruit #498
Q1, Q2, Q3: 2N7000; TO-92_Inline
R1: 200R; R_Axial_DIN0207_L6.3mm_D2.5mm_P10.16mm_Horizontal
R2, R3: 120R; R_Axial_DIN0207_L6.3mm_D2.5mm_P10.16mm_Horizontal
TP1: VO; PinHeader_1x01_P2.54mm_Vertical
TP2: RED_IN; PinHeader_1x01_P2.54mm_Vertical
TP3: BLUE_IN; PinHeader_1x01_P2.54mm_Vertical
TP4: GREEN_IN; PinHeader_1x01_P2.54mm_Vertical
TP5: BLUE_OUT; PinHeader_1x01_P2.54mm_Vertical
TP6: GREEN_OUT; PinHeader_1x01_P2.54mm_Vertical
TP7: RED_OUT; PinHeader_1x01_P2.54mm_Vertical
TP8: ENABLE; PinHeader_1x01_P2.54mm_Vertical
TP9: GND; PinHeader_1x01_P2.54mm_Vertical
U1: Adafruit_PCF8575_Breakout; MPN Adafruit #5904
U2: MCP4725; Adafruit_MCP4725_Breakout; MPN Adafruit #935

Connections:
+5V: C1.1, C2.2, C3.1, C4.1, C5.1, C6.1, C11.1, C12.1, ENC3.4 (VCC), J1.4, LCD1.2 (VDD), LCD1.15 (A), U1.A0, U1.VIN, U2.1 (VIN)
/LCD_D0: LCD1.7 (DB0), U1.P0
/LCD_D1: LCD1.8 (DB1), U1.P1
/LCD_D2: LCD1.9 (DB2), U1.P2
/LCD_D3: LCD1.10 (DB3), U1.P3
/LCD_D4: LCD1.11 (DB4), U1.P4
/LCD_D5: LCD1.12 (DB5), U1.P5
/LCD_D6: LCD1.13 (DB6), U1.P6
/LCD_D7: LCD1.14 (DB7), U1.P7
BLUE: Q3.2 (G), TP3.1 (1_1), U1.P10
GND: C1.2, C2.1, C3.2, C4.2, C5.2, C6.2, C11.2, C12.2, ENC3.3 (GND), J1.5, LCD1.1 (VSS), LCD1.5 (R/W), R1.2, R2.2, R3.2, TP9.1 (1_1), U1.GND, U2.2 (GND)
GREEN: Q2.2 (G), TP4.1 (1_1), U1.P9
MBL_A_N: ENC3.5 (A-), J1.6
MBL_A_P: ENC3.1 (A+), J1.3
MBL_B_N: ENC3.6 (B-), J1.8
MBL_B_P: ENC3.2 (B+), J1.7
unnamed: J2.1, U1.P13
unnamed: J2.2, U1.P14
unnamed: J2.3, U1.P15
unnamed: LCD1.18 (B), Q3.3 (D), TP5.1 (1_1)
unnamed: LCD1.6 (E), TP8.1 (1_1), U1.P11
unnamed: LCD1.17 (G), Q2.3 (D), TP6.1 (1_1)
unnamed: LCD1.16 (R), Q1.3 (D), TP7.1 (1_1)
unnamed: LCD1.4 (RS), U1.P12
unnamed: LCD1.3 (V0), TP1.1 (1_1), U2.6 (VOUT)
unnamed: Q1.1 (S), R1.1
unnamed: Q2.1 (S), R2.1
unnamed: Q3.1 (S), R3.1
RED: Q1.2 (G), TP2.1 (1_1), U1.P8
SCL: J1.2, U1.SCL, U2.3 (SCL)
SDA: J1.1, U1.SDA, U2.4 (SDA)

Notes on the sheet:
Front-panel vector board. Off-PCB. Connects to the main board's RJ45 J4 (on the analog board's interface sheet) through a shielded CAT6 umbilical (T568B). See Documentation/front_panel_interface.md for wiring, grounding rules, and the open-items checklist. I2C bus (shared with the analog board via 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
No test point for this encoder since access is easy through connector

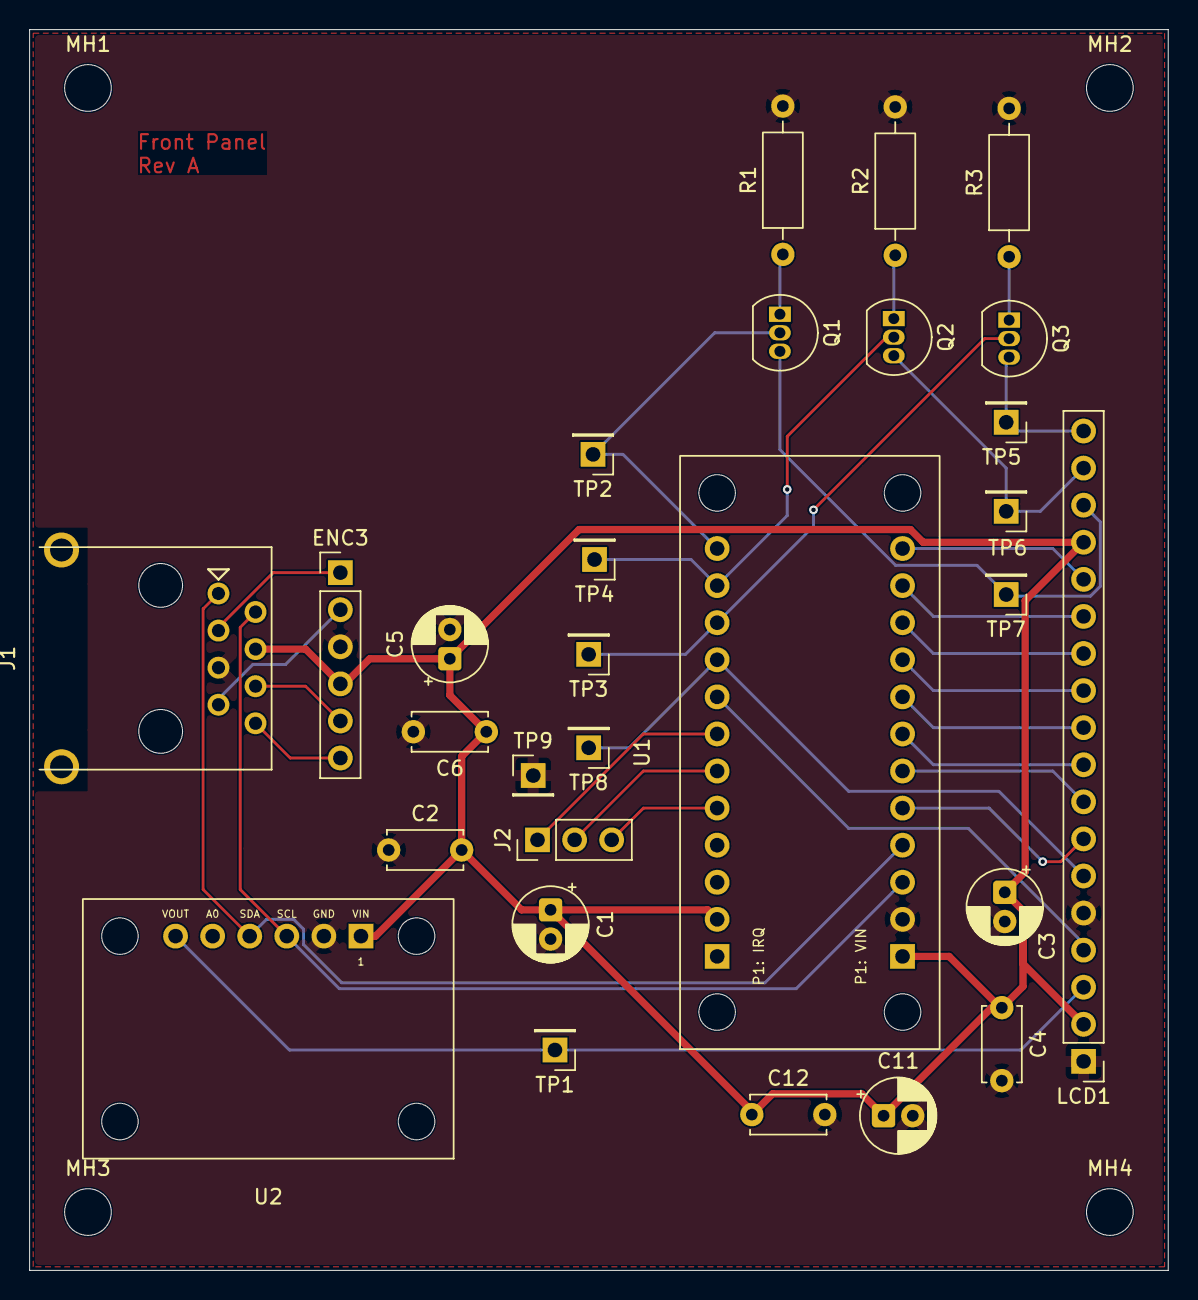
[picture p29: board frontpanel.kicad_pcb from above]

Board: 2 copper layers, 78.0 x 85.0 mm, 33 parts (0 on the bottom side), 31 nets.

Other parts of the board:
MH1, MH2, MH3, MH4: MountingHole_3.2mm_M3
