agelders2021/xmitter/KiCAD/analog/analog.kicad_pcb

## KiCad design KiCAD/analog/analog.kicad_pcb (2026-07-14)

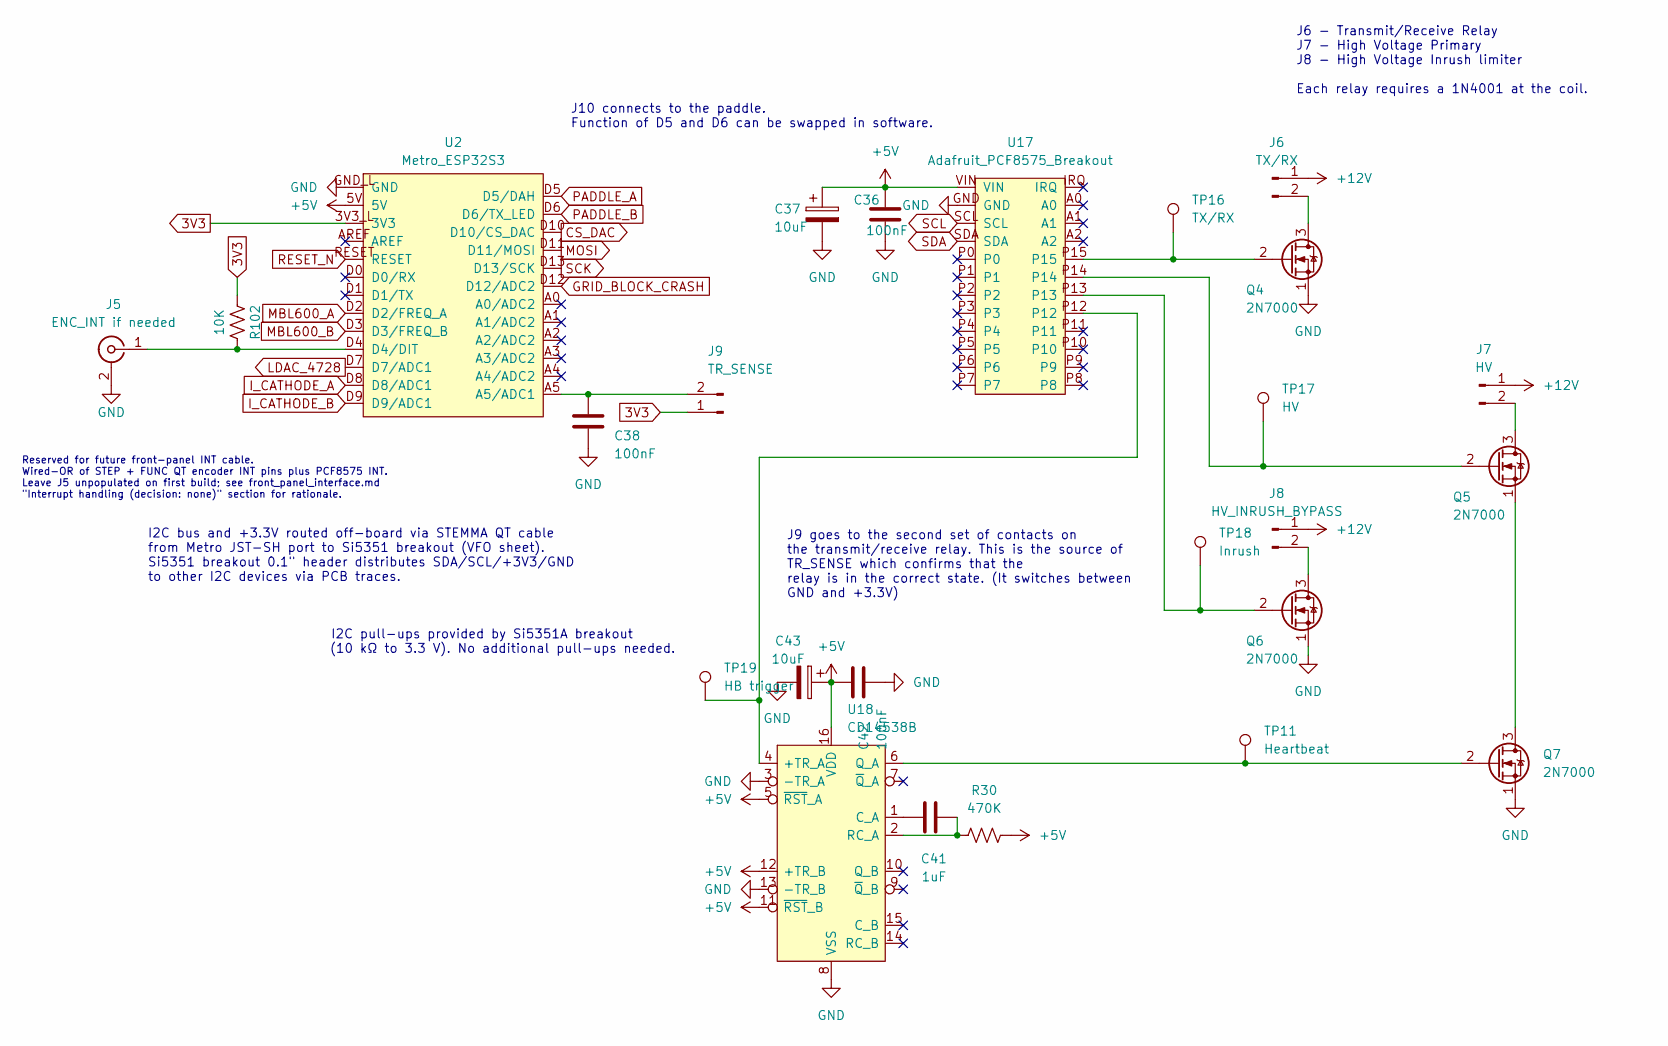
[picture p30: schematic arduino.kicad_sch]

Parts:
C36, C38, C42: 100nF; C_Disc_D5.0mm_W2.5mm_P5.00mm
C37, C43: 10uF; CP_Radial_D5.0mm_P2.00mm
C41: 1uF; C_Rect_L7.2mm_W4.5mm_P5.00mm
J5: ENC_INT if needed; SameSky_RCJ-02_RCA_Jack
J6: TX/RX; PinHeader_1x02_P2.54mm_Vertical
J7: HV; PinHeader_1x02_P2.54mm_Vertical
J8: HV_INRUSH_BYPASS; PinHeader_1x02_P2.54mm_Vertical
J9: TR_SENSE; PinHeader_1x02_P2.54mm_Vertical
Q4, Q5, Q6, Q7: 2N7000; TO-92_Inline
R30: 470K; R_Axial_DIN0207_L6.3mm_D2.5mm_P10.16mm_Horizontal
R102: 10K; R_Axial_DIN0207_L6.3mm_D2.5mm_P10.16mm_Horizontal
TP11: Heartbeat; PinHeader_1x01_P2.54mm_Vertical
TP16: TX/RX; PinHeader_1x01_P2.54mm_Vertical
TP17: HV; PinHeader_1x01_P2.54mm_Vertical
TP18: Inrush; PinHeader_1x01_P2.54mm_Vertical
TP19: HB trigger; PinHeader_1x01_P2.54mm_Vertical
U2: Metro_ESP32S3; MPN Adafruit #5500
U17: Adafruit_PCF8575_Breakout; MPN Adafruit #5904
U18: CD14538B; DIP-16_W7.62mm; MPN CD14538BE

Connections:
3V3: J9.1, R102.1, U2.3V3_L (3V3); also elsewhere on the board
+5V: C36.1, C37.1, C42.1, C43.1, R30.2, U2.5V, U17.VIN, U18.5 (~RST_A), U18.11 (~RST_B), U18.12 (+TR_B), U18.16 (VDD); also elsewhere on the board
+12V: J6.1, J7.1, J8.1; also elsewhere on the board
GND: C36.2, C37.2, C38.2, C42.2, C43.2, J5.2 (Ext), Q4.1 (S), Q6.1 (S), Q7.1 (S), U2.GND_L (GND), U17.GND, U18.3 (-TR_A), U18.8 (VSS), U18.13 (-TR_B); also elsewhere on the board
unnamed: J5.1 (In), R102.2, U2.D4 (D4/DIT)
unnamed: J6.2, Q4.3 (D)
unnamed: J7.2, Q5.3 (D)
unnamed: J8.2, Q6.3 (D)
unnamed: C38.1, J9.2, U2.A5 (A5/ADC1)
unnamed: Q4.2 (G), TP16.1 (1_1), U17.P15
unnamed: Q5.2 (G), TP17.1 (1_1), U17.P14
unnamed: Q5.1 (S), Q7.3 (D)
unnamed: Q6.2 (G), TP18.1 (1_1), U17.P13
unnamed: Q7.2 (G), TP11.1 (1_1), U18.6 (Q_A)
unnamed: TP19.1 (1_1), U17.P12, U18.4 (+TR_A)
unnamed: C41.1, U18.1 (C_A)
unnamed: C41.2, R30.1, U18.2 (RC_A)
SCL: U17.SCL; also elsewhere on the board
SDA: U17.SDA; also elsewhere on the board

Notes on the sheet:
I2C bus and +3.3V routed off-board via STEMMA QT cable from Metro JST-SH port to Si5351 breakout (VFO sheet). Si5351 breakout 0.1" header distributes SDA/SCL/+3V3/GND to other I2C devices via PCB traces.
J6 - Transmit/Receive Relay J7 - High Voltage Primary J8 - High Voltage Inrush limiter Each relay requires a 1N4001 at the coil.
J10 connects to the paddle. Function of D5 and D6 can be swapped in software.
J9 goes to the second set of contacts on the transmit/receive relay. This is the source of TR_SENSE which confirms that the relay is in the correct state. (It switches between GND and +3.3V)
Reserved for future front-panel INT cable. Wired-OR of STEP + FUNC QT encoder INT pins plus PCF8575 INT. Leave J5 unpopulated on first build; see front_panel_interface.md "Interrupt handling (decision: none)" section for rationale.
I2C pull-ups provided by Si5351A breakout (10 kΩ to 3.3 V). No additional pull-ups needed.

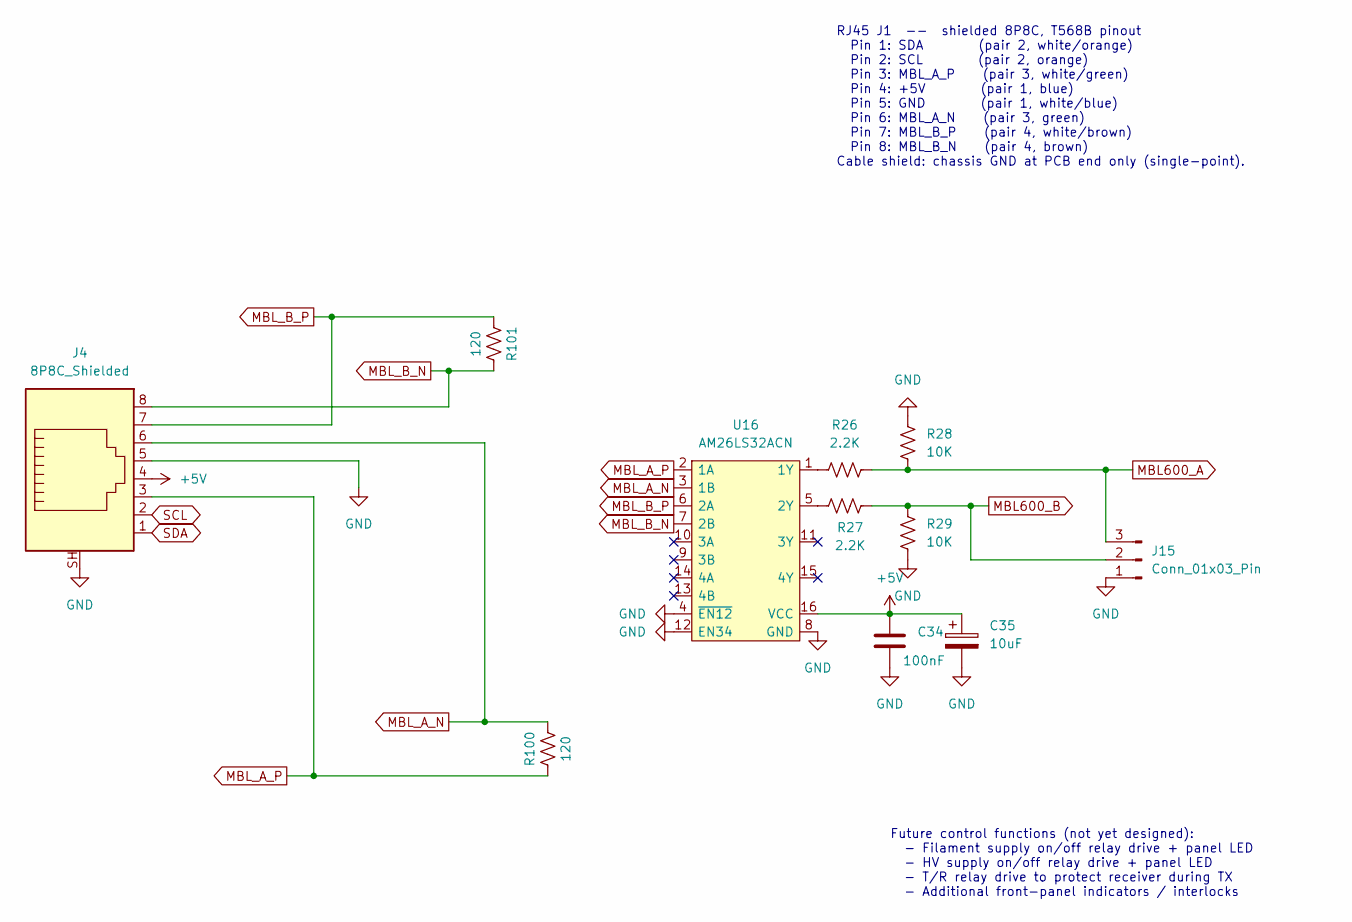
[picture p31: schematic interface.kicad_sch]

Parts:
C34: 100nF; C_Disc_D5.0mm_W2.5mm_P5.00mm
C35: 10uF; CP_Radial_D5.0mm_P2.00mm
J4: 8P8C_Shielded; Amphenol_RJE1D-188_Horizontal_Shielded
J15: Conn_01x03_Pin; PinHeader_1x03_P2.54mm_Vertical
R26, R27: 2.2K; R_Axial_DIN0207_L6.3mm_D2.5mm_P10.16mm_Horizontal
R28, R29: 10K; R_Axial_DIN0207_L6.3mm_D2.5mm_P10.16mm_Horizontal
R100, R101: 120; R_Axial_DIN0207_L6.3mm_D2.5mm_P10.16mm_Horizontal
U16: AM26LS32ACN; DIP-16_W7.62mm; MPN AM26LS32ACN

Connections:
+5V: C34.1, C35.1, J4.4, U16.16 (VCC); also elsewhere on the board
GND: C34.2, C35.2, J4.5, J4.SH, J15.1, R28.1, R29.2, U16.4 (~EN12), U16.8 (GND), U16.12 (EN34); also elsewhere on the board
MBL600_A: J15.3, R26.2, R28.2
MBL600_B: J15.2, R27.2, R29.1
MBL_A_N: J4.6, R100.2, U16.3 (1B)
MBL_A_P: J4.3, R100.1, U16.2 (1A)
MBL_B_N: J4.8, R101.2, U16.7 (2B)
MBL_B_P: J4.7, R101.1, U16.6 (2A)
unnamed: R26.1, U16.1 (1Y)
unnamed: R27.1, U16.5 (2Y)
SCL: J4.2; also elsewhere on the board
SDA: J4.1; also elsewhere on the board

Notes on the sheet:
RJ45 J1 -- shielded 8P8C, T568B pinout Pin 1: SDA (pair 2, white/orange) Pin 2: SCL (pair 2, orange) Pin 3: MBL_A_P (pair 3, white/green) Pin 4: +5V (pair 1, blue) Pin 5: GND (pair 1, white/blue) Pin 6: MBL_A_N (pair 3, green) Pin 7: MBL_B_P (pair 4, white/brown) Pin 8: MBL_B_N (pair 4, brown) Cabl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
Future control functions (not yet designed): - Filament supply on/off relay drive + panel LED - HV supply on/off relay drive + panel LED - T/R relay drive to protect receiver during TX - Additional front-panel indicators / interlocks

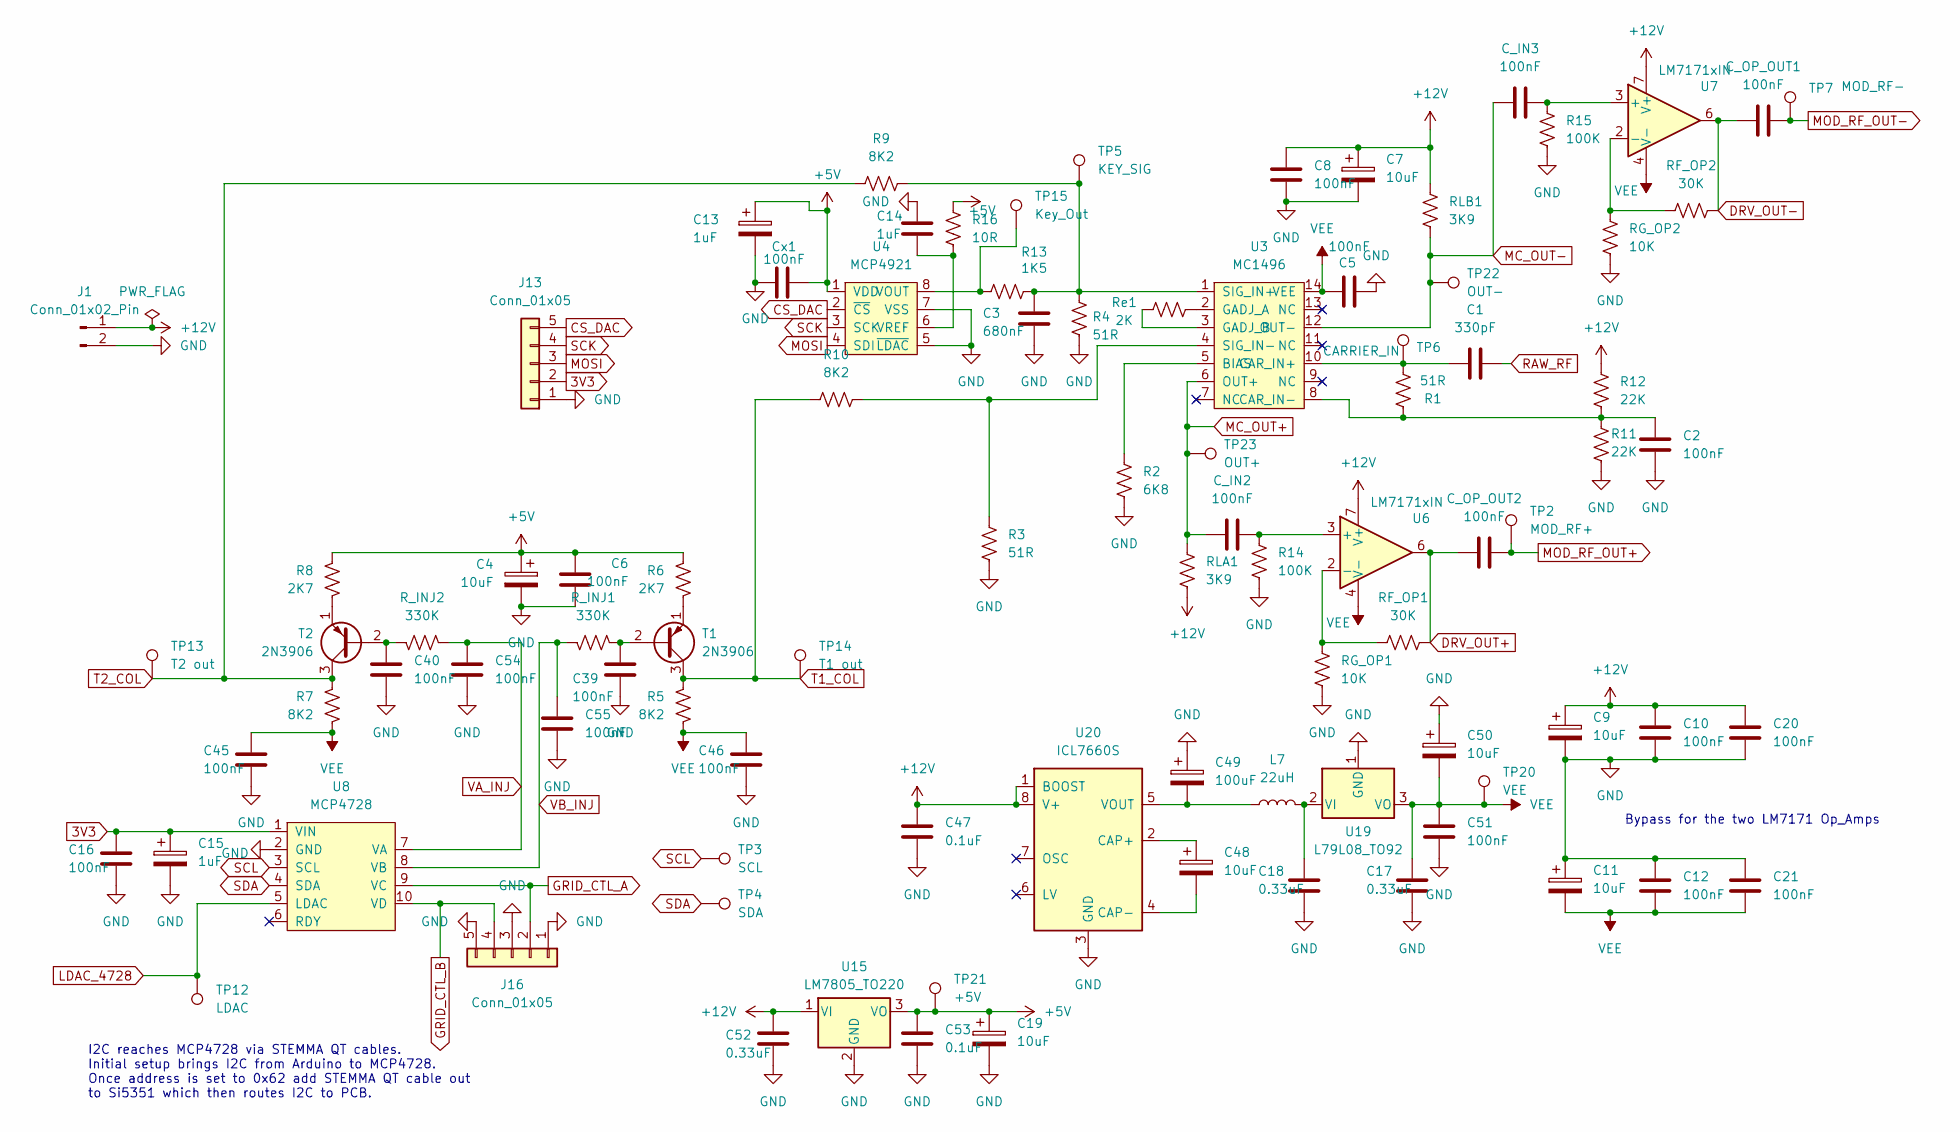
[picture p32: schematic buffer_keyer.kicad_sch]

Parts:
C1: 330pF; C_Disc_D6.0mm_W2.5mm_P5.00mm
C2, C5, C6, C8, C10, C12, C16, C20, C21, C39, C40, C45, C46, C51, C54, C55: 100nF; C_Disc_D5.0mm_W2.5mm_P5.00mm
C3: 680nF; C_Rect_L13.0mm_W6.0mm_P10.00mm_FKS3_FKP3_MKS4
C4, C7, C9, C11, C19, C48, C50: 10uF; CP_Radial_D5.0mm_P2.00mm
C13, C14, C15: 1uF; C_Rect_L7.2mm_W4.5mm_P5.00mm
C17, C18: 0.33uF; Kyocera_SR20_MLCC
C47, C53: 0.1uF; C_Disc_D5.0mm_W2.5mm_P5.00mm
C49: 100uF; CP_Radial_D6.3mm_P2.50mm
C52: 0.33uF; C_Rect_L7.0mm_W3.5mm_P5.00mm
C_IN2, C_IN3: 100nF; C_Disc_D5.0mm_W2.5mm_P5.00mm
C_OP_OUT1, C_OP_OUT2: 100nF; C_Disc_D5.0mm_W2.5mm_P5.00mm
Cx1: 100nF; C_Disc_D5.0mm_W2.5mm_P5.00mm
J1: Conn_01x02_Pin; PinHeader_1x02_P2.54mm_Vertical
J13, J16: Conn_01x05; PinHeader_1x05_P2.54mm_Vertical
L7: 22uH; L_Axial_L7.0mm_D3.3mm_P10.16mm_Horizontal_Fastron_MICC
R1, R3, R4: 51R; R_Axial_DIN0207_L6.3mm_D2.5mm_P10.16mm_Horizontal
R2: 6K8; R_Axial_DIN0207_L6.3mm_D2.5mm_P10.16mm_Horizontal
R5, R7, R9, R10: 8K2; R_Axial_DIN0207_L6.3mm_D2.5mm_P10.16mm_Horizontal
R6, R8: 2K7; R_Axial_DIN0207_L6.3mm_D2.5mm_P10.16mm_Horizontal
R11, R12: 22K; R_Axial_DIN0207_L6.3mm_D2.5mm_P10.16mm_Horizontal
R13: 1K5; R_Axial_DIN0207_L6.3mm_D2.5mm_P10.16mm_Horizontal
R14, R15: 100K; R_Axial_DIN0207_L6.3mm_D2.5mm_P10.16mm_Horizontal
R16: 10R; R_Axial_DIN0207_L6.3mm_D2.5mm_P10.16mm_Horizontal
RF_OP1, RF_OP2: 30K; R_Axial_DIN0207_L6.3mm_D2.5mm_P10.16mm_Horizontal
RG_OP1, RG_OP2: 10K; R_Axial_DIN0207_L6.3mm_D2.5mm_P10.16mm_Horizontal
RLA1: 3K9; R_Axial_DIN0207_L6.3mm_D2.5mm_P10.16mm_Horizontal
RLB1: 3K9; R_Axial_DIN0207_L6.3mm_D2.5mm_P10.16mm_Horizontal
R_INJ1, R_INJ2: 330K; R_Axial_DIN0207_L6.3mm_D2.5mm_P10.16mm_Horizontal
Re1: 2K; R_Axial_DIN0207_L6.3mm_D2.5mm_P10.16mm_Horizontal
T1, T2: 2N3906; TO-92_Inline
TP2: MOD_RF+; PinHeader_1x01_P2.54mm_Vertical
TP3: SCL; PinHeader_1x01_P2.54mm_Vertical
TP4: SDA; PinHeader_1x01_P2.54mm_Vertical
TP5: KEY_SIG; PinHeader_1x01_P2.54mm_Vertical
TP6: CARRIER_IN; PinHeader_1x01_P2.54mm_Vertical
TP7: MOD_RF-; PinHeader_1x01_P2.54mm_Vertical
TP12: LDAC; PinHeader_1x01_P2.54mm_Vertical
TP13: T2 out; PinHeader_1x01_P2.54mm_Vertical
TP14: T1 out; PinHeader_1x01_P2.54mm_Vertical
TP15: Key_Out; PinHeader_1x01_P2.54mm_Vertical
TP20: VEE; PinHeader_1x01_P2.54mm_Vertical
TP21: +5V; PinHeader_1x01_P2.54mm_Vertical
TP22: OUT-; PinHeader_1x01_P2.54mm_Vertical
TP23: OUT+; PinHeader_1x01_P2.54mm_Vertical
U3: MC1496; DIP-14_W7.62mm; MPN MC1496P
U4: MCP4921; DIP-8_W7.62mm; MPN MCP4921-E/P
U6, U7: LM7171xIN; DIP-8_W7.62mm
U8: MCP4728; Adafruit_MCP4728_Breakout; MPN Adafruit 4470
U15: LM7805_TO220; TO-220-3_Vertical
U19: L79L08_TO92; TO-92_Inline
U20: ICL7660S; DIP-8_W7.62mm; MPN ICL7660SCPAZ

Connections:
3V3: C15.1, C16.1, J13.2, U8.1 (VIN); also elsewhere on the board
+5V: C4.1, C6.1, C13.1, C19.1, C53.1, Cx1.2, R6.1, R8.1, R16.1, TP21.1 (1_1), U4.1 (VDD), U15.3 (VO); also elsewhere on the board
+12V: C7.1, C8.1, C9.1, C10.1, C20.1, C47.1, C52.1, J1.1, R12.1, RLA1.1, RLB1.1, U6.7 (V+), U7.7 (V+), U15.1 (VI), U20.1 (BOOST), U20.8 (V+); also elsewhere on the board
CS_DAC: J13.5, U4.2 (~CS)
DRV_OUT+: C_OP_OUT2.1, RF_OP1.2, U6.6
DRV_OUT-: C_OP_OUT1.1, RF_OP2.2, U7.6
GND: C2.2, C3.2, C4.2, C5.2, C6.2, C7.2, C8.2, C9.2, C10.2, C11.1, C12.1, C13.2, C14.1, C15.2, C16.2, C17.2, C18.2, C19.2, C20.2, C21.1, C39.2, C40.2, C45.2, C46.2, C47.2, C49.1, C50.1, C51.2, C52.2, C53.2, C54.2, C55.2, Cx1.1, J1.2, J13.1, J16.1, J16.3, J16.5, R2.2, R3.2, R4.2, R11.2, R14.2, R15.2, RG_OP1.2, RG_OP2.2, U4.5 (~LDAC), U4.7 (VSS), U8.2 (GND), U15.2 (GND), U19.1 (GND), U20.3 (GND); also elsewhere on the board
GRID_CTL_A: J16.2, U8.9 (VC)
GRID_CTL_B: J16.4, U8.10 (VD)
LDAC_4728: TP12.1 (1_1), U8.5 (LDAC)
MC_OUT+: C_IN2.1, RLA1.2, TP23.1 (1_1), U3.6 (OUT+)
MC_OUT-: C_IN3.1, RLB1.2, TP22.1 (1_1), U3.12 (OUT-)
MOD_RF_OUT+: C_OP_OUT2.2, TP2.1 (1_1)
MOD_RF_OUT-: C_OP_OUT1.2, TP7.1 (1_1)
MOSI: J13.3, U4.4 (SDI)
unnamed: C39.1, R_INJ1.1, T1.2 (B)
unnamed: R6.2, T1.1 (E)
unnamed: C40.1, R_INJ2.2, T2.2 (B)
unnamed: R8.2, T2.1 (E)
unnamed: R2.1, U3.5 (BIAS)
unnamed: C1.1, R1.2, TP6.1 (1_1), U3.10 (CAR_IN+)
unnamed: C2.1, R1.1, R11.1, R12.2, U3.8 (CAR_IN-)
unnamed: Re1.2, U3.2 (GADJ_A)
unnamed: Re1.1, U3.3 (GADJ_B)
unnamed: C3.1, R4.1, R9.2, R13.2, TP5.1 (1_1), U3.1 (SIG_IN+)
unnamed: R3.1, R10.2, U3.4 (SIG_IN-)
unnamed: R13.1, TP15.1 (1_1), U4.8 (VOUT)
unnamed: C14.2, R16.2, U4.6 (VREF)
unnamed: C_IN2.2, R14.1, U6.3 (+)
unnamed: RF_OP1.1, RG_OP1.1, U6.2 (-)
unnamed: C_IN3.2, R15.1, U7.3 (+)
unnamed: RF_OP2.1, RG_OP2.1, U7.2 (-)
unnamed: C18.1, L7.2, U19.2 (VI)
unnamed: C48.1, U20.2 (CAP+)
unnamed: C48.2, U20.4 (CAP-)
unnamed: C49.2, L7.1, U20.5 (VOUT)
RAW_RF: C1.2; also elsewhere on the board
SCK: J13.4, U4.3 (SCK)
SCL: TP3.1 (1_1), U8.3 (SCL); also elsewhere on the board
SDA: TP4.1 (1_1), U8.4 (SDA); also elsewhere on the board
T1_COL: R5.1, R10.1, T1.3 (C), TP14.1 (1_1)
T2_COL: R7.1, R9.1, T2.3 (C), TP13.1 (1_1)
VA_INJ: C54.1, R_INJ2.1, U8.7 (VA)
VB_INJ: C55.1, R_INJ1.2, U8.8 (VB)
VEE: C5.1, C11.2, C12.2, C17.1, C21.2, C45.1, C46.1, C50.2, C51.1, R5.2, R7.2, TP20.1 (1_1), U3.14 (VEE), U6.4 (V-), U7.4 (V-), U19.3 (VO)

Notes on the sheet:
Bypass for the two LM7171 Op_Amps
I2C reaches MCP4728 via STEMMA QT cables. Initial setup brings I2C from Arduino to MCP4728. Once address is set to 0x62 add STEMMA QT cable out to Si5351 which then routes I2C to PCB.

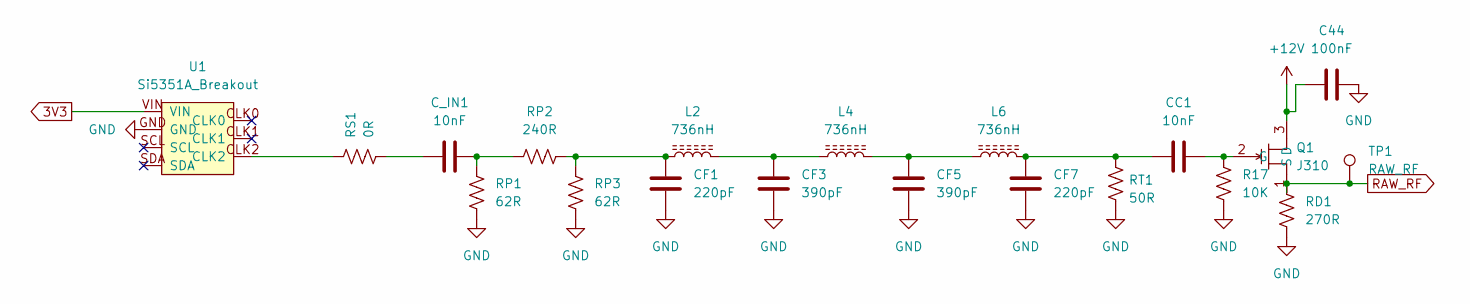
[picture p33: schematic vfo.kicad_sch]

Parts:
C44: 100nF; C_Disc_D5.0mm_W2.5mm_P5.00mm
CC1: 10nF; C_Disc_D5.0mm_W2.5mm_P5.00mm
CF1, CF7: 220pF; C_Disc_D6.0mm_W2.5mm_P5.00mm; Tolerance 1%
CF3, CF5: 390pF; C_Disc_D7.5mm_W2.5mm_P5.00mm; Tolerance 1%
C_IN1: 10nF; C_Disc_D5.0mm_W2.5mm_P5.00mm
L2, L6: 736nH; T68-6_Flat_HandWound
L4: 736nH; T68-6_Vertical_HandWound
Q1: J310; TO-92_Inline; MPN J310
R17: 10K; R_Axial_DIN0207_L6.3mm_D2.5mm_P10.16mm_Horizontal
RD1: 270R; R_Axial_DIN0207_L6.3mm_D2.5mm_P10.16mm_Horizontal
RP1, RP3: 62R; R_Axial_DIN0207_L6.3mm_D2.5mm_P10.16mm_Horizontal
RP2: 240R; R_Axial_DIN0207_L6.3mm_D2.5mm_P10.16mm_Horizontal
RS1: 0R; R_Axial_DIN0207_L6.3mm_D2.5mm_P10.16mm_Horizontal; Tolerance 1%
RT1: 50R; R_Axial_DIN0207_L6.3mm_D2.5mm_P10.16mm_Horizontal; Tolerance 1%
TP1: RAW_RF; PinHeader_1x01_P2.54mm_Vertical
U1: Si5351A_Breakout; Adafruit_Si5351A_STEMMA; MPN Adafruit #5640

Connections:
3V3: U1.VIN; also elsewhere on the board
+12V: C44.1, Q1.3 (D); also elsewhere on the board
GND: C44.2, CF1.2, CF3.2, CF5.2, CF7.2, R17.2, RD1.2, RP1.2, RP3.2, RT1.2, U1.GND; also elsewhere on the board
unnamed: CC1.1, CF7.1, L6.2, RT1.1
unnamed: CF1.1, L2.1, RP2.2, RP3.1
unnamed: CF3.1, L2.2, L4.1
unnamed: CF5.1, L4.2, L6.1
unnamed: C_IN1.1, RS1.2
unnamed: C_IN1.2, RP1.1, RP2.1
unnamed: CC1.2, Q1.2 (G), R17.1
unnamed: RS1.1, U1.CLK2
RAW_RF: Q1.1 (S), RD1.1, TP1.1 (1_1); also elsewhere on the board

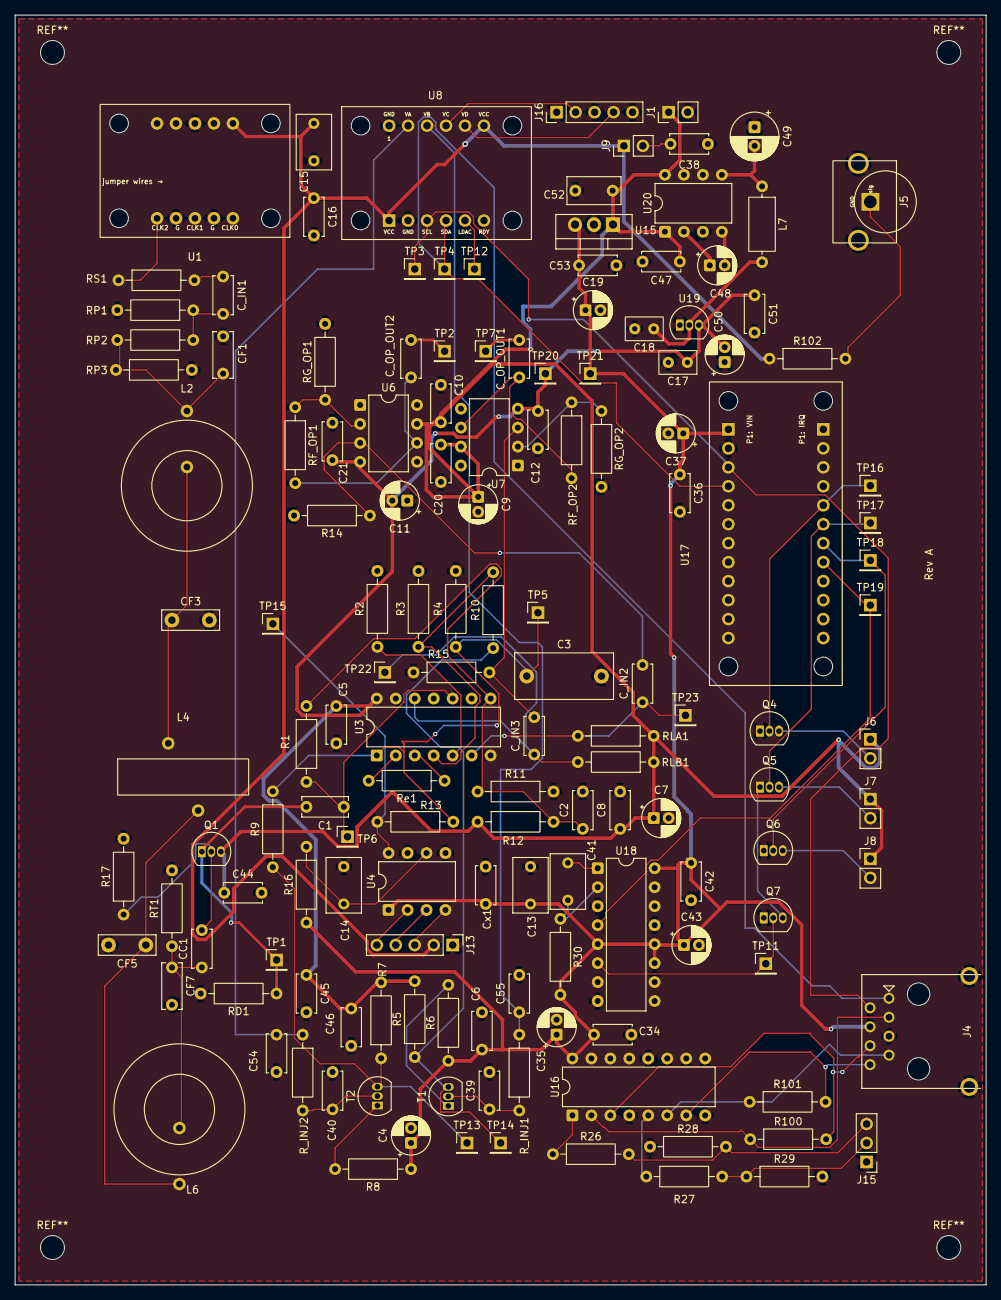
[picture p34: board analog.kicad_pcb from above]

Board: 2 copper layers, 130.0 x 170.0 mm, 147 parts (0 on the bottom side), 74 nets.
