agelders2021/xmitter/firmware/main/console_shell.cpp

// =============================================================================
//  console_shell.cpp — REPL on USB-CDC for first-light bring-up.
// =============================================================================
#include "console_shell.h"

#include <cstdio>
#include <cstdlib>
#include <cstring>

#include "esp_log.h"
#include "esp_console.h"
#include "argtable3/argtable3.h"
#include "driver/gpio.h"

#include "vfo_si5351.h"
#include "front_panel.h"
#include "power_supply.h"
#include "fault_handler.h"
#include "encoders.h"
#include "i2c_scan.h"
#include "mcp4728.h"
#include "pin_map.h"
#include "vfo_knob.h"

namespace shell {

namespace {
constexpr char TAG[] = "shell";

// Shared bus handle, captured by init() so the i2c/mcp4728 commands can
// reach the bus without needing a getter in main.cpp.
i2c_master_bus_handle_t s_bus = nullptr;

// ---- `vfo` command --------------------------------------------------------
struct {
    arg_str_t *action;   // "freq", "on", "off", "status"
    arg_int_t *hz;       // frequency in Hz (used only with "freq")
    arg_end_t *end;
} vfo_args;

int cmd_vfo(int argc, char **argv) {
    int nerr = arg_parse(argc, argv, (void **)&vfo_args);
    if (nerr != 0) {
        arg_print_errors(stderr, vfo_args.end, argv[0]);
        return 1;
    }

    const char *action = vfo_args.action->sval[0];
    if (std::strcmp(action, "freq") == 0) {
        if (vfo_args.hz->count == 0) {
            std::printf("usage: vfo freq <hz>\n");
            return 1;
        }
        uint32_t hz = (uint32_t)vfo_args.hz->ival[0];
        esp_err_t e = front_panel::set_freq_hz(hz);
        std::printf("vfo freq -> %lu Hz : %s\n",
                    (unsigned long)hz, esp_err_to_name(e));
        return (e == ESP_OK) ? 0 : 1;
    }
    if (std::strcmp(action, "on") == 0) {
        esp_err_t e = vfo::on();
        std::printf("vfo on : %s\n", esp_err_to_name(e));
        return (e == ESP_OK) ? 0 : 1;
    }
    if (std::strcmp(action, "off") == 0) {
        esp_err_t e = vfo::off();
        std::printf("vfo off : %s\n", esp_err_to_name(e));
        return (e == ESP_OK) ? 0 : 1;
    }
    if (std::strcmp(action, "status") == 0) {
        std::printf("vfo: %lu Hz, output %s\n",
                    (unsigned long)vfo::current_freq(),
                    vfo::is_on() ? "ON" : "off");
        return 0;
    }
    std::printf("unknown action '%s' (try freq|on|off|status)\n", action);
    return 1;
}

// ---- `status` command -----------------------------------------------------
int cmd_status(int, char **) {
    std::printf("--- xmitter status ---\n");
    std::printf("vfo   : %lu Hz, %s\n",
                (unsigned long)vfo::current_freq(),
                vfo::is_on() ? "ON" : "off");
    std::printf("step  : %lu Hz (idx %u)\n",
                (unsigned long)encoders::step_hz(),
                (unsigned)encoders::step_index());
    std::printf("power : %u %%\n", front_panel::power_pct());
    std::printf("psu   : ");
    switch (psu::state()) {
        case psu::State::Off:          std::printf("OFF\n"); break;
        case psu::State::WarmingUp:    std::printf("WARMING UP\n"); break;
        case psu::State::Ready:        std::printf("READY\n"); break;
        case psu::State::ShuttingDown: std::printf("SHUTTING DOWN\n"); break;
        case psu::State::Fault:        std::printf("FAULT\n"); break;
    }
    std::printf("fault : %s\n",
                fault::is_asserted() ? "ASSERTED" : "clear");
    return 0;
}

// ---- `step` command -------------------------------------------------------
struct {
    arg_int_t *idx;     // optional new index
    arg_end_t *end;
} step_args;

int cmd_step(int argc, char **argv) {
    int nerr = arg_parse(argc, argv, (void **)&step_args);
    if (nerr != 0) {
        arg_print_errors(stderr, step_args.end, argv[0]);
        return 1;
    }
    if (step_args.idx->count > 0) {
        encoders::set_step_index((size_t)step_args.idx->ival[0]);
    }
    std::printf("step = %lu Hz (idx %u)\n",
                (unsigned long)encoders::step_hz(),
                (unsigned)encoders::step_index());
    std::printf("table: ");
    for (size_t i = 0; i < encoders::FREQ_STEP_TABLE_LEN; ++i) {
        std::printf("[%u]=%lu%s", (unsigned)i,
                    (unsigned long)encoders::FREQ_STEP_HZ_TABLE[i],
                    (i + 1 < encoders::FREQ_STEP_TABLE_LEN) ? "  " : "\n");
    }
    return 0;
}

// ---- `i2c` command --------------------------------------------------------
struct {
    arg_str_t *action;   // "scan"
    arg_end_t *end;
} i2c_args;

int cmd_i2c(int argc, char **argv) {
    int nerr = arg_parse(argc, argv, (void **)&i2c_args);
    if (nerr != 0) {
        arg_print_errors(stderr, i2c_args.end, argv[0]);
        return 1;
    }
    const char *action = i2c_args.action->sval[0];
    if (std::strcmp(action, "scan") == 0) {
        if (s_bus == nullptr) {
            std::printf("i2c: bus handle not initialized\n");
            return 1;
        }
        return (i2c_scan::scan(s_bus) == ESP_OK) ? 0 : 1;
    }
    std::printf("usage: i2c scan\n");
    return 1;
}

// ---- `mcp4728` command ----------------------------------------------------
// Only subcommand right now is `reprogram <cur> <new>`.  Both addresses are
// required — no defaults, so an accidental `mcp4728 reprogram` can never
// burn EEPROM.  Also gated on a `-y` flag that must be typed explicitly.
struct {
    arg_str_t *action;
    arg_str_t *cur;      // "0x60"
    arg_str_t *neu;      // "0x67"
    arg_lit_t *yes;      // -y required to actually burn
    arg_end_t *end;
} mcp_args;

int cmd_mcp4728(int argc, char **argv) {
    int nerr = arg_parse(argc, argv, (void **)&mcp_args);
    if (nerr != 0) {
        arg_print_errors(stderr, mcp_args.end, argv[0]);
        return 1;
    }
    if (std::strcmp(mcp_args.action->sval[0], "reprogram") != 0) {
        std::printf("usage: mcp4728 reprogram <cur_hex> <new_hex> [-y]\n");
        return 1;
    }
    if (mcp_args.cur->count == 0 || mcp_args.neu->count == 0) {
        std::printf("usage: mcp4728 reprogram <cur_hex> <new_hex> [-y]\n");
        std::printf("  cur, new must be in range 0x60..0x67\n");
        return 1;
    }

    // Parse hex addresses (accept "0x60" or "60").
    uint8_t cur = (uint8_t)std::strtoul(mcp_args.cur->sval[0], nullptr, 16);
    uint8_t neu = (uint8_t)std::strtoul(mcp_args.neu->sval[0], nullptr, 16);

    // Plan and print the byte pattern so the user can eyeball vs. datasheet.
    uint8_t bytes[3];
    esp_err_t e = mcp4728::plan_reprogram_bytes(cur, neu, bytes);
    if (e != ESP_OK) {
        std::printf("mcp4728: invalid address (must be 0x60..0x67)\n");
        return 1;
    }

    std::printf("\n");
    std::printf("MCP4728 EEPROM reprogram plan\n");
    std::printf("  current addr : 0x%02X\n", cur);
    std::printf("  new addr     : 0x%02X\n", neu);
    std::printf("  LDAC pin     : GPIO %d (held LOW for the transaction)\n",
                (int)pins::MCP4728_LDAC);
    std::printf("  I2C bytes    : 0x%02X 0x%02X 0x%02X\n",
                bytes[0], bytes[1], bytes[2]);
    std::printf("                 (byte1 = slave addr + W;\n");
    std::printf("                  byte2 = Write-Addr cmd + new bits;\n");
    std::printf("                  byte3 = Confirm byte)\n");

    if (mcp_args.yes->count == 0) {
        std::printf("\nDry run only.  Add -y to actually burn EEPROM.\n");
        return 0;
    }

    std::printf("\nBURNING EEPROM ...\n");
    e = mcp4728::reprogram_address(s_bus, cur, neu, pins::MCP4728_LDAC);
    if (e != ESP_OK) {
        std::printf("mcp4728: reprogram_address failed: %s\n",
                    esp_err_to_name(e));
        return 1;
    }
    std::printf("mcp4728: sequence sent.  Run `i2c scan` now to confirm.\n");
    return 0;
}

// ---- `knob` command -------------------------------------------------------
// Bench-test shim for the MBL-600 -> VFO path.  Reuses the same tier math
// as a real knob turn -- lets you exercise the whole chain before the
// encoder is physically wired.
//   knob turn <N>   inject N ticks (signed; negative = counter-clockwise)
//   knob stats      dump the internal counters
struct {
    arg_str_t *action;
    arg_int_t *n;
    arg_end_t *end;
} knob_args;

int cmd_knob(int argc, char **argv) {
    int nerr = arg_parse(argc, argv, (void **)&knob_args);
    if (nerr != 0) {
        arg_print_errors(stderr, knob_args.end, argv[0]);
        return 1;
    }
    const char *action = knob_args.action->sval[0];

    if (std::strcmp(action, "turn") == 0) {
        if (knob_args.n->count == 0) {
            std::printf("usage: knob turn <N>   (N = signed ticks)\n");
            return 1;
        }
        int n = knob_args.n->ival[0];
        if (n < INT16_MIN || n > INT16_MAX) {
            std::printf("knob turn: N out of int16 range\n");
            return 1;
        }
        knob::g_vfo_knob.inject((int16_t)n);
        std::printf("knob turn %+d -> vfo now %lu Hz\n",
                    n, (unsigned long)vfo::current_freq());
        return 0;
    }
    if (std::strcmp(action, "stats") == 0) {
        auto s = knob::g_vfo_knob.stats();
        std::printf("knob: polls=%lu last_delta=%lu last_mult=%lu total=%lu base_step=%lu Hz\n",
                    (unsigned long)s.poll_count,
                    (unsigned long)s.last_delta,
                    (unsigned long)s.last_multiplier,
                    (unsigned long)s.total_ticks_abs,
                    (unsigned long)knob::g_vfo_knob.base_step_hz());
        return 0;
    }
    if (std::strcmp(action, "gpio") == 0) {
        // Diagnostic: read both encoder GPIO levels directly.
        // A(GPIO2) should toggle with the encoder; if it always reads 0 or 1
        // regardless of knob position, the signal is stuck -- check wiring
        // and the AM26LS32 channel A receiver.
        int a = gpio_get_level(pins::ENC_FREQ_A);
        int b = gpio_get_level(pins::ENC_FREQ_B);
        auto s = knob::g_vfo_knob.stats();
        std::printf("ENC_FREQ_A GPIO2 = %d\n", a);
        std::printf("ENC_FREQ_B GPIO3 = %d\n", b);
        std::printf("ISR fires since boot: %lu\n", (unsigned long)s.poll_count);
        std::printf("Total |ticks|: %lu\n", (unsigned long)s.total_ticks_abs);
        if (s.poll_count == 0)
            std::printf("  ** poll_count=0: no encoder edges detected (PCNT not firing)\n");
        return 0;
    }
    std::printf("unknown action '%s' (try turn|stats|gpio)\n", action);
    return 1;
}

// ---- `psu` command --------------------------------------------------------
struct {
    arg_str_t *action;
    arg_end_t *end;
} psu_args;

int cmd_psu(int argc, char **argv) {
    int nerr = arg_parse(argc, argv, (void **)&psu_args);
    if (nerr != 0) {
        arg_print_errors(stderr, psu_args.end, argv[0]);
        return 1;
    }
    const char *a = psu_args.action->sval[0];
    if (std::strcmp(a, "on") == 0)  { return psu::on()  == ESP_OK ? 0 : 1; }
    if (std::strcmp(a, "off") == 0) { return psu::off() == ESP_OK ? 0 : 1; }
    std::printf("usage: psu on | psu off\n");
    return 1;
}

void register_commands() {
    // vfo
    vfo_args.action = arg_str1(nullptr, nullptr, "ACTION", "freq|on|off|status");
    vfo_args.hz     = arg_int0(nullptr, nullptr, "HZ", "frequency in Hz (for `freq`)");
    vfo_args.end    = arg_end(2);
    esp_console_cmd_t vfo_cmd = {};
    vfo_cmd.command  = "vfo";
    vfo_cmd.help     = "Control the Si5351 VFO";
    vfo_cmd.func     = &cmd_vfo;
    vfo_cmd.argtable = &vfo_args;
    ESP_ERROR_CHECK(esp_console_cmd_register(&vfo_cmd));

    // status
    esp_console_cmd_t status_cmd = {};
    status_cmd.command = "status";
    status_cmd.help    = "Print overall rig status";
    status_cmd.func    = &cmd_status;
    ESP_ERROR_CHECK(esp_console_cmd_register(&status_cmd));

    // step
    step_args.idx = arg_int0(nullptr, nullptr, "IDX",
                             "step-table index (omit to query)");
    step_args.end = arg_end(2);
    esp_console_cmd_t step_cmd = {};
    step_cmd.command  = "step";
    step_cmd.help     = "Show or set the frequency-step index";
    step_cmd.func     = &cmd_step;
    step_cmd.argtable = &step_args;
    ESP_ERROR_CHECK(esp_console_cmd_register(&step_cmd));

    // psu
    psu_args.action = arg_str1(nullptr, nullptr, "ACTION", "on|off");
    psu_args.end    = arg_end(2);
    esp_console_cmd_t psu_cmd = {};
    psu_cmd.command  = "psu";
    psu_cmd.help     = "Power-supply on/off (stub)";
    psu_cmd.func     = &cmd_psu;
    psu_cmd.argtable = &psu_args;
    ESP_ERROR_CHECK(esp_console_cmd_register(&psu_cmd));

    // knob
    knob_args.action = arg_str1(nullptr, nullptr, "ACTION", "turn|stats|gpio");
    knob_args.n      = arg_int0(nullptr, nullptr, "N",
                                "signed tick count (for `turn`)");
    knob_args.end    = arg_end(2);
    esp_console_cmd_t knob_cmd = {};
    knob_cmd.command  = "knob";
    knob_cmd.help     = "MBL-600 knob shim.  `knob turn <N>` injects ticks; "
                        "`knob stats` prints internal counters; "
                        "`knob gpio` reads GPIO2/3 levels and ISR count.";
    knob_cmd.func     = &cmd_knob;
    knob_cmd.argtable = &knob_args;
    ESP_ERROR_CHECK(esp_console_cmd_register(&knob_cmd));

    // i2c
    i2c_args.action = arg_str1(nullptr, nullptr, "ACTION", "scan");
    i2c_args.end    = arg_end(2);
    esp_console_cmd_t i2c_cmd = {};
    i2c_cmd.command  = "i2c";
    i2c_cmd.help     = "I2C bus utilities (currently: scan)";
    i2c_cmd.func     = &cmd_i2c;
    i2c_cmd.argtable = &i2c_args;
    ESP_ERROR_CHECK(esp_console_cmd_register(&i2c_cmd));

    // mcp4728
    mcp_args.action = arg_str1(nullptr, nullptr, "ACTION", "reprogram");
    mcp_args.cur    = arg_str0(nullptr, nullptr, "CUR",
                               "current addr hex (0x60..0x67)");
    mcp_args.neu    = arg_str0(nullptr, nullptr, "NEW",
                               "new addr hex (0x60..0x67)");
    mcp_args.yes    = arg_lit0("y", "yes",
                               "actually burn EEPROM (omit for dry run)");
    mcp_args.end    = arg_end(4);
    esp_console_cmd_t mcp_cmd = {};
    mcp_cmd.command  = "mcp4728";
    mcp_cmd.help     = "MCP4728 utilities.  reprogram <cur> <new> [-y] "
                       "moves the EEPROM I2C address (one-time per rig).";
    mcp_cmd.func     = &cmd_mcp4728;
    mcp_cmd.argtable = &mcp_args;
    ESP_ERROR_CHECK(esp_console_cmd_register(&mcp_cmd));
}

}  // namespace

esp_err_t init(i2c_master_bus_handle_t bus) {
    s_bus = bus;

    // REPL config: USB-Serial-JTAG, history, prompt.
    esp_console_repl_t *repl = nullptr;
    esp_console_repl_config_t repl_cfg = ESP_CONSOLE_REPL_CONFIG_DEFAULT();
    repl_cfg.prompt          = "xmitter> ";
    repl_cfg.max_cmdline_length = 128;

    esp_console_dev_usb_serial_jtag_config_t hw_cfg =
        ESP_CONSOLE_DEV_USB_SERIAL_JTAG_CONFIG_DEFAULT();

    ESP_ERROR_CHECK(esp_console_new_repl_usb_serial_jtag(&hw_cfg, &repl_cfg, &repl));
    esp_console_register_help_command();
    register_commands();
    ESP_ERROR_CHECK(esp_console_start_repl(repl));

    ESP_LOGI(TAG, "USB-CDC shell ready (type 'help')");
    return ESP_OK;
}

}  // namespace shell
