agelders2021/xmitter/xmitter_prj/sweep_param.py

import runpy, os, sys
_tools = os.path.abspath(os.path.join(os.path.dirname(__file__), '..', 'tools'))
if _tools not in sys.path:
    sys.path.insert(0, _tools)
runpy.run_path(os.path.join(_tools, 'sweep_param.py'), run_name='__main__')
