agelders2021/xmitter/(commit log)

2026-05-31 Initial consolidation: clean repo from workspace
    Fresh structure replacing legacy split workspace/repo setup.
    xmitter_prj/: schematics, tube libs, pchar data, wrapper scripts
    tools/: all Python and PowerShell analysis scripts
    Documentation/: datasheets and design notes
    Absolute paths updated from QucsWorkspace to Git Backed Projects
    [ATU_subcircuit.sch, Balun_6to1_subcircuit.sch, Driver_output_transformer_subcircuit.sch, Driver_subcircuit.sch, Driver_tank_subcircuit.sch, LPF_50ohm_subcircuit.sch, LPF_subcircuit.sch, PA_subcircuit.sch]
2026-06-01 Add Q2 stage documentation, schematics, and SPICE support files
    - 20m-leveled-keyed-buffer.md: full design spec for pad/LPF/Q1/Q2/T1/leveling loop
    - Q2-stage-schematic-entry.md: node-by-node schematic entry companion
    - Q2-stage-schematic.pdf + draw_q2_schematic.py: generated Q2 circuit diagram
    - jfet-j308-j309-j310-interfet.pdf: J310 datasheet reference
    - j310.lib: J310 SPICE model (Koren-style)
    - test_vfo_pad_lpf_q1.sp: Q1 input stage testbench netlist
    - vfo_subcircuit.sch, vfo_buffer_subcircuit.sch: QUCS-S schematics (corrected polarity, 3.3V, D/S)
    [vfo_buffer_subcircuit.sch, vfo_subcircuit.sch]
2026-06-02 J310 cascode VGA simulation: AGC divider, documentation, and library files
    vfo_buffer_subcircuit.sch: J310 dual cascode (Q2a CS + Q2b CG) with DAC+divider
    AGC circuit (R_VB/R2/V_ZEN), tank L1||C1a+C1b at 14.175 MHz. Basis for
    redesign to MC1496 VCA with RFC drain load.
    [vfo_buffer_subcircuit.sch, vfo_subcircuit.sch, xmitter.sch]
2026-06-02 MC1496 Gilbert-cell VCA buffer: simulation, schematic, and documentation
    - mc1496.lib: behavioral SPICE subcircuit (B-source tanh model, 10 ports)
    - mc1496_buffer_test.sp: standalone ngspice test (null/max-gain/sweep runs)
    - vfo_buffer_subcircuit.sch: QUCS-S testbench; fixes VDD stubs T-junctioning
    the carrier bus at y=240 and V_VEE polarity (angle 0->2)
    - gen_buffer_schematic.py: matplotlib signal-flow PDF generator
    - mc1496_buffer_signal_flow.pdf: signal-flow schematic for reference
    - MC1496-D.PDF, MC1496-D1.PDF: ON Semi datasheets
    - 20m-leveled-keyed-buffer.md: updated for MC1496 VCA topology
    [vfo_buffer_subcircuit.sch]
2026-06-02 vfo_buffer_subcircuit.sch: layout cleanup for readability
    [vfo_buffer_subcircuit.sch]
2026-06-02 Arduino CW envelope keyer: initial implementation and documentation
    - Arduino_code/cw_envelope_keyer.cpp: Arduino interface for CW keying,
    DAC control (MCP4921), and envelope shaping
    - Documentation/cw_envelope_keyer.md: design notes and interface spec
    - Documentation/MC4921.pdf: MCP4921 DAC datasheet
2026-06-03 Key shaping chain: add signal-flow schematic PDF and generator script
    Documents the DAC → 2-pole RC LPF → TL072 gain stage → MC1496 modulating
    port path, including component values, gain calculation, and trim calibration
    note.
2026-06-03 KiCad library: add xmitter.kicad_sym with MC1496, MCP4921, TL072 symbols
    DIP pinouts verified against datasheets; MPN and Manufacturer fields
    populated for BOM export.
2026-06-04 KiCad project: initial schematic sheets and updated symbol library
    Add hierarchical KiCad schematic (arduino, balun, buffer_keyer, driver,
    lpf_output, pa, vfo sheets). Update xmitter.kicad_sym with TL072, MCP4921
    (MPN fields), ADS1115, ST7735_Display, and W5500 symbols. Add KiCad
    entries to .gitignore (.history/, lock files, bak files).
    [Digital_subcircuit.sch, KiCAD.kicad_pcb, KiCAD.kicad_sch, arduino.kicad_sch, balun.kicad_sch, buffer_keyer.kicad_sch, driver.kicad_sch, lpf_output.kicad_sch]
2026-06-04 KiCad library: add 6N137 high-speed optoisolator symbol
    DIP-8, open-collector output; A/K LED inputs, VE enable, VO output.
    For CW paddle dit/dah isolation.
2026-06-04 KiCad library: add Encoder_5734 rotary encoder symbol
    3-terminal (A, B, C common), 100 PPR panel-mount, no pushbutton.
2026-06-04 KiCad library: add reference PDF with pinouts and design gotchas
    4-page document covering all 8 symbols (MC1496, MCP4921, TL072,
    ADS1115, ST7735, W5500, 6N137, Encoder_5734). Includes design notes,
    supplier warnings, and gotchas such as 6N137 VE pin and MC1496
    VEE polarity.
2026-06-04 KiCad library: add Metro ESP32-S3 module symbol
    18 left pins (RESET, 3V3, AREF, GND, D0-D13) and 16 right pins
    (VIN, GND x2, 5V, 3V3, A0-A5, SPI header, TX1/RX1). Pin numbers
    use Arduino/Metro label names. Verify pinout against board pinout
    diagram before wiring.
2026-06-04 KiCad library doc: add Metro ESP32-S3 entry
    Includes full pin table (34 pins) and gotchas: pinout verification
    warning, SPI pin sharing, STEMMA QT / A4-A5 note, WiFi/RFI note.
    PDF now 5 pages.
2026-06-04 KiCad library: move sym file to project dir, fix KiCad 10 compatibility
    - Move xmitter.kicad_sym from xmitter_prj/kicad/ to KiCAD/ so it
    co-locates with the project and resolves via ${KIPRJMOD}
    - Add sym-lib-table registering xmitter as a project-specific library
    - Add missing pin shape keyword 'line' to all 103 pins (KiCad requires
    <type> <shape> syntax; omitting shape caused silent parse failure)
    - Update header: version 20241209, generator quoted, generator_version 9.0
    - Add exclude_from_sim no to all 9 symbols
    - Strip UTF-8 BOM introduced by PowerShell Set-Content (KiCad 10 silently
    treats a BOM-prefixed file as an empty library)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
2026-06-04 KiCad library: add Si5351A_Breakout (Adafruit #5640)
    7-pin symbol: VIN, GND, SCL, SDA on left; CLK0, CLK1, CLK2 on right.
    I2C address 0x60, STEMMA QT, 8 kHz-160 MHz. Update library doc PDF.
2026-06-04 KiCad arduino sheet: add Si5351A breakout with CLK0 global label
    Place Si5351A_Breakout symbol on arduino sheet and wire CLK0 output
    as a global label for inter-sheet connection to the VFO sheet.
    [arduino.kicad_sch]
2026-06-07 QUCS keyer: add MC1496 keyer subcircuit with PNP-based digital null
    PNP common-emitter pair driven by complementary DAC channels injects
    differential current into MC1496 signal port pins 1/4 for digital
    carrier null. V4=+5V emitter supply, R5=R7=R9=R10=8.2k, R6=R8=2.7k
    give symmetric ~1 mA standing current and ~16 mV null range per pin.
    Carrier port: pin 8 DC-biased to +6V via R11/R12 divider and AC-
    bypassed by C2; pin 10 receives single-ended carrier through C1
    (330 pF). VEE rails for the MC1496 and the null collector loads
    are driven by separate -8.3V sources (V6 and V7).
    [keyer.sch]
2026-06-07 QUCS keyer: add envelope LPF + level scaler, drop obsolete VCA buffer sch
    keyer.sch:
    - Add reconstruction LPF + level scaler at MC1496 pin 1 (R13=1.5k,
    C3=680nF film). Combined with R4=51 ohm at pin 1 this gives ~108 mV
    peak from a 3.3V MCP4921 DAC, -3 dB at 4.75 kHz, -18 dB at the
    40 kHz first DAC image.
    - Drop carrier-port bias divider current: R11/R12 1k -> 22k (-93% Iq).
    - Expose OUT1/OUT2 differential output ports for the driver stage.
    xmitter_prj/vfo_buffer_subcircuit.sch removed -- superseded by keyer.sch.
    Docs:
    - cw_envelope_keyer.md: replace the LPF placeholder with the actual
    R_F/C_F design + performance table; mark recon-filter sim as
    "verify" rather than "design".
    - 2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
    [keyer.sch, vfo_buffer_subcircuit.sch]
2026-06-07 Work in Progress
    [arduino.kicad_sch, vfo.kicad_sch]
2026-06-08 QUCS keyer: complete R10 symmetry fix (1k->8.2k) + add standalone-sim sources
    R10 was missed in the earlier symmetry pass; now matches R5/R7/R9 = 8.2k,
    eliminating the residual ~13 mV standing differential at the signal port.
    Added internal test sources for standalone transient sim of the keyer
    subcircuit (V8 = 1.65 V for DAC1/DAC2, V9 = 3.3 V for KEY_IN). Useful
    for debugging the modulator gain without rerunning the full xmitter chain.
    Checkpoint commit before further edits.
    [keyer.sch]
2026-06-09 xmitter chain: PA validation hits 50W within tube ratings; modulator in linear mode
    VFO subcircuit:
    - Pi pad: 6 dB -> 20 dB (RP1/RP3: 150 -> 62 ohm; RP2: 39 -> 240 ohm)
    drops V_RF_IN to keyer from ~380 mV to ~38 mV peak, putting MC1496
    carrier port in linear-multiplier mode
    - LPF: 5-pole -> 7-pole Chebyshev (same fc = 17.5 MHz, 0.1 dB ripple)
    adds LF6 (13t T50-6) and CF7 (220 pF); LF4 bumped to 14t (~715 nH)
    centre; harmonic rejection improves 15-37 dB at 2f/3f/5f -- needed
    now that the modulator passes carrier harmonics straight through
    Keyer subcircuit:
    - R10 = 8.2k (was 1k) - completes the symmetry fix with R5/R7/R9 for
    balanced PNP null injection
    - Re = 200 ohm (was 1k) - ra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
    [Balun_6to1_subcircuit.sch, Op_Amp_Out.sch, PA_subcircuit.sch, keyer.sch, vfo_subcircuit.sch, xmitter.sch]
2026-06-09 tools: add sweep_param.py + earlier tool catchup; gui_plot/plot UX fixes
    sweep_param.py (NEW):
    Generic ngspice parameter sweep. Substitutes a regex-captured value
    in a netlist, runs ngspice in parallel across N workers (default:
    CPU count - 1), parses each spice4qucs rawfile, computes a chosen
    metric on a chosen probe. Supports mean/peak/peak_neg/peak_abs/
    peak_to_peak/rms/p_into_r. Mean and RMS use trapezoidal time-
    weighting via the rawfile's actual timestamps -- ngspice's adaptive
    timestep biases simple arithmetic statistics badly enough to make
    results non-monotonic in obviously-monotonic physical sweeps.
    Tested on 27-value C_TANK, R_load, and V6 drive sweeps; runs in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
    [draw_mc1496_schematic.py, gen_bom.py, gen_mc1496_schematic_pdf.py, gui_plot.py, plot.py, sweep_ctank.py, sweep_param.py]
2026-06-09 docs: 2026-06-08 PA validation session log + design-doc updates + references
    NEW: Documentation/2026-06-08-pa-validation.md
    Complete session log of the PA validation work. Covers what changed
    in each subcircuit (vfo, keyer, PA, balun, Op_Amp_Out), the R17 and
    V6 sweep results, the operating point recommendation (50 W at V6 =
    200 V on R17 = 300 ohm with 15 W/tube plate dissipation, 63% eff),
    and lessons-learned for ngspice quirks worth remembering (transient
    sampling, uic flag auto-emit, diode-in-series-with-Vsrc convergence
    pitfalls, Koren-model negative I_plate artifact).
    UPDATED: cw_envelope_keyer.md
    - Signal-path diagram now shows LM7171 post-amp + driver path
    - Added "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
    [BOM.xlsx]
2026-06-09 PA: grid-voltage-aware operating point + paired bias/drive sweep tool
    Updated PA operating point to honor the 6146B grid voltage spec (-150V max):
    - GRID bias: -65V (was -70V) -- gives 5V headroom on the grid -150V limit
    - V6 drive: 160V (was 200V) -- corresponding reduction to stay in spec
    - R17: 300 ohm, V_supply: 600V (unchanged)
    The earlier validated 50W operating point (bias -70V, V6 200V) was producing
    peak grid voltage of -170V, exceeding the -150V spec by 20V. The new operating
    point trades some output (~40W vs 50W) for grid voltage compliance.
    Plan for 50W within spec (per bias_drive sweep results, see tool below):
    - Hardware bias supply: -65 to -70V (safe default at power-up)
    - F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
    [PA_subcircuit.sch, xmitter.sch]
2026-06-09 docs: PA validation operating point corrected for grid voltage spec
    The earlier "V6=200V / bias=-70V / 50W / 15W/tube dissipation" recommendation
    in 2026-06-08-pa-validation.md was producing peak negative grid voltage of
    -170V, exceeding the 6146B -150V grid spec by 20V. Exceeding peak grid
    voltage is one of the fastest failure modes for vacuum tubes, so this is the
    binding constraint, not dissipation.
    Doc updated to:
    - Add "Grid voltage constraint" section explaining the -150V limit and how
    it constrains the (bias, V6) operating envelope
    - Add the bias_drive sweep table (-75V to -45V bias paired with V6 from 150V
    to 210V, each at the -150V grid spec limit) showing the trade-off:
    diss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
2026-06-09 keyer.sch: add 1M output-DC-return resistors; restore Re to 200 ohm
    Two related changes to keyer.sch fixing a standalone-sim convergence issue
    that surfaced when the keyer-only sim couldn't establish a DC operating
    point for the LM7171 op-amp outputs.
    1. Added two 1M ohm resistors from the Out1 and Out2 ports to GND. Both
    op-amp outputs were AC-coupled (100 nF C_OUT inside Op_Amp_Out) with
    no DC path to ground externally -- the standalone keyer sim left those
    nets floating. In the full xmitter chain, the driver subcircuit
    provides the DC return, so this only mattered for standalone.
    1M ohm chosen (vs. the 100 ohm "simulate-the-driver-input" alternative)
    because at 14 MHz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
    [keyer.sch, xmitter.sch]
2026-06-10 Checkpoint: grid_bias.sch standalone test schematic before subcircuit refactor
    Current state: monolithic schematic with bias circuit + test sources +
    parameter sweep all mixed together. Symbol uses 'auto' template (works
    where 'opamp5t' didn't accept Port-name mapping in QUCS-S 26.1.1).
    Committed as a checkpoint before refactoring into separate subcircuit
    + test wrapper so we can revert if needed.
    [grid_bias.sch]
2026-06-10 grid_bias.sch: refactor as 2-port subcircuit (Control_In, Grid_Bias_Out)
    Removed test sources (DAC, sweep, .DC, probe, test load) and added
    Port symbols for Control_In (DAC drive) and Grid_Bias_Out (to 6146B
    grid). Internal supplies (+12V, +5V LM4040, -85V) stay inside since
    all instances share the same rails.
    OPA454 (auto template), R_pad, R_G, R_F, R_GL all positioned and
    wired correctly:
    - R_pad: Control_In -> (+) input
    - R_G: (-) input -> +5V reference
    - R_F: feedback from output to (-) input (correct topology)
    - R_GL: 22k from output to Grid_Bias_Out port
    Transfer: V_out = V_DAC * 18 - 85 (V_DAC = 0 -> -85V IDLE,
    V_DAC = 1.94V -> -50V OPERATE).
    Ready to be instantiated from a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
    [grid_bias.sch]
2026-06-10 grid_bias: complete OPA454-based bias subcircuit + test wrapper + tooling
    Adds the per-tube 6146B grid bias circuit work:
    xmitter_prj/opa454.lib
    TI's PSpice OPA454 model converted to ngspice (PSpice expression
    VCVS -> Berkeley B-source). Includes 5-pin wrapper OPA454_5PIN that
    ties the enable pin HIGH internally and exposes only +IN/-IN/V+/V-/OUT.
    Smoke-tested: unity-gain follower tracks input to within typical V_OS;
    bias circuit produces V_out = V_DAC * 18 - 85 at OPERATE point.
    xmitter_prj/grid_bias_check.sch
    Test wrapper schematic instantiating grid_bias as a Sub component.
    V1 (Vdc, 0V) drives Control_In, 1MOhm load on Grid_Bias_Out, VProbe
    on the output, .DC + .SW sweep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
    [grid_bias_check.sch]
2026-06-10 docs: grid bias schematic PDF + QUCS-S gotchas catalog
    Documentation/Grid_Bias_Schematic.pdf (NEW, 5 pages)
    - Page 1-2: Design A (OPA454 HV op-amp, +12V / -85V supplies, 97V
    total within OPA454's 100V op max and 120V abs max)
    - Page 3-4: Design B (LM358 LV op-amp + MPSA92 PNP level-shifter,
    same transfer function, no HV op-amp dependency)
    - Page 5: Shared notes -- two-state IDLE/OPERATE firmware sequencing
    (-85V cutoff key-up, -50V class C key-down, ~200us bias transition
    before envelope opens), fail-safe layers, layout notes, A vs B
    comparison table
    Documentation/opa454.pdf
    Reference: TI OPA454 datasheet. Confirmed 120V V+/V- absolute max
    (we operate at 97V, c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
    [draw_grid_bias_schematic.py, gen_grid_bias_schematic_pdf.py]
2026-06-10 schematics: PA_subcircuit + xmitter top + grid_bias_check QUCS-S edits
    User-side QUCS-S edits captured in a single checkpoint:
    PA_subcircuit.sch: integrated grid_bias as a Sub into the PA stage so
    the per-tube bias is now sourced from inside the PA subcircuit (vs.
    external supplies on a test bench).
    grid_bias_check.sch: small layout tweak + the .DC/.SW sweep fix
    (DAC_V -> V1 source name; SpicePar removed) per the earlier debug
    session.
    xmitter.sch: top-level rewire to match the PA_subcircuit interface
    change.
    Checkpoint commit before adding the CT_FAULT bias-slam MOSFET to
    grid_bias.sch.
    [PA_subcircuit.sch, grid_bias_check.sch, xmitter.sch]
2026-06-10 docs: PA cathode current monitor + 7-layer failsafe chain
    Documentation/pa_cathode_monitor.md (NEW)
    Per-tube cathode-current monitoring design for the push-pull 6146B PA,
    with seven defensive layers between a hot cathode (+1V nominal, may
    see 600V on R_C open fault) and the MCU ADC pin:
    L0: R_C (10 ohm 1W) + C_BYP at tube socket; sense tap BEFORE C_BYP
    L1: PTC fuse (Bourns MF-R010, 100mA hold, thermal slow-blow)
    L2: R_S = 10k series limit -> 60mA max fault current at 600V short
    L3: BAT54 Schottky clamps to GND / +3.3V + C_FILT (1nF anti-alias)
    L4: OPA1641 unity-gain buffer (+5V / GND, +/-20V input protection)
    L5: LM393 hardware comparator -> SR latch -> watchdog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
    [draw_cathode_monitor_schematic.py, gen_cathode_monitor_schematic_pdf.py]
2026-06-11 grid_bias: add CT_FAULT_OR port + Q_SLAM bias-slam path
    Extends grid_bias.sch from 2-port to 3-port subcircuit by adding:
    - New Port CT_FAULT_OR (active-HIGH fault input)
    - Q_SLAM: 2N7000 N-MOSFET with drain on the OPA454 (+) input node
    (between R_pad and OPA454 pin 1), source to GND
    - R_GATE = 10 kohm between CT_FAULT_OR port and Q_SLAM gate
    Fault response:
    - Normal: CT_FAULT_OR at 0V -> Q_SLAM OFF -> (+) input rides V_DAC ->
    OPA454 produces V_out = V_DAC * 18 - 85 (normal bias)
    - Fault: CT_FAULT_OR at +5V -> Q_SLAM ON -> (+) input shorted to GND
    through R_DS(on) -> OPA454 produces V_out ~ -85V -> tube cut off
    Bias-slam latency: comparator trip + MOSFET turn-on + OPA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
    [grid_bias.sch, grid_bias_check.sch]
2026-06-12 tools: per-sheet BOM generator + initial Parts_List.xlsx
    tools/gen_parts_list_xlsx.py
    Parses every QUCS-S schematic in xmitter_prj/ (R, C, L, L_SPICE,
    K_SPICE, INDQ, JFET, _BJT, _MOSFET, Vdc, Vac, SpLib, Sub) and
    produces a multi-sheet Excel workbook -- one tab per schematic --
    via openpyxl. Per-component metadata pulled from the design docs:
    - Resistors: type (metal-film, carbon-comp, wirewound, metal-oxide)
    and wattage based on power dissipation analysis
    - Capacitors: type (silver mica, C0G/NP0, X7R, film, electrolytic)
    and voltage rating based on operating point
    - Inductors: core (T68-6, T50-6, T106-2, FT82-43, FT37-43 etc.)
    with turns count, wire gau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
    [Parts_List.xlsx]
2026-06-12 docs: resistor + capacitor sourcing spreadsheets
    Documentation/Resistor_Sourcing.xlsx (NEW)
    5-sheet shopping reference for the resistor population. Sheets:
    Strategy / Kit Coverage / DigiKey Metal Film / DigiKey Specialty /
    Resistor Inventory.
    Three-tier sourcing: 1280-pc Amazon kit ($15-25, covers ~75 % of
    positions) + 5 specific Yageo MFR-25 values from DigiKey for the
    impedance/gain-set positions the kit misses (51, 62, 200, 240, 170k)
    + carbon comp / wirewound / metal oxide for tube positions where
    metal film isn't right.
    Documentation/Capacitor_Sourcing.xlsx (NEW)
    7-sheet shopping reference for the capacitor population. Sheets:
    Strategy / Silver Mica HV / Ceram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
    [Capacitor_Sourcing.xlsx, Resistor_Sourcing.xlsx]
2026-06-12 docs: ESP-IDF setup walkthrough for fresh Windows dev machine
    Documentation/ESP-IDF_Setup_Windows.md (NEW)
    End-to-end install guide for the firmware development environment on
    a fresh Windows machine. Covers:
    Pre-flight: Windows Update + disk space
    Step 1: Git for Windows + clone xmitter repo
    Step 2: Python 3.11 + project tooling deps (openpyxl, reportlab,
    matplotlib, numpy)
    Step 3: VS Code
    Step 4: Claude Code (optional)
    Step 5: ESP-IDF Extension for VS Code with Express install of
    ESP-IDF v5.4 + xtensa-esp32s3 toolchain + OpenOCD + Python
    venv
    Step 6: Blink example verification on Metro ESP32-S3 over UART
    Step 7: xmitte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
2026-06-12 .claude: commit shared settings.json; gitignore settings.local.json
    .claude/settings.json (NEW, committed)
    Project-wide Claude Code permission rules. Tools allowed without
    prompting (Bash, Read, Write, Edit, Glob, Grep, PowerShell, the
    update-config skill, git add, Adafruit web fetches). Tools that
    should prompt before acting (git push, git commit, schematic edits).
    Cleaned of any machine-specific paths so it's portable across the
    main machine and the dev machine.
    .gitignore
    Added .claude/settings.local.json so per-machine personal overrides
    stay local (Claude Code convention).
    Before this commit, the project's permission setup lived only in the
    gitignored settings.local.js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
2026-06-12 CLAUDE.md: project-level instructions; interactive dev-machine setup
    CLAUDE.md (NEW, project root)
    Project context that loads in every Claude Code session for this repo.
    Three main sections:
    - Directory map (xmitter_prj, KiCAD, Documentation, tools, firmware-TBD)
    - Dev-machine onboarding directive: when the user opens Claude Code on
    a fresh dev machine (signals: "dev machine", "new machine", "setting
    up", "fresh install", "fresh clone"), walk them through
    Documentation/ESP-IDF_Setup_Windows.md INTERACTIVELY -- one step at
    a time, verify each step before moving on, troubleshoot in real
    time. Don't dump the whole walkthrough.
    - Stable design references: cw_enve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
2026-06-12 checkpoint: commit remaining untracked files before dev-machine move
    Capturing the last few files that had been sitting untracked so nothing
    is left behind on the main machine before development moves to the
    ESP-IDF dev machine.
    Documentation/parts_inventory.xlsx
    User-maintained inventory tracking spreadsheet (working document
    alongside the generated Parts_List.xlsx).
    xmitter_prj/spice4qucs.dc1.ngspice.dc.print
    QUCS-S print-style ngspice output (not matched by existing
    spice4qucs.*.plot gitignore rule). Small file, committing once
    as snapshot; will be regenerated each run.
    xmitter_prj/test.sch, test2.sch
    Long-running scratch schematics from MC1496/keyer explo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
    [parts_inventory.xlsx, test.sch, test2.sch, vfo_buffer_subcircuit.sch]
2026-06-13 docs: rewrite ESP-IDF setup walkthrough as concise reference
    After completing the EIM-based install on both the primary dev and
    secondary hardware-interface machines, replace the old 366-line
    walkthrough with a 126-line reference doc capturing what actually
    worked.
    Key corrections to the old doc:
    - Python 3.12 is supported (old doc said NOT 3.12). 3.11 still works.
    - "ESP-IDF: Configure ESP-IDF Extension" command no longer exists in
    extension v2.1.0+. Replaced by the EIM (ESP-IDF Installation
    Manager) flow.
    - Document the "Activate Anyway" gotcha for non-IDF workspaces.
    - Document the "Select current ESP-IDF version" wire-up step that the
    extension does not perform autom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
2026-06-13 CLAUDE.md: reflect ESP-IDF v5.4.4 installed on both machines
    Update project instructions now that the firmware toolchain is in place:
    - Header: ESP-IDF v5.4.4 installed and verified on both dev machines
    (2026-06-12), ready to scaffold firmware/
    - firmware/ directory description: "not yet scaffolded -- first task
    this phase" rather than "coming next"
    - Replace the "first time setup of THIS machine" directive with a
    "future fresh machine" directive -- both current machines are done,
    but the setup walkthrough remains useful if user ever replaces or
    adds a dev box
    - Add a short "Firmware scaffolding (current focus)" section pointing
    at the files to create per cw_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
2026-06-14 firmware: scaffold ESP-IDF v5.4 project for ESP32-S3
    Top-level CMakeLists, sdkconfig.defaults (USB-Serial-JTAG console,
    dual-core, WDT), and main/ component. Builds clean for esp32s3.
    Modules:
    - vfo_si5351 — Si5351A driver on the new i2c_master API; CLK0 only,
    even-integer multisynth in [600,900] MHz VCO band with fractional
    PLLA feedback (max-resolution c=2^20-1). 14.2 MHz default.
    - keyer_envelope — port of Arduino_code/cw_envelope_keyer.cpp to
    esp_driver_spi + native FreeRTOS, pinned to core 1. Preserves the
    documented design (single chasing phase, busy-wait task, dedicated
    SPI bus, predistortion hook).
    - console_shell — esp_console REPL on USB CDC: vfo, status, psu, help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
2026-06-14 firmware + docs: real Metro pinout, encoders, build checklist, BOM expansion
    Firmware:
    - pin_map.h filled in from the Adafruit Metro ESP32-S3 PrettyPins diagram
    (I2C 47/48, DAC SPI on D11/D12/D13, encoders on D2/D3/D5-D10). Noted
    that the MBL-600-100P-5L optical encoder is +5V differential line-driver
    output (AM26LS31), NOT 3.3 V CMOS — requires an RS-422 receiver or LVC
    level shifter before the GPIOs.
    - encoders.{h,cpp}: PCNT-based quadrature decoder for FREQ + STEP + FUNC
    encoders, polling task on core 0. Single constexpr step table
    {1,5,10,20,50,100,500,1000} Hz, easy to edit. Clamps VFO to 14.0-14.35
    MHz at the band edges.
    - front_panel.cpp wired through to encoders + cla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
    [BOM.xlsx]
2026-06-14 mains interlock + tools/idf_shell.ps1 dev-env helper
    Hardware safety: add a watchdog-driven AC mains relay (K_MAIN) that
    energises only while the MCU actively heartbeats a GPIO at >=5 Hz.
    A 74HC4538 retriggerable monostable (R=100k, C=2.2uF, ~220 ms hold)
    extends each pulse; firmware hang / panic / brown-out -> no more
    pulses -> relay drops -> AC removed from HV/bias/screen/filament
    transformers within ~200 ms. External 10k pull-down on the GPIO trace
    guarantees relay OFF before the MCU is powered. Independent layer
    from the screen-voltage watchdog gate (fast, <100 us, for cathode
    overcurrent) and from firmware fault::assert_fault().
    - pin_map.h: MAINS_HEARTBEAT reserved on GPIO 4 (Arduino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
    [BOM.xlsx]
2026-06-16 docs: reorganize into per-stage docs; add legacy/ and Components/ subdirs
    Major documentation cleanup. Documentation/ root now contains only
    current per-stage docs; superseded design notes are in legacy/, and
    component datasheets are in Components/.
    New per-stage docs (each self-contained for the current design,
    using UTF-8 box-drawing tables for clean less-rendered output):
    - vfo_input_stage.md (Si5351 + pi pad + 7-pole LPF + J310 buffer)
    - driver_stage.md (12HG7 push-pull + T68-6 output transformer)
    - PA_stage.md (6146B push-pull + air-core plate tank)
    - balun_stage.md (FT82-43 6:1 step-down, 5+2 turns)
    - LPF_stage.md (5-pole Chebyshev 50 ohm output filter)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
2026-06-17 qucs cleanup: legacy/ subdir + extract MC1496 carrier-null idea
    Mirrors the prior Documentation/legacy/ reorg. Unused/superseded
    QUCS subcircuits and the older MC1496 hardware notes moved into
    xmitter_prj/legacy/ to keep the active QUCS-S workspace listing
    free of stale schematics. (QUCS-S 26.1.1 doesn't scan subdirs,
    so the legacy/ folder is invisible to it.)
    Moved to xmitter_prj/legacy/:
    - ATU_subcircuit.sch (early stub, not in current chain)
    - test.sch, test2.sch (scratch test benches)
    - vfo_buffer_subcircuit.sch (old MC1496 standalone-buffer topology)
    - Driver_tank_subcircuit.sch (old tuned-input driver topology)
    - Digital_subcircuit.sch (empty placeholder)
    - LPF_subcircuit.sch (old dif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
    [ATU_subcircuit.sch, Digital_subcircuit.sch, Driver_tank_subcircuit.sch, LPF_subcircuit.sch, test.sch, test2.sch, vfo_buffer_subcircuit.sch]
2026-06-17 docs: convert all current docs to UTF-8 box-drawing tables
    Replaces markdown table syntax with box-drawing characters across
    every current doc in Documentation/. Markdown tables render with
    broken column alignment in less and PDF export; box-drawing tables
    render with proper alignment in less (the user's primary reader)
    and stay aligned in any monospace context.
    Converted docs:
    - jfet_library_readme.md (4 tables)
    - ESP-IDF_Setup_Windows.md (3 tables)
    - cw_envelope_keyer.md (6 tables: 3 unindented + 3 indented)
    - pa_cathode_monitor.md (9 tables)
    - 2026-06-08-pa-validation.md (13 tables)
    Per-stage docs (vfo_input_stage, driver_stage, PA_stage,
    balun_stage, LPF_stage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
2026-06-17 kicad vfo: Si5351 hookup + custom footprint + bulk footprint assign
    vfo.kicad_sch — circuit changes (user-authored):
    - Pi pad restored to current 62/240/62 Ω (was OLD 150/39/150)
    - Added Si5351A breakout custom symbol (U1)
    - Added 10 nF coupling cap (C_coup) + 0 Ω damping resistor (RS) between
    Si5351 CLK0 and pi pad — blocks the chip's 1.65 V DC offset that would
    otherwise overload the 8 mA output into RP1's 62 Ω shunt
    - LPF inductors at the new T68-6 uniform 736 nH spec
    vfo_input_stage.md — LPF cap retention clarified:
    Caps stay at the original 220/390/390/220 (E12 silver mica) when using
    T68-6 inductors. Documents the resulting filter shape change (cutoff
    shifts 17.5 → 16.4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
    [vfo.kicad_sch]
2026-06-17 docs: VFO+keyer order spreadsheet + 3-gauge wire plan + start construction notes
    VFO_Keyer_Order.xlsx (new): purpose-built sourcing list for the VFO and
    keyer bring-up - 72 line items covering Si5351 hookup hardware, pi pad,
    7-pole LPF, J310 buffer, MC1496 + bias network, PNP null pairs, LM7171
    post-amps, MCP4921 envelope DAC, per-IC supply bypass, power input
    terminal block, and the -8.3V derivation from -90V. Check-off columns
    for On Hand / Ordered / Received, auto-totaled cost, color-coded
    sections, Mouser P/Ns where known.
    tools/gen_vfo_keyer_order.py (new): regeneration script using openpyxl.
    control_board_BOM_and_wire_plan.md: magnet wire plan revised to three
    gauges driven by stage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
    [Parts_List.xlsx, VFO_Keyer_Order.xlsx]
2026-06-17 docs: VFO+keyer order — add Digi-Key P/N column alongside Mouser
    VFO_Keyer_Order.xlsx and tools/gen_vfo_keyer_order.py: added a
    Digi-Key P/N column next to the existing Mouser P/N column so the
    sheet can be used to fill either supplier's cart depending on stock
    availability. Renamed "Supplier" to "Ordered From" — fill in after
    the PO to track which vendor actually shipped.
    Populated Digi-Key P/Ns where reliably known (active devices, IC
    sockets, headers, silver mica caps, X7R / tantalum bypass, BNC,
    zener, film cap, paddle/standoff hardware). Left blank for Yageo
    MFR-25 axial resistors (DK catalog number varies per value — easier
    to search by spec) and KitsAndParts-only items (toroids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
    [VFO_Keyer_Order.xlsx]
2026-06-18 docs: VFO+keyer order — add Mfr P/N column, consolidate by component, mark on-hand and ordered status
    Sequence of changes to VFO_Keyer_Order.xlsx and the supporting tools:
    1. Add Mfr P/N column (manufacturer part numbers populated only where
    unambiguous: MC1496P, LM7171AIN/NOPB, MCP4921-E/P, J310, 2N3906,
    1N4738A, CD15FD221JO3F / CD15FD391JO3F, Kemet T350F106K025AT, Wima
    MKP4 680 nF, Mill-Max sockets, Adafruit 5566). Earlier distributor-
    specific catalog numbers were largely guesses and not reliably
    searchable; manufacturer P/N is universal across Mouser and Digi-Key.
    2. Consolidate by component: groups rows with identical Value+Package
    into one line, summing Qty and co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
    [VFO_Keyer_Order.xlsx]
2026-06-19 kicad: control-board sheets — buffer_keyer keyer body, arduino SPI labels, custom-symbol plan
    - buffer_keyer.kicad_sch: place MC1496 keyer support components
    (carrier divider R11/R12, modulator port R3, emitter-degen Re,
    modulator coupling C1, VEE bypass C5, R2 Iee, bypass network),
    MCP4921 envelope DAC U4 with reconstruction cap C3, terminal
    blocks J1/J2/J3 for +5V/+12V/-90V/VEE input, hierarchical labels
    for VFO_OUT, SCK, MOSI, CS_DAC.
    - arduino.kicad_sch: add SCK and MOSI hierarchical outputs for SPI
    link to MCP4921. CS_DAC still TODO.
    - vfo.kicad_sch + KiCAD.kicad_sch: minor edits, sheet pin updates.
    - Documentation/kicad_custom_symbols.md: new doc — pattern and plan
    fo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
    [KiCAD.kicad_sch, VFO_Keyer_Order.xlsx, arduino.kicad_sch, buffer_keyer.kicad_sch, keyer.sch, vfo.kicad_sch]
2026-06-19 kicad: redesign Metro_ESP32S3 as wide 25-pin xmitter symbol + wire arduino sheet
    - xmitter.kicad_sym: replace Metro_ESP32S3 with a 25-pin compact symbol
    (was 34-pin stock with cluttered alt-function labels). Body 25.4 x
    34.3 mm. 19 active pins (power, control, UART, I2C, SPI, paddle,
    TX_LED) + 6 analog spares (A0-A5) for future expansion.
    - arduino.kicad_sch: cached lib_symbols mirrors the new definition; wire
    Metro pins to hierarchical labels (SDA, SCL, SCK, MOSI, CS_DAC, 3V3)
    and to GND/+5V power ports. CS_DAC label added for SPI chip select.
    - buffer_keyer.kicad_sch: keyer body wiring progress (22 wires).
    - tools/rewrite_metro_symbol.py: idempotent symbol generator. Pin list
    i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
    [arduino.kicad_sch, buffer_keyer.kicad_sch]
2026-06-19 kicad + docs: add MCP4728 (null DAC) symbol, document I2C address-conflict resolution and PCB-trace routing decision
    Hardware change: Adafruit MCP4728 4-channel I2C DAC (PID 4470) on hand,
    intended for the dual-channel digital carrier-null feature previously
    labeled "designed but not built" in cw_envelope_keyer.md.
    - xmitter.kicad_sym: new xmitter:MCP4728 symbol — 10 pins matching the
    Adafruit breakout's 0.1" header (VIN, GND, SCL, SDA, LDAC, RDY, VA-VD).
    Built via tools/add_mcp4728_symbol.py (declarative pin list, same
    pattern as the Metro symbol generator).
    - cw_envelope_keyer.md: "Future enhancement" -> "Next-phase enhancement"
    (hardware on hand). Adds the I2C address-collision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
    [VFO_Keyer_Order.xlsx, buffer_keyer.kicad_sch]
2026-06-20 docs(keyer): correct null-injection topology to match QUCS sim and MC1496 app note
    The "Future enhancement: DAC-driven digital carrier null" section of
    cw_envelope_keyer.md described "330 kohm direct injection at MC1496
    pins 1/4 (SIG_P, SIG_N)". That description was wrong on two counts:
    1. It contradicts what xmitter_prj/keyer.sch actually simulates. In the
    QUCS schematic, the DAC1/DAC2 ports tie DIRECTLY to T1/T2 PNP bases
    (with V8 = 1.65 V as the static null-test bias). The DACs were never
    wired to MC1496 pins 1/4.
    2. It would violate the MC1496 application note (AN531 page 5): "Good
    carrier suppression over a wide temperature range requires low dc
    resistances between the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
    [arduino.kicad_sch, buffer_keyer.kicad_sch]
2026-06-20 kicad(buffer_keyer): MCP4728 re-placed correctly + MCP4921 VREF RC filter + LM7171 bypass note
    - U5 -> U8 MCP4728 deleted and re-placed (no mirror this time); all 10
    pins now wired to the correct nets: VIN/+3.3V, GND, SCL/SDA hier
    labels, LDAC/LDAC_4728, RDY/VC/VD with no-connect flags, VA -> R_INJ2
    -> T2.base, VB -> R_INJ1 -> T1.base. Net tracer confirms.
    - MCP4921 VREF: added R16 (10R series) + C14 (1uF to GND) RC filter on
    pin 6 to reject +5V supply noise from translating directly into DAC
    output (VREF is the multiplier on the DAC code).
    - MCP4921 VDD: added C13 bulk bypass alongside existing Cx1 (100nF) for
    better LF / transient rejection at the chip. NOTE: C13 value field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
    [buffer_keyer.kicad_sch]
2026-06-20 kicad + qucs: set MCP4921 C13 bulk bypass to 1uF; QUCS keyer.sch edit
    - buffer_keyer.kicad_sch: C13 value set to 1uF (placeholder was the
    symbol library name "C_Polarized"). 1uF + 100nF (Cx1) bypass at
    MCP4921 VDD — sufficient for the chip's ~0.5 mA current draw.
    - xmitter_prj/keyer.sch: QUCS simulation schematic edit.
    [buffer_keyer.kicad_sch, keyer.sch]
2026-06-21 kicad: rename VFO_OUT signals to direction-named labels (RAW_RF_*, MOD_RF_*)
    The 14 MHz unmodulated signal between VFO and buffer_keyer was
    labeled "VFO_OUT" on BOTH sheets, which was directionally ambiguous.
    The differential post-modulation outputs of the LM7171 stage were
    also labeled "VFO_OUT+/-", which was wrong — by that point in the
    chain the signal is keyed/modulated, not raw VFO.
    Renames:
    - vfo.kicad_sch: hier label VFO_OUT (output) -> RAW_RF_OUT
    - buffer_keyer.kicad_sch: hier label VFO_OUT (input) -> RAW_RF_IN
    - buffer_keyer.kicad_sch: VFO_OUT+ (output) -> MOD_RF_OUT+
    - buffer_keyer.kicad_sch: VFO_OUT- (output) -> MOD_RF_OUT- (also fixed
    a typo where the minus side was mistaken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
    [KiCAD.kicad_sch, buffer_keyer.kicad_sch, vfo.kicad_sch]
2026-06-21 kicad: re-architect I2C bus distribution via STEMMA QT to Si5351 hub
    Move I2C (SDA/SCL) and +3.3V distribution from arduino-sheet-origin to
    vfo-sheet-origin, matching the physical plan: STEMMA QT cable carries
    I2C + 3.3V from Metro to Si5351 breakout (off-schematic), and from the
    Si5351 breakout's 0.1" header the bus is distributed via PCB traces to
    other I2C devices (MCP4728, future MCP23017 for LCD).
    Per-file changes:
    - xmitter.kicad_sym (Metro_ESP32S3 symbol): D2/D3 relabeled from
    D2/SDA, D3/SCL to D2/FREQ_A, D3/FREQ_B (input type). Aligns with
    firmware/main/pin_map.h which already uses D2/D3 for the FREQ encoder
    quadrature inputs. The real Metro's dedicated SDA/SCL pins (GPIO
    4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
    [arduino.kicad_sch, buffer_keyer.kicad_sch, vfo.kicad_sch]
2026-06-23 kicad(bias): build complete grid-bias sheet (Design A: dual OPA454)
    New sheet untitled.kicad_sch (sheet name "Bias", file to be renamed
    bias.kicad_sch) implementing the OPA454 high-voltage design per the
    Grid_Bias_Schematic.pdf design doc:
    - LM7805 (U9) generates the +5 V supply rail from +12 V (~30 mA load,
    no heatsink needed at ~270 mW dissipation)
    - LM4040DIZ-5.0 (U11) generates a SEPARATE +5 V_REF precision reference
    biased from +12 V via R_Z = 2.2 kΩ; cathode bypassed by C23 (100 nF).
    Drives only R_GA / R_GB (the two OPA454 summing-junction inputs) and
    the cathode-monitor's 1.5 V threshold divider on its own sheet
    - Two OPA454 channels (U5 = Tube A, U10 = Tube B) each with R_F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
    [KiCAD.kicad_sch, arduino.kicad_sch, buffer_keyer.kicad_sch, grid_bias.sch, untitled.kicad_sch, vfo.kicad_sch]
2026-06-23 kicad(bias): rename untitled.kicad_sch -> bias.kicad_sch
    - git mv KiCAD/untitled.kicad_sch -> KiCAD/bias.kicad_sch
    - Update KiCAD/KiCAD.kicad_sch root: Sheetfile property -> bias.kicad_sch
    - Update Documentation/grid_bias.md: path reference + check off the
    rename open-item
    [KiCAD.kicad_sch, bias.kicad_sch]
2026-06-23 kicad(bias): swap C17/C18 from Device:C_Polarized to Device:C
    1 uF X7R ceramic is non-polarized in production. The polarized symbol
    was an assembly-orientation hazard for a part that doesn't actually
    have polarity. Pin numbers and connections unchanged.
    - lib_id Device:C_Polarized -> Device:C on both caps
    - Description property "Polarized capacitor" -> "Unpolarized capacitor"
    - grid_bias.md: update note and check off the open-item
    [bias.kicad_sch]
2026-06-23 kicad: assign 1/4 W metal-film through-hole footprint to all resistors
    Footprint: Resistor_THT:R_Axial_DIN0207_L6.3mm_D2.5mm_P10.16mm_Horizontal
    DIN 0207 is the standard 1/4 W metal-film body size (Vishay MRS25, Yageo
    MFR-25, etc., 6.3 mm x 2.5 mm). The relaxed P10.16mm pitch (vs the snug
    P7.62mm) gives extra lead-bend room for hand soldering.
    - bias.kicad_sch: 10 resistors (R_FA, R_FB, R_GA, R_GB, R_GATE, R_GLA,
    R_GLB, R_PADA, R_PADB, R_Z)
    - buffer_keyer.kicad_sch: 25 resistors (R1-R16, RF_OP, RF_OP1, RG_OP,
    RG_OP1, RLA, RLB, R_INJ1, R_INJ2, Re)
    All values fit comfortably in the DIN 0207 body, including the three
    51-ohm MC1496 emitter resistors (1 % metal film for carrier-null
    precis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
    [bias.kicad_sch, buffer_keyer.kicad_sch]
2026-06-23 metro+docs: expose ADC1/ADC2 capability in Metro pin labels; lock ADC decision
    Updates the xmitter:Metro_ESP32S3 symbol pin labels to surface the
    ADC channel grouping per the Adafruit Metro ESP32-S3 doc (page 17):
    ADC1: A5, D2-D10 (10 channels)
    ADC2: A0-A4, D11-D13 (8 channels; unreliable when WiFi is active)
    Spare pins now self-document which ADC they belong to so any future
    analog wiring can pick from ADC1 without cross-referencing the
    datasheet:
    Left: D7/ADC1, D8/ADC1, D9/ADC1
    Right: D12/ADC2, A0/ADC2, A1/ADC2, A2/ADC2, A3/ADC2, A4/ADC2,
    A5/ADC1
    Pins already committed to a function keep their existing label
    (D2/FREQ_A, D3/FREQ_B, D4/DIT, D5/DAH, D6/TX_LED, D10/CS_DAC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
    [arduino.kicad_sch]
2026-06-23 kicad: add system footprint libraries to project fp-lib-table
    After the last commit added Resistor_THT footprint paths to all
    the 1/4 W resistors on bias.kicad_sch and buffer_keyer.kicad_sch,
    KiCad re-saved buffer_keyer.kicad_sch with all 25 of those footprint
    references stripped back to empty strings. Probable cause: the
    project fp-lib-table only declared the local xmitter library, so
    KiCad couldn't validate the Resistor_THT:... references at project
    load time and dropped them on save.
    Fix: explicitly register the system footprint libraries the project
    actively uses (or will soon use) in the project-local fp-lib-table.
    Footprint references should now resolve at load and survive save.
    Libr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
2026-06-23 docs(cathode): add binding layout rules for F1+R_S, fan, shielded cable
    Captures three decisions made before starting the cathode-monitor
    schematic build:
    - F1+R_S pairing is mandatory (in F1->R_S order). Splitting them
    across the sense cable creates a fault-mode failure where the
    cable carries full plate voltage (~600 V) when F1 opens. Both stay
    at the tube socket, only the post-R_S sense signal goes to the PCB.
    - F1 thermal mitigation: chassis muffin fan over the 6146 socket
    area is required to keep F1 (60 C ambient rated) within spec
    during sustained CW. Socket-area temperature isn't measurable once
    HV is live, so design for cooling rather than tuning later.
    - Sense cable i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
2026-06-24 docs+kicad+qucs: lock in cathode-monitor diode-OR design
    KiCad bias sheet: fill in placeholder R values for the cathode-monitor
    section -- R18=10K (threshold divider bottom), R20=R22=7.5K (R_SOURCE,
    one per channel), R21=R23=470K (R_HYST, one per channel). All cathode-
    monitor resistors now match the QUCS test bench values.
    QUCS grid_bias_check.sch: rebuild test bench with LM393-equivalent
    behavioral comparator (gain 1e4 to avoid the 1e6 convergence trap),
    R_HYST=470K, R_SOURCE=7.5K, sweep input V2 against threshold V3=1.0V.
    Sweep crosses the trip point cleanly with the lower gain.
    pa_cathode_monitor.md: lock in the diode-OR combiner topology (no
    inverter) chosen this session. Corrects the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
    [arduino.kicad_sch, bias.kicad_sch, grid_bias_check.sch]
2026-06-24 kicad+pdf+tools: diode-OR build-out, cap footprints, regen monitor PDF
    KiCad bias sheet: complete the cathode-monitor diode-OR combiner
    - D5, D6 = 1N4148 (diode-OR anodes at each LM393 OC output)
    - R24 = 100 kOhm (R_PD pulldown at common GRID_BLOCK_CRASH node)
    - R25 = 4.7 kOhm (second R_PULL so each LM393 OC has its own
    pull-up to +3.3 V, satisfying the diode-OR topology)
    - Closes the "remaining bias-sheet work" item from the cathode-
    monitor spec's open list.
    KiCad arduino sheet: add I_CATHODE_A and I_CATHODE_B hierarchical
    inputs so the ADC1 path from the bias sheet has a landing point on
    the Metro side.
    Tools: add assign_cap_footprints.py, a re-runnable script that walks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
    [arduino.kicad_sch, bias.kicad_sch, buffer_keyer.kicad_sch]
2026-06-24 tools+kicad: extend cap-footprint map with user-stock disc values
    Added 390 pF, 330 pF, 33 pF to assign_cap_footprints.py with
    diameter taken from the user's measurement (1/4" body for 390/330 pF,
    3/16" for 33 pF) on P5.08 mm pitch.
    Re-ran the script:
    buffer_keyer.kicad_sch: C1=330pF -> C_Disc_D6.0mm_W2.5mm_P5.00mm
    vfo.kicad_sch CF3/CF5 (390pF) already had footprints assigned
    manually; left alone (script never overwrites).
    Still needing footprints (1uF, 0.22uF, 1nF) -- yet to be ordered:
    bias: C17/C18 1uF, C21 0.22uF, C28/C29 1nF
    buffer_keyer: C13/C14/C15 1uF
    [buffer_keyer.kicad_sch]
2026-06-24 caps: complete footprint coverage on active sheets + add datasheets
    Pending Mouser cart 2026-06-24 (1:31 PM) adds two more KEMET parts
    that close the remaining cap gaps:
    KEMET C317C334K3R5TA 0.33 uF X7R 25V LS=5.08mm (qty 4)
    KEMET C327C102J3G5TA 1000 pF C0G 25V LS=5.08mm (qty 5)
    Updated VALUE_TO_FOOTPRINT and re-ran the script:
    bias: C21 0.33uF -> C_Rect_L7.0mm_W3.5mm_P5.00mm
    bias: C28/C29 1nF -> C_Rect_L7.0mm_W3.5mm_P5.00mm
    Every capacitor across the active sheets (bias, buffer_keyer, vfo,
    arduino) now has a footprint assigned. The 100pF (AVX AR21) mapping
    remains for future PA tank / LPF use; no current schematic instance.
    Also: Documentation/Components/ added for trace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
    [bias.kicad_sch, buffer_keyer.kicad_sch]
2026-06-24 kicad/bias: footprint cleanup -- D2/D4 +3.3V bulk + remaining cathode-monitor parts
    User added two ECA-1EM100 10uF electrolytics for the D2/D4 fault-energy
    absorption requirement, plus all the cathode-monitor section parts were
    still missing footprints from when they were added.
    Footprints assigned:
    C32, C33 -- 10uF (ECA-1EM100) -> CP_Radial_D5.0mm_P2.00mm
    (auto-assigned by assign_cap_footprints.py)
    R17-R25 -- 9x 1/4W metal-film -> R_Axial_DIN0207_L6.3mm_D2.5mm_P10.16mm_Horizontal
    RV1 -- 10K 25-turn cermet -> Potentiometer_Bourns_3296W_Vertical
    U12 -- LM393 dual comparator -> DIP-8_W7.62mm (Mill-Max 8P socket)
    U13, U14 -- OPA1641 -> DIP-8_W7.62mm (SOIC-to-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
    [bias.kicad_sch]
2026-06-24 docs: bring .md files current with hardware design state
    Sweep through the design docs to reflect the analog-board schematic as
    of 2026-06-24 (post diode-OR build-out + D2/D4 +3.3V bulk + full
    footprint coverage).
    CLAUDE.md
    - "Current focus" updated: analog-board schematic complete; next is
    PCB layout + firmware scaffold
    - Source-of-truth design-doc list updated (grid_bias.md added; stale
    Grid_Bias_Schematic.pdf reference removed)
    - Tooling commands: assign_cap_footprints.py added
    Documentation/grid_bias.md
    - C21 value corrected 0.22 uF -> 0.33 uF (user changed on schematic)
    - CT_FAULT -> GRID_BLOCK_CRASH (actual net name) with conceptual
    cross-reference preserved for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
2026-07-02 interface: RJ45 umbilical sheet + RJE1D-188 footprint + open-items doc
    Add KiCAD/interface.kicad_sch (page 10 of root) with SDA/SCL bidirectional
    hierarchical labels, MBL_A/B differential outputs, and R100/R101 120-ohm
    RS-422 terminators. Draft custom footprint Amphenol_RJE1D-188_Horizontal_Shielded
    in xmitter.pretty -- signal pin array (P1-P8) is exact from datasheet;
    shield-post, alignment-peg, and shield-tail hole coordinates are best-guess
    and flagged for pre-fab verification.
    Documentation/front_panel_interface.md is the single source of truth for
    this subsystem: T568B pin map, single-point-ground rule, RS-422 termination
    at the receiver end, plus an "Open items" checklist covering foo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
    [KiCAD.kicad_sch, bias.kicad_sch, interface.kicad_sch]
2026-07-03 front-panel: QT encoder swap, PCF8575 breakout, pre-fab checklist, INT-none decision
    Switch STEP + FUNC from direct PCF8575 GPIO to Adafruit I2C QT Rotary
    Encoder breakouts (PID 4991) at addr 0x36 / 0x37. The onboard seesaw
    SAMD09 handles quadrature decoding + button debounce, dropping ~200
    lines of firmware. PCF8575 still covers the LCD (4-bit), paddle, and
    panel LEDs.
    Add custom KiCad symbols + footprints for both new breakouts to
    xmitter.kicad_sym and xmitter.pretty. Footprint properties on the new
    symbols are pre-linked, so schematic instances auto-associate. Some
    coordinates in both footprints are best-guess pending physical
    measurement -- flagged in the descr fields and in the new
    fro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
    [KiCAD.kicad_sch, arduino.kicad_sch, bias.kicad_sch, buffer_keyer.kicad_sch, front_panel.kicad_sch, vfo.kicad_sch]
2026-07-03 arduino: reserve D4 for future ENC_INT + AM26LS32A datasheet
    Add hardware provisions to arduino.kicad_sch for a possible future
    front-panel interrupt cable, without committing to actually running one
    on this build:
    - Metro D4 (was D4/DIT; free since paddle moved to PCF8575) reserved
    as ENC_INT input
    - R102 = 10 kOhm pull-up from D4 to +3.3V so the pin idles high with
    no cable connected
    - J50 = 2-pin 0.1" header (ENC_INT_CABLE), footprint
    PinHeader_1x02_P2.54mm_Vertical. Leave unpopulated on first build
    - Plain "ENC_INT" net label + text note explaining the reservation
    If we ever want the INT cable later, it's a solder-in-a-header + run
    a-cable operation with no PCB respin. Firmware s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
    [arduino.kicad_sch]
2026-07-04 interface+arduino: wire the MBL-600 signal chain end-to-end
    Interface sheet — receiver + termination + level-shift, all live:
    - RJ45 J1 (shielded 8P8C, Connector library symbol) instantiated with
    hierarchical labels on all eight positions per T568B; RJ45 pins
    3/6/7/8 land on MBL_A_P/N and MBL_B_P/N at the receiver-input side
    - R100 = R101 = 120 Ohm across the differential pairs (RS-422
    termination at the receiver end)
    - AM26LS32ACN (U15) at (119.38, 104.14); ch 1 handles MBL_A±, ch 2
    handles MBL_B±
    - Both enable pins tied to GND. ~G at pin 4 is the active-LOW
    enable, so GND puts it in its active state and turns on all four
    receivers per the datasheet's OR-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
    [arduino.kicad_sch, interface.kicad_sch]
2026-07-04 kicad: SameSky RCJ-02 RCA jack footprint + link to J5 on arduino sheet
    New custom footprint at xmitter.pretty/SameSky_RCJ-02_RCA_Jack.kicad_mod
    matching the datasheet page-2 PCB layout: one 1.70 mm signal hole at
    origin (pad 1 = center pin), two 2.00 mm mounting-foot holes at
    (+/-5.15, +1.60) mm sharing pad number 2 (both mounting feet connect
    to the shield/GND net). Silkscreen and fab layers show the connector
    body outline plus a barrel circle indicating the opening direction
    (faces -Y).
    Assigned to J5 on arduino.kicad_sch -- the Conn_Coaxial symbol the user
    placed for the future front-panel INT cable landing. Pin-number
    convention matches (Conn_Coaxial pin 1 = center/signal, pin 2 = shiel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
    [arduino.kicad_sch]
2026-07-05 docs: end-of-phase design review 2026-07-05
    Captures the conceptual review at the close of the analog-board schematic
    phase. Structure:
    - Three real concerns worth resolving before PCB fab: MCP4728 EEPROM-
    reprogram single-point-of-failure for VFO access; K_MAIN mains-
    interlock relay not schematically represented; +12V rail source on
    the analog board still ambiguous.
    - Correctly deferred items (Phase 3-5 sheets, front panel population,
    paddle inputs, etc.) called out so future-me doesn't mistake them
    for oversights.
    - Confirmed-conceptually-sound list for the record: 7-layer cathode
    failsafe, DPDT T/R relay + TR_SENSE topology, RS-422 receiver +
    voltage-divider math, I2C addr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
2026-07-05 arduino: main-board PCF8575 at 0x21 + relay drivers + TR_SENSE
    Adds the second PCF8575 breakout (U17) on the main board at I2C address
    0x21 (A0 jumper closed), giving 16 GPIO for relay drivers and other
    non-time-critical control outputs. Wired to the shared I2C bus via
    SDA/SCL hierarchical labels at U17's I2C pins. Bypass caps C36 (100 nF)
    and C37 (10 uF) local to the PCF8575.
    Two 2N7000 low-side relay drivers Q4, Q5 with 2-pin connectors J6 and
    J7 for off-PCB relays:
    - J6: Transmit/Receive relay coil (main T/R switching, DPDT --
    second pole provides TR_SENSE confirmation)
    - J7: High Voltage Primary Relay coil (gates the HV supply)
    - Each relay coil requires a 1N4001 flyback diode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
    [arduino.kicad_sch]
2026-07-06 kicad: fill missing footprints across active sheets + MCP4728 breakout footprint
    Footprint sweep across the analog control board sheets. All active sheets
    now clean except U2 (Metro), which is intentionally off-PCB per the
    Wingshield-plus-jumpers connection strategy.
    Auto-assigned via tools/assign_cap_footprints.py:
    - buffer_keyer: C39, C40 (100 nF, THT disc D5.0mm P5.00mm) -- the null-
    trim bypass caps at R_INJ1 / R_INJ2 that ground the DAC output side
    of the 330K injection resistors going into T1 and T2
    - arduino: C36, C38 (100 nF THT disc), C37 (10 uF radial electrolytic)
    - interface: C34 (100 nF), C35 (10 uF)
    Manual assignments:
    - interface: R26, R27, R28, R29 -> R_Axia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
    [arduino.kicad_sch, buffer_keyer.kicad_sch, interface.kicad_sch]
2026-07-07 schematic: I2C topology flip + CD14538B heartbeat + pre-layout audit
    - Documentation updates for the STEMMA-QT topology flip (MCP4728 upstream
    of Si5351): design_review_7-5-26 C1 marked resolved, build_checklist
    Phase 1 gets the 6-step first-boot procedure, cw_envelope_keyer I2C
    address section rewritten, front_panel_interface signal-chain diagram
    refreshed.
    - CD14538B dual retriggerable monostable added to xmitter.kicad_sym
    (PDIP-16, pinout verified against datasheet fig. 1), plus datasheet
    file.
    - Arduino sheet: CD14538B heartbeat topology on Q5 HV contactor -- U18
    + R30 470K + C41 1uF timing (t_w ~470 ms), Q7 series FET stack,
    C42/C43 VDD bypass and bulk.
    - Pre-layout audi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
    [KiCAD.kicad_sch, arduino.kicad_sch, bias.kicad_sch, buffer_keyer.kicad_sch, front_panel.kicad_sch, interface.kicad_sch, vfo.kicad_sch]
2026-07-07 kicad: convert hierarchical labels to globals (Path A) + unify _OUT/_IN pairs
    - 58 hierarchical_label -> global_label conversions across the six active
    sheets. Standard KiCad 10 global_label form with fields_autoplaced +
    Intersheetrefs property.
    - Stripped 36 vestigial sheet pins, 28 stitching wires, 2 junctions, 4
    labels from the root sheet. Sheet blocks remain; each is now a pure
    container with globals doing the cross-sheet connectivity by name.
    - Renamed three OUT/IN pairs to unified names so same-name globals
    auto-connect:
    GRID_CTL_A_OUT + GRID_CTL_A_IN -> GRID_CTL_A
    GRID_CTL_B_OUT + GRID_CTL_B_IN -> GRID_CTL_B
    RAW_RF_OUT + RAW_RF_IN -> RAW_RF
    - tools/conver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
    [KiCAD.kicad_sch, arduino.kicad_sch, bias.kicad_sch, buffer_keyer.kicad_sch, interface.kicad_sch, vfo.kicad_sch]
2026-07-07 kicad: fill 9 remaining footprints across active sheets
    - arduino: R30 470K (R_Axial_DIN0207 horizontal), C41 1uF (rect L7.2mm),
    C42 100nF (disc D5mm P5mm), C43 10uF (radial polarized D5mm P2mm)
    - bias: J11 (GRID_BIAS), J12 (CATHODE_SENSE), J14 -- all PinHeader_1x02
    vertical THT
    - buffer_keyer: J13 -- PinHeader_1x05 vertical THT
    - interface: J15 -- PinHeader_1x03 vertical THT
    C41/C42/C43 filled by re-running tools/assign_cap_footprints.py which
    already had the intended mappings. R30 and the connectors done by hand
    via a one-off script.
    Only U2 (Metro) remains footprint-less, intentionally off-PCB.
    Punch list updates for today's ERC pass + user's schematic edits:
    - B3 (footprints) reso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
    [arduino.kicad_sch, bias.kicad_sch, buffer_keyer.kicad_sch, interface.kicad_sch, vfo.kicad_sch]
2026-07-07 kicad: PWR_FLAGs added, most +3.3V converted to 3V3, VFO renames + J2 NC
    User work today:
    - Placed PWR_FLAGs to silence "power_pin_not_driven" ERC errors for VEE,
    +12V, -90V rails (see B5a-B5f in the punch list)
    - Converted 6 of 7 +3.3V power symbols to 3V3 global labels project-wide
    (one +3.3V remains on bias sheet, resolves next pass)
    - VFO sheet: C_coup -> C_IN1, R6 -> RD1 (both were unannotated / duplicate
    ref designators; ERC B4a and B4b now resolved)
    - buffer_keyer: J2 pin 2 gets a no_connect flag (B4c resolved); TP2 and
    TP7 electrically wired to MOD_RF_OUT+/- via junctions (B4d/e resolved)
    Punch list updates:
    - B3 (footprints) marked done
    - B4a/b/c marked done
    - M5 (TX LED) c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
    [arduino.kicad_sch, bias.kicad_sch, buffer_keyer.kicad_sch, front_panel.kicad_sch, vfo.kicad_sch]
2026-07-07 buffer_keyer: annotate RLA + break RG_OP1/RF_OP1 duplicate pair
    - RLA -> RLA1 (3K9 load resistor at 177.80, 95.25 -- adds numeric suffix)
    - RG_OP1 at (237.49, 48.26) -> RG_OP2
    - RF_OP1 at (248.92, 44.45) -> RF_OP2
    (second op-amp's gain-set + feedback pair; first pair around U6 LM7171
    keeps the OP1 name)
    Resolves the three real ERC bugs from today's second pass. Remaining
    21 errors are all in the known-non-issue plateau (U17 unused P-pins,
    U17 A0-A2 hardware jumpers, U1 STEMMA-cabled GND, U2/U9 power-output
    pin-type quirk).
    [buffer_keyer.kicad_sch]
2026-07-07 arduino: add no_connect flags on U17 unused expander pins
    Explicit NC flags on all unused PCF8575 P-pins, IRQ, and hardware
    address jumper pins. Silences the U17 pin_not_connected and
    pin_not_driven ERC cluster at the schematic level instead of via
    ERC-panel Exclude. Cleaner and travels with the file.
    [arduino.kicad_sch]
2026-07-07 kicad: exclude U2 (Metro) from PCB + fix J1/J2/J3 footprints
    - U2 Metro ESP32-S3: on_board, in_bom, in_pos_files all set to no.
    Metro sits above the PCB on the Adafruit Wingshield -- it must not be
    imported to the board or included in BOM/pick-and-place. Silences the
    "Cannot add U2 (no footprint assigned)" error from Update PCB from
    Schematic.
    - buffer_keyer J1, J2, J3: replace stale
    TerminalBlock_Phoenix_MKDS-1,5-10-5.08_1x10 footprint (10-position TB
    wrong for 2-pin conns) with the standard
    Connector_PinHeader_2.54mm:PinHeader_1x02_P2.54mm_Vertical used
    everywhere else in the project.
    [arduino.kicad_sch, buffer_keyer.kicad_sch]
2026-07-09 kicad: VFO placed on PCB; Si5351 STEMMA footprint rebuilt
    - Adafruit_Si5351A_STEMMA.kicad_mod: rebuilt from physical breakout as
    2-row 10-pad through-hole with GND spacers between clocks. Top row:
    CLK2/GND/CLK1/GND/CLK0; bottom row: VIN/(NC)/GND/SCL/SDA. Mounting-hole
    rectangle 20.32 x 12.70 mm; pin rows at Y=+/-6.35 mm.
    - vfo.kicad_sch: removed CLK2 no_connect so VFO can source from CLK2
    (shorter physical trace than CLK0). CLK0/CLK1/SDA/SCL still NC.
    - KiCAD.kicad_pcb: initial VFO component placement on 200x150 mm board.
    Toroids L2/L4/L6 spaced 40/46 mm c-c (~23/29 mm edge-edge) so vertical
    L4 mount is no longer required. C44 100 nF within ~6 mm of Q1.
    - build_checklist.md: pre-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
    [KiCAD.kicad_pcb, vfo.kicad_sch]
2026-07-09 kicad: buffer_keyer partial placement + MCP4728 footprint rebuild
    - KiCAD.kicad_pcb: initial placement of 19 buffer_keyer parts (MC1496
    keyer, T1/T2 2N3906s, VEE divider R7/R8, LM4040, C4 10uF bulk, R_INJ1
    and adjacent passives) on the 200x150 board alongside the completed
    VFO block. Zero routing yet.
    - Adafruit_MCP4728_Breakout.kicad_mod: rebuild for the correct 2 x 6-pin
    physical layout (was 5+5). Top row JP2 = GND VA VB VC VD VCC, bottom
    row JP1 = VCC GND SCL SDA LDAC RDY. Duplicate VCC/GND pads share
    pad numbers (1,2) so they tie to the same nets as the symbol's VIN/GND.
    Silk labels rebuilt as 12 per-pin fp_text items centered on each pin's
    X coordinate for clear placemen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
    [KiCAD.kicad_pcb, buffer_keyer.kicad_sch]
2026-07-09 kicad: T68-6 hand-wound toroid footprints (flat + vertical)
    - xmitter.pretty/T68-6_Flat_HandWound.kicad_mod: flat mount for L2/L6.
    Both leads exit on the same radial side -- outer pad at (0, -10.0)
    1.23 mm outside OD, inner pad at (0, -2.5) inside the ID hole.
    Pitch 7.5 mm. Silk shows OD (17.53 mm) + ID (9.40 mm) circles.
    - xmitter.pretty/T68-6_Vertical_HandWound.kicad_mod: on-edge mount for L4.
    Top-down projection = OD x HT (17.53 x 4.83 mm) rectangle. Pads at
    (-2.0, -4.5) and (+2.0, +4.5) -- above and below the rectangle with
    the diagonal offset that matches natural lead exit after 4-turn winding.
    - vfo.kicad_sch: L2/L4/L6 footprint fields switched to the new project
    footprin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
    [KiCAD.kicad_pcb, vfo.kicad_sch]
2026-07-10 docs: two-box construction plan; kicad: ongoing layout + T1/T2 decoupling
    - construction.md: new "Electronics-in-a-separate-box strategy" section.
    Control PCB (MC1496 keyer, MCP4921 DAC, Si5351 VFO, MCP4728 DAC,
    Metro ESP32-S3) goes in a small metal box on top of the main chassis;
    MOD_RF_OUT+/- crosses the gap through bulkhead BNCs on both boxes.
    Recommended part Amphenol RF 112404. Documents the signal chain,
    balance/matching requirements for CW carrier suppression, and the
    grounding scheme (both boxes bonded through the coax shield).
    - buffer_keyer.kicad_sch: continued edits including the two 100nF
    VEE-to-GND decoupling caps at T1/T2 noted earlier.
    - KiCAD.kicad_pcb: ongoing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
    [KiCAD.kicad_pcb, buffer_keyer.kicad_sch]
2026-07-10 kicad: local VEE generator (ICL7660S + L7908) on buffer_keyer
    Replaces the external -8V (VEE) supply that previously came in through
    J3 with a locally-generated one from the existing +12V rail. Charge-pump
    inverts +12V to ~-11V, linear regulator drops to a clean -8V.
    Schematic (buffer_keyer.kicad_sch):
    - U15: ICL7660S charge pump (new symbol xmitter:ICL7660S_Boost with
    BOOST pin exposed on pin 1, tied to +12V for 35kHz oscillator).
    Package_DIP:DIP-8_W7.62mm.
    - U19: L79L08_TO92 fixed -8V negative regulator, TO-92 inline.
    Mirror-x removed so pin numbering (1=GND, 2=VI, 3=VO) matches the
    wiring.
    - C48 (10uF pump), C49 (100uF reservoir on charge-pump output), C50
    (10uF regulator outpu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
    [buffer_keyer.kicad_sch]
2026-07-11 kicad: buffer_keyer LM7805 local, J3 to bias, more testpoints
    - buffer_keyer.kicad_sch: LM7805 5V regulator + bypass caps copied over
    from bias sheet so this board only needs +12V input. Multiple new
    testpoints added: T1/T2 collectors, LDAC (near U8), DAC output (near
    U4), and one placeholder. Signals now covered end-to-end for
    envelope + modulator debugging.
    - bias.kicad_sch: J3 relocated here (was on buffer_keyer). J3 pin 1
    VEE previously conflicted with the new local VEE generator on
    buffer_keyer -- moving J3 to bias also means it belongs on the
    bias board once that becomes its own PCB. VEE pin will be
    repurposed as GND on that side.
    - arduino.kicad_sch: incidental annotat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
    [arduino.kicad_sch, bias.kicad_sch, buffer_keyer.kicad_sch]
2026-07-11 kicad: buffer_keyer part placement complete; component datasheets
    - KiCAD.kicad_pcb: placement for VEE generator (U15, U19, C47-C51, L7),
    local LM7805 + bypass caps, and new test points on buffer_keyer
    - arduino/buffer_keyer schematics: minor cleanup from PCB update pass
    - Documentation/Components: add 78F series, L79L, ICL7660S-A, Wurth
    Elek-caap datasheets for reference
    [KiCAD.kicad_pcb, arduino.kicad_sch, buffer_keyer.kicad_sch]
2026-07-11 kicad: additional placement tweaks on analog board
    Follow-on placement adjustments after the buffer_keyer VEE-generator
    part additions.
    [KiCAD.kicad_pcb]
2026-07-11 kicad: L79L08 local decoupling; unlink bias sheet from root
    - Add C17/C18 (0.33 uF Z5U SR205E334MAR) at L79L08 in/out to prevent
    oscillation and damp L7+U19 ringing
    - New footprint xmitter:Kyocera_SR20_MLCC for the SR20 style radial MLCC
    (2.54 mm pitch, 5.08 x 3.175 mm body)
    - Add SR-Series datasheet to Documentation/Components
    - Unlink bias sheet from root schematic — first step in splitting the
    bias circuit onto its own PCB
    [KiCAD.kicad_pcb, KiCAD.kicad_sch, buffer_keyer.kicad_sch]
2026-07-11 kicad: net classes for Power/RF/HIZ with patterns for labeled nets
    Adds Power (0.5mm/0.2mm), RF (0.4mm/0.25mm), and HIZ (0.3mm/0.25mm)
    classes with color-coding. Patterns catch +12V/+5V/3V3/VEE/GND and
    RAW_RF/MOD_RF_OUT+/- automatically. Anonymous nets (MC1496 out, DAC
    output, T1/T2 collectors, injection paths) still need labels or
    manual assignment.
    [KiCAD.kicad_pcb]
2026-07-11 kicad: label critical anon nets on buffer_keyer for netclass matching
    Global labels on MC1496 out (MC_OUT+/-), LM7171 driver outputs
    (DRV_OUT+/-), T1/T2 collectors, and MCP4728 injection nodes
    (VA_INJ/VB_INJ). Referenced by RF and HIZ patterns in netclass_patterns.
    [KiCAD.kicad_pcb, buffer_keyer.kicad_sch]
2026-07-12 kicad: RJE1D-188 footprint per datasheet + GND zones + net class tweaks
    - Rewrite xmitter:Amphenol_RJE1D-188_Horizontal_Shielded to correct
    interpretation from datasheet p-rje1d-188-x1x01.pdf: 8 signal pins in
    staggered rows (front 1,3,5,7 at Y=+3.96; back 2,4,6,8 at Y=+6.50),
    2 Ø1.57 plated shield tails at (+/-7.425, -6.79) tied to GND, 2 Ø3.0
    NPTH plastic locating posts at (+/-5, 0). Origin at post midpoint.
    - Add front/back GND zones on F.Cu/B.Cu inside Edge.Cuts
    - RF net class clearance 0.25 -> 0.20 to fix Q1 TO-92 DRC clearance error
    - Archive datasheet PDF and reference AI-generated footprint under
    Documentation/Components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
    [KiCAD.kicad_pcb]
2026-07-12 kicad: initial routing, netclass tweaks, routing cheatsheet
    - Start routing on buffer_keyer PCB (VEE + Net-(U19-VI))
    - Netclass assignments and pattern updates for anonymous power nets
    (U19/U20 chain)
    - Schematic tweaks alongside routing pass
    - Add Documentation/kicad_routing_cheatsheet.md — box-drawing tables
    for shortcut reference readable in `less`
    [KiCAD.kicad_pcb, buffer_keyer.kicad_sch]
2026-07-12 kicad: fix GND zone net (was +12V); more routing progress
    - Both GND zones on F.Cu and B.Cu had (net "+12V") in the zone
    definition, so pour was filling the wrong net and every GND pad
    showed as unconnected. Corrected to (net "GND").
    - Additional routing and placement adjustments on buffer_keyer
    [KiCAD.kicad_pcb, buffer_keyer.kicad_sch]
2026-07-13 kicad: routing progress + VA/VB filter caps + LM7805 bulk cap
    - Add 100nF filter caps at R_INJ inputs (VA/VB) to block long-trace
    RF pickup at MC1496 carrier-null network
    - Add 10uF bulk cap at LM7805 output (C35 too far to serve this role)
    - More traces routed on buffer_keyer, some VA/VB routing on B.Cu to
    clear L2/L4 toroid area
    [KiCAD.kicad_pcb, buffer_keyer.kicad_sch]
2026-07-13 kicad: additional routing progress on buffer_keyer PCB
    [KiCAD.kicad_pcb]
2026-07-13 kicad: further routing progress on buffer_keyer PCB
    [KiCAD.kicad_pcb]
2026-07-13 kicad: fix L7 to Device:L symbol, add JFET gate leak on VFO
    - buffer_keyer.kicad_sch: L7 (22uH choke) now uses Device:L symbol
    instead of Device:R. Netlist and footprint unchanged; symbol now
    renders as inductor loops instead of resistor rectangle.
    - vfo.kicad_sch + PCB: added 10K gate-leak resistor at Q1 (J310 buffer)
    to provide DC gate reference. Was missing from KiCad implementation
    but present in QUCS reference schematic as RGL 1M (10K is fine).
    - 5 initial mounting holes placed on PCB (positions will be reworked in
    the next commit).
    [KiCAD.kicad_pcb, buffer_keyer.kicad_sch, vfo.kicad_sch]
2026-07-13 kicad: expand board to 130x170mm, 4 corner mounting holes, silk cleanup
    - Edge.Cuts expanded from 112x150 to 130x170 mm to make room for
    proper corner-inset mounting holes without conflicting with U1
    (Si5351 breakout) or L6 (T68-6 toroid)
    - 4 MountingHole_3.2mm_M3 at (11,10), (131,10), (11,170), (131,170)
    with 8+ mm clearance to nearest components
    - GND zones resized to match new outline
    - RJ45 (J4) repositioned and reconnected on the expanded board
    - Silk cleanup: 43 silk_overlap warnings resolved by moving reference
    designators
    - min_text_height rule dropped 0.8 -> 0.5 mm to accommodate external
    breakout footprints (U8, U17, J5, U1 silk was intentionally smaller)
    DRC: 24 violati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
    [KiCAD.kicad_pcb]
2026-07-13 kicad: down to 5 DRC violations, all silk cosmetic
    4 silk_over_copper (auto-clipped by fab) + 1 silk_overlap.
    No functional issues remain.
2026-07-13 docs: bring pcb_fab_checklist + front_panel_interface up to date
    Both docs had grown stale as the analog board approached fab-ready.
    Updates reflect actual current state.
    pcb_fab_checklist.md:
    - Add "Current status snapshot" at top: board is functionally fab-ready.
    - Section 1: RJE1D-188 footprint verified against datasheet 2026-07-12.
    All 5 previously-pending dimensions now checked.
    - Section 2: Interface RJ45 (J4), RS-422 receiver (U16 AM26LS32ACN),
    Arduino SDA/SCL/GRID_BLOCK_CRASH/LDAC labels all present.
    - Section 5: Board dimensions (130x170), 2-layer FR4 stack, 4 corner
    mounting holes all done.
    - Section 6: Net classes (Default/Power/RF/HIZ) set up. min_text_height
    reduced to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
2026-07-13 docs: correct relay driver location + add U18 heartbeat monostable
    - Relay drivers are on the arduino sheet, not the interface sheet:
    Q4/Q5/Q7 (2N7000 low-side drivers) + U17 (PCF8575 GPIO expander at
    0x21) drive J6/J7/J8/J9 headers.
    - U18 (CD14538B monostable) is the mains-interlock heartbeat: gates
    K_MAIN via firmware heartbeat; drops the relay when firmware halts.
    Test points TP11/TP18/TP19 provide bench-verification hooks.
    Earlier docs listed relay drivers as "deferred on interface sheet"
    which was wrong.
2026-07-14 docs: add RJ45 pin-numbering rev-1 verification to Phase 2
    Lightbox check on the plotted PDF (2026-07-13) confirmed the drill
    positions match the RJE1D-188 datasheet, but pin numbering vs
    T568B mapping is unverified without a physical part. Added a
    bench-verify step to Phase 2 to check both mounting orientations
    and confirm the SDA/SCL/MBL_*/power pin assignments before
    committing to a cable pinout. Two fallback paths noted (custom
    cable pinout vs rev-2 footprint fix) so it's not a blocker.
2026-07-14 rev 1: analog control board gerbers submitted to JLCPCB
    Order Y2-13077341A, placed 2026-07-14 07:56:41. 5 boards, standard
    2-layer FR4 TG135, 1.6mm, 1oz outer copper, HASL, green mask, white
    silk, tented vias. Board dimensions 130 x 170 mm. Currently in "Data
    Preparation" stage at JLCPCB.
    - Add KiCAD/gerber/ folder with the 9 files sent to fab (7 gerber
    layers + Excellon drill + gbrjob metadata) plus the gerber.zip
    actually uploaded. Definitive rev-1 fab artifact.
    - Update build_checklist.md Phase 2 with the order record.
    - Update pcb_fab_checklist.md current-status snapshot to note rev 1
    submitted, with the rev-2 punch-list items called out (RJ45 pin
    numbering verification, externa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
    [KiCAD-B_Cu.gbr, KiCAD-B_Mask.gbr, KiCAD-B_Silkscreen.gbr, KiCAD-Edge_Cuts.gbr, KiCAD-F_Cu.gbr, KiCAD-F_Mask.gbr, KiCAD-F_Silkscreen.gbr, KiCAD-job.gbrjob]
2026-07-14 docs: use "Rev A" (as silkscreened) instead of "rev 1"; parts ordered
    - Board silkscreen carries "Rev A" — align docs with that convention.
    - Next spin becomes "Rev B" (was "rev 2").
    - Note that parts orders have been placed (2026-07-14); one part on
    backorder, substitutes on hand if primary doesn't ship in time.
2026-07-15 Move analog board into KiCAD/analog/ subdirectory
    Restructure step 1 of the multi-board split: the original single-project
    KiCad layout at KiCAD/ becomes KiCAD/analog/analog.kicad_{pro,sch,pcb}.
    Sub-sheets and gerbers move alongside it. Shared libraries stay at
    KiCAD/xmitter.pretty and KiCAD/xmitter.kicad_sym; analog/'s per-project
    fp-lib-table and sym-lib-table point at them via \${KIPRJMOD}/..
    No schematic or PCB content is edited — only filenames and the two
    "filename" fields inside analog.kicad_pro / analog.kicad_prl to match
    the rename. Rev A gerbers are preserved byte-identical under
    KiCAD/analog/gerber/.
    Reversal steps: KiCAD/MULTIBOARD_REVERT.md.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
    [KiCAD-B_Cu.gbr, KiCAD-B_Mask.gbr, KiCAD-B_Silkscreen.gbr, KiCAD-Edge_Cuts.gbr, KiCAD-F_Cu.gbr, KiCAD-F_Mask.gbr, KiCAD-F_Silkscreen.gbr, KiCAD-job.gbrjob]
2026-07-15 Create KiCAD/bias/ project for the bias board
    Multi-board split step 2. bias.kicad_sch was already unlinked from the
    analog root; give it its own KiCad project so it can be laid out as a
    standalone PCB with its own DRC rules.
    bias.kicad_pro is seeded from a copy of analog.kicad_pro so the same
    netclass palette and drawing defaults carry over; sheet references
    retargeted to bias.kicad_sch (root UUID a692cd1f). fp-lib-table /
    sym-lib-table point at the shared KiCAD/xmitter.pretty and
    KiCAD/xmitter.kicad_sym via \${KIPRJMOD}/..
    No bias.kicad_pcb yet — KiCad creates one on first save. Any
    hierarchical labels in bias.kicad_sch that were meant to cross into
    a parent sheet should be converted t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
    [bias.kicad_sch]
2026-07-15 Create KiCAD/frontpanel/ project (empty)
    Multi-board split step 3. Stub project for the front-panel PCB
    (display, encoders, PCF8575 master, other end of the RJ45 umbilical).
    Empty root schematic; user draws content in KiCad.
    Project file seeded from analog.kicad_pro so netclass palette and
    drawing defaults carry over; retargeted to frontpanel.kicad_sch
    (root UUID ee8ebf10). fp-lib-table / sym-lib-table point at shared
    libs via \${KIPRJMOD}/..
    Naming note: the analog board's "interface.kicad_sch" is the
    umbilical-jack end (RJ45 on analog side); this frontpanel project
    is the actual front-panel PCB (opposite end of the same cable).
    [frontpanel.kicad_sch]
2026-07-15 Update CLAUDE.md for multi-board KiCAD layout
    Rewrite the directory map + current-focus section to reflect the split
    into KiCAD/analog/, KiCAD/bias/, and KiCAD/frontpanel/. Update the
    assign_cap_footprints.py command with new sub-sheet paths.
    tools/gen_parts_list_xlsx.py walks QUCS-S .sch files, not KiCad — no
    change needed there. One-shot scripts (rewire_arduino_for_stemma.py,
    add_3v3_label_buffer_keyer.py, rewrite_metro_symbol.py,
    convert_hier_to_global.py, strip_root_stitching.py, vfo_placement_audit.py,
    trace_*.py) still reference pre-split paths; left as-is since they're
    historical fix-ups that already ran — a hard "file not found" on re-run
    is a safer failure mode than silently ed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
2026-07-15 Drop empty stubs (PA/Driver/Balun/LPF_output/Front_Panel) from analog
    None of these contributed components, nets, or PCB footprints on Rev A;
    they were placeholder sub-sheets for future work. PA/Driver/Balun/
    LPF_output will come back when the RF-chain board project is created
    (a separate KiCAD/rf/ project, not part of analog). Front_Panel notes
    were preserved by copying the text block into KiCAD/frontpanel/
    frontpanel.kicad_sch first — the new frontpanel project is the actual
    front-panel PCB.
    Removed from analog.kicad_sch: five (sheet ...) blocks.
    Removed from analog.kicad_pro: five UUID entries in the "sheets" list.
    Deleted files: driver/pa/balun/lpf_output/front_panel.kicad_sch.
    Rev A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
    [analog.kicad_sch, balun.kicad_sch, driver.kicad_sch, front_panel.kicad_sch, frontpanel.kicad_sch, lpf_output.kicad_sch, pa.kicad_sch]
2026-07-15 Gitignore .kicad_prl (per-user editor state, not design content)
    .kicad_prl stores open-tab list, zoom level, active PCB layer, panel
    visibility — none of it defines the board. Tracking it causes noise
    diffs every time KiCad opens and re-saves the project. Standard KiCad
    convention is to gitignore it.
    Untracks the previously-committed KiCAD/analog/analog.kicad_prl (file
    remains on disk locally, just no longer in the repo). Also keeps the
    new KiCAD/bias/bias.kicad_prl and KiCAD/frontpanel/frontpanel.kicad_prl
    out of the repo.
2026-07-15 firmware: initial console + I2C scan + MCP4728 EEPROM reprogram command
    First runnable firmware for the analog board bring-up sequence.
    Adds two console commands over USB-CDC:
    - `i2c scan` -- probe 0x08..0x77 and report responding devices
    - `mcp4728 reprogram <cur_hex> <new_hex> [-y]` -- dry-run prints the
    byte plan for datasheet verification; `-y` burns EEPROM
    Also aligns pin_map.h with the Rev A schematic reality:
    - LDAC_4728 on GPIO 7 (Metro D7)
    - Paddle DIT/DAH on D5/D6 (was stale A4/A5)
    - Obsolete direct-encoder GPIOs NC'd (encoders now on I2C QT breakouts)
    - I2C address plan aligned with 0x67 MCP4728 target and 0x37/0x38 QT
    rotary addresses (STEP moved off 0x36 to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
    [console_shell.cpp, console_shell.h, i2c_scan.cpp, i2c_scan.h, main.cpp, mcp4728.cpp, mcp4728.h, pin_map.h]
2026-07-15 Front-panel PCB topology + I2C address plan alignment + 5734 symbol fix
    Switch the front panel from a hand-wired vector board with a cut CAT6
    pigtail to a real PCB with an Amphenol RJE1D-188-21401 socket at each
    end of a commercial CAT6 patch cable. Shield ground stays single-point
    at the analog board; the front-panel socket's shield-tab pads are left
    floating on the schematic, with a GND-isolated PCB zone poured around
    the connector body at layout time.
    Reflect the current I2C address plan (updated 2026-07-15):
    - MCP4728 0x67 (was 0x62 in older docs -- reserves 0x62/0x63 for
    future MCP4725 bias DACs)
    - STEP QT 0x37 (A0 jumper -- dodges the Metro's on-board MAX17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
    [frontpanel.kicad_sch]
2026-07-15 Front-panel schematic: complete wiring, MBL-600 pinout aligned with analog
    Complete the front-panel schematic build-out. Initial MBL-600 <-> RJ45
    wiring disagreed with the analog interface sheet's T568B pinout; rewired
    to conform. ERC now passes with zero errors/warnings.
    - J1 (RJE1D-188): signal pins labeled per T568B, shield tabs NC
    (single-point ground stays at the analog board end).
    - ENC3 (MBL-600 / Adafruit #5734): A+/A-/B+/B- to RJ45 pins 3/6/7/8
    matching interface.kicad_sch J4.
    - LCD1 (WH2004A) 4-bit mode: DB4-DB7 to PCF8575 via LCD_D4..LCD_D7,
    DB0-DB3 marked NC, R/W tied to GND, RV1=10k contrast pot on V0.
    - Backlight: pin 15 to +5V direct; cathodes through R1/R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
    [frontpanel.kicad_sch]
2026-07-16 Front-panel: PCF8575 address fix, MCP4725 for LCD contrast, footprints, i2c_bus.md
    PCF8575 A0/A1 configuration had the two boards' addresses swapped in
    all documentation, firmware, and the frontpanel schematic text note.
    Actual wiring: main-board U17 (arduino sheet, A0 open) = 0x20 for relay
    drives; front-panel U1 (A0 jumper closed) = 0x21 for LCD/LEDs. Fixed
    in firmware/main/pin_map.h, front_panel_interface.md, and (user-side)
    the schematic text note.
    Assign footprints to all previously-unassigned components on the
    front-panel schematic, using the analog board's conventions:
    - Device:C 100nF -> Capacitor_THT:C_Disc_D5.0mm_W2.5mm_P5.00mm
    - Device:C_Polarized 10uF -> Capacitor_T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
    [frontpanel.kicad_pcb, frontpanel.kicad_sch]
2026-07-19 firmware: build out software framework -- LCD, PCF8575, VFO knob, display
    Add drivers and integration for the front-panel subsystem:
    - pcf8575.cpp/.h -- I2C 16-bit GPIO expander driver. Shadow-based
    bit manipulation, write/read primitives. Reusable across the two
    PCF8575s on the shared bus.
    - lcd_hd44780.cpp/.h -- HD44780 4-bit LCD driver riding on a PCF8575.
    Runs the standard Winstar WH2004A wake-up sequence. Pin map is
    configurable at begin(); default matches the front-panel schematic
    (RS=P12, E=P11, DB4-7=P4-7, RGB backlight FET gates=P8-10).
    - display.cpp/.h -- high-level display task owning the front-panel
    PCF8575 (0x21) and the LCD. Periodic refresh o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
2026-07-19 Front-panel PCB: layout complete, DFM verified, ready for fab
    Complete the front-panel PCB layout. ERC clean, DRC clean except for
    two silk_over_copper warnings on J1 SH pads (cosmetic; RJE1D-188
    footprint silk box crosses the shield tab pads. Irrelevant since the
    shield is intentionally left floating on this board).
    Layout details:
    - Board: 78 x 85 mm, 4x M3 corner mounting holes at 4 mm inset.
    - GND pours on F.Cu and B.Cu. RJ45 shield isolation keepout
    (17.5 x 16 mm) on both layers prevents pour from touching the
    floating SH tabs.
    - Track widths 0.2 - 0.5 mm (JLC min 0.127 mm). 4 vias, 142 tracks.
    - Drill sizes 0.3 - 3.0 mm (JLC min 0.3 mm; aspect ratio 5.3:1 max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
    [frontpanel.kicad_pcb, frontpanel.kicad_sch]
2026-07-22 Front-panel PCB: re-add corner mounting holes; ignore fab outputs
    Re-add four M3 corner mounting holes (MH1-MH4 at 4 mm inset from the
    78 x 85 mm board edges) that got wiped when the layout was redone.
    Same specs as the analog board: MountingHole:MountingHole_3.2mm_M3,
    non-plated Ø3.2 mm. Chassis-side mounting scheme; the courtyard-
    overlap warning between MH3 and U2 is a DRC false-alarm for this
    board (no top-side hardware).
    Also extend .gitignore to cover:
    - Gerber output directories and archives (regenerable from
    .kicad_pcb; standard convention for KiCad projects).
    - ERC/DRC/report files in per-board subdirectories (previously
    only the top-level ones were ignored).
    Front-p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
    [frontpanel.kicad_pcb]
2026-07-22 Component bin inventory: 24-bin allocation across all boards
    Add tools/gen_bin_inventory.py that walks the six schematic sheets
    (analog root + arduino + buffer_keyer + vfo + interface + bias +
    frontpanel) and aggregates R / C / Q / U components by (type, value).
    Produces both a full detail CSV and a bin-allocation CSV constrained
    to <=24 bins for physical parts-drawer storage.
    Excludes Adafruit breakouts, Metro carrier, LCD module, and encoders
    (those live as modules on shelves, not in resistor bins).
    Total: 152 components, 42 unique values, 24 bins. Allocation:
    Resistors 8 bins (dedicated slot for 10 kohm which has 10 pcs)
    Capacitors 6 bins (dedicated slots for 100 nF and 10 u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
    [component_bins.csv, component_inventory.csv]
2026-07-27 VFO LPF: correct AL to 4.7 nH/t^2, add Method B sensitivity study
    Correct the T68-6 AL value across four design docs (LPF_stage,
    control_board_BOM_and_wire_plan, driver_stage, vfo_input_stage)
    from a stale 11.5 nH/t^2 (that is T106-6's AL) to the correct
    4.7 nH/t^2 per Micrometals #6 datasheet (L100 = 47 uH). Recompute
    turn counts: VFO LPF now specs 12/13/12 turns on T68-6 for
    680/790/680 nH (asymmetric build matches the ideal 647/715/647
    within +5 to +10%). Output LPF revised to 11 turns on T68-6 for
    569 nH.
    Flag open item in driver_stage.md: the driver output transformer
    SPICE model specifies L per half far higher than what a T68-6
    winding can produce with the current turn count, dating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
    [gen_doc_index.py, lpf_sensitivity.py]
2026-07-27 VFO subcircuit: sync inductor values with corrected LPF spec
    Update LF2/LF6 = 680nH, LF4 = 790nH to match the 12/13/12 turns
    on T68-6 build spec'd in vfo_input_stage.md and
    control_board_BOM_and_wire_plan.md (AL = 4.7 nH/t^2, Micrometals #6).
    Also picks up in-QUCS edits from the same session: coupling
    C1 (10nF) + high-Z termination R1 (1MOhm) on the source side,
    AC sweep range narrowed to 10-80 MHz, added AC display Rect.
    [vfo_subcircuit.sch]
2026-08-04 firmware: LCD-only bring-up entry point (LCD_BRINGUP build option)
    Adds main_lcd_bringup.cpp -- a standalone app_main that skips all the
    transmitter-side init (VFO, MCP4728, cathode, faults, shell) so a
    front-panel-only bench test doesn't spam errors from absent hardware.
    Cycles "Red" / "Green" / "Blue" every 5 s on the LCD, with the active
    color's backlight breathing 40 -> 60 -> 40 % via 6-bit BAM on the PCF8575
    backlight FET bits while the other two channels hold at 50 %. Also sets
    the MCP4725 contrast DAC to 0.7 V (code 573 @ 5 V Vref) at startup so
    characters are visible on the first frame.
    Select with -DLCD_BRINGUP=ON at configure time; the normal main.cpp
    app_main is guarded by #ifnd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
    [main.cpp, main_lcd_bringup.cpp]
2026-08-08 firmware: LCD bring-up -- disable PWM for flicker debug
    Hold all three backlight FETs steady ON at boot; keep the 5 s word cycle
    so text-update path is still exercised. Row 3 now reads "PWM off (debug)"
    in place of the RGB percentages so it's obvious at a glance which build
    is running.
    If text is stable under a steady backlight, the flicker was PWM-driven
    (busy-wait sub-frames racing LCD writes on the same PCF8575 shadow).
    If it still flickers, look at contrast (MCP4725 code), E-strobe timing,
    or 5 V rail sag.
    [main_lcd_bringup.cpp]
2026-08-08 firmware: add bringup.bat -- one-shot build/flash/monitor for LCD test
    Runs from plain cmd.exe (activates ESP-IDF itself, no PowerShell shortcut
    needed). Auto-detects COM port, or override with "bringup.bat COM7".
    Reason: can't easily copy/paste the idf.py invocation between machines
    over RDP; double-click convenience beats retyping the long command each
    bench session.
2026-08-08 firmware: LCD bring-up -- restore RGB PWM via esp_timer + mutex
    Rewrites the backlight PWM to run off an esp_timer one-shot instead of
    a busy-wait loop. Callback fires at each BAM sub-frame boundary, takes
    a mutex around the PCF8575 shadow write, releases it, re-arms itself.
    LCD text writes take the same mutex, so a row-write can never interrupt
    a sub-frame mid-transaction. If the mutex is contended when the timer
    fires we skip that sub-frame -- worst case is one BAM bit's worth of
    brightness deviation on one channel, invisible in practice.
    Resolution dropped from 6-bit / 60 Hz to 5-bit / 65 Hz. 32 levels is
    still ample for a 40-60% breathe and the shorter longest slot (8 ms vs
    16 ms) k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
    [main_lcd_bringup.cpp]
2026-08-08 firmware: LCD bring-up -- solo-color diagnostic test
    Temporarily replaces the 40-60% triangle breathe with a solo-color test:
    during "Red" the R channel is 100 % and G/B are 0 %; likewise for Green
    and Blue. Isolates each channel to determine whether the earlier
    "minimal color" report reflects a washed-out 50 %-baseline scheme or
    actual per-channel weakness.
    Revert / re-parameterize once we know which.
    [main_lcd_bringup.cpp]
2026-08-08 firmware: LCD bring-up -- encoder-controlled contrast
    Adds a minimal Adafruit seesaw driver (SW-reset + read encoder delta) and
    wires an I2C QT rotary encoder at 0x37 to the MCP4725 contrast DAC.
    Each detent = ~50 mV (40 DAC codes). LCD row 3 shows a 20-cell bar
    graph of current contrast; row 2 shows the DAC code + voltage.
    Backlight is held steady white this stage -- color cycling was proven
    working in stage 1a and adding encoder control on top would compete for
    PCF8575 shadow serialization. PWM machinery removed; will come back
    once we know the encoder path is solid.
    Encoder needs A0 jumper closed on the QT breakout to move off factory
    0x36 (collides with Metro on-board MAX17048).
    Co-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
    [main_lcd_bringup.cpp]
2026-08-08 firmware: LCD bring-up -- show rev number on row 0 (starts at 0)
    Replaces the fixed "LCD bring-up test" banner with " Rev N" driven by
    a single constexpr FW_REV. Bump FW_REV on every code change so the
    bench can tell at a glance which build is flashed without alt-tabbing
    to the serial monitor.
    Also enlarges the contrast-row snprintf buffer from 21 -> 32 bytes and
    hard-terminates at byte 20 for the LCD write. -Wformat-truncation
    can't prove %f is bounded and was failing the build.
    [main_lcd_bringup.cpp]
2026-08-08 firmware: LCD bring-up rev 1 -- encoder controls backlight duty
    Bench found the LCD contrast sweet spot at DAC=493 (~0.6 V); fix it
    there at startup and stop touching the MCP4725 afterwards. Repurpose
    the QT rotary encoder from contrast to backlight brightness.
    Backlight is uniform white via 5-bit BAM PWM (one common duty on all
    three RGB FETs). esp_timer + PCF8575 shadow mutex path from stage-1b
    brought back; single s_duty byte replaces the three per-channel target
    variables from the color-cycle build.
    Each encoder detent = 1 duty level (~3 %); 32 detents span the full
    0-100 % range. Row 2 shows "Level N/31 P%", row 3 is a 20-cell bar.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
    [main_lcd_bringup.cpp]
2026-08-08 firmware: bring-up rev 2 -- Si5351 VFO on, encoder tunes +/- 1 kHz
    Analog-board bring-up: Si5351 breakout + Chebyshev LPF only populated
    this stage. Firmware programs CLK0 to 14.200 MHz on boot and enables
    the output so a scope can see RF into the LPF.
    Encoder role changes from backlight to VFO frequency: 1 detent = 1 kHz
    step, clamped 14.000-14.350 MHz. Backlight fixes at 17/31 duty (PWM
    still runs at that constant level, no encoder control of backlight
    anymore).
    LCD row 2 shows " 14,200,000 Hz " style; row 3 static "Step: 1 kHz".
    FW_REV bumped 1 -> 2.
    [main_lcd_bringup.cpp]
2026-08-11 firmware: switch Si5351 driver from CLK0 to CLK2
    Rev A analog board routes CLK2 (not CLK0) to the buffer/keyer input.
    Update the driver to program MS2 + CLK2_CTRL and drop the enable bit
    for CLK2 (0xFB) instead of CLK0 (0xFE) in the output-enable register.
    Register mapping used:
    REG_CLK2_CTRL = 18 (was CLK0 = 16)
    REG_MS2_BASE = 58 (was MS0 = 42)
    OE_CLK2_ON = 0xFB (was OE_CLK0 = 0xFE)
    Control byte value is unchanged (0x4F) -- integer mode + PLLA + 8 mA
    drive is identical for any of the three MultiSynths.
    Bring-up FW_REV bumped 2 -> 3.
2026-08-12 firmware: rev 4 -- MCP4728 startup address check + auto-reprogram
    Add mcp4728_check_and_reprogram() before vfo::init(). Probes 0x60 and
    0x67; four outcomes:
    * both ACK -> MCP4728 already at 0x67, Si5351 at 0x60, normal
    * only 0x67 ACK -> MCP4728 done, Si5351 not yet on bus (warn)
    * only 0x60 ACK -> identify by writing/reading Si5351 REG_OUTPUT_
    ENABLE. If it echoes 0xFF back, it is a Si5351
    and we skip the reprogram. If not, assume factory
    MCP4728 and reprogram to 0x67, then verify.
    * neither ACK -> log, continue (Si5351 init will fail loudly)
    Discriminator is safe on both chips: writing 0xFF to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
    [main_lcd_bringup.cpp]
2026-08-12 firmware: rev 5 -- LCD up first; boot status on row 1; quieter serial
    Rewrite of app_main boot ordering to address three complaints:
    1. "Errors scroll too fast to read" -- silence the chatty tags
    (i2c.master, vfo, mcp4728, pcf8575, lcd) at ESP_LOG_WARN. Own
    "bringup" tag stays INFO. Set_freq no longer floods the log on
    every encoder detent.
    2. "Display no longer being written" -- reorder app_main so the LCD
    driver + backlight are up BEFORE any address probing or Si5351
    init. Row 1 shows a short boot-status string that updates as
    each stage runs; the last error message stays visible on the LCD
    even after the serial log scrolls off.
    3. "Errors could be clea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
    [main_lcd_bringup.cpp]
2026-08-12 firmware: rev 6 -- fix MCP4728 reprogram byte encoding
    Two bugs in plan_reprogram_bytes() that made the reprogram ACK cleanly
    but leave the chip's address unchanged:
    * Wrong base pattern (0x68). Yielded byte 0x76 for a 0x60->0x67
    reprogram; the chip decodes 0x76 as C2:C1=01 = Multi-Write DAC
    (writes to DAC channel C), not the "Write I2C Address" command.
    * Only two payload bytes sent; the actual protocol per DS22187
    §5.6.6 needs three command bytes:
    cmd 1: 0110 0AAA 1 with A = CURRENT addr bits ("prove you
    know me")
    cmd 2: 0110 0AAA 0 with A = NEW addr bits (data)
    cmd 3: 0110 0AAA 1 with A = NEW addr bits (confirm)
    New en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
    [main_lcd_bringup.cpp, mcp4728.cpp]
2026-08-12 firmware: rev 7 -- MCP4728 reprogram robustness
    Two changes to unstick the reprogram path:
    * Drop the Si5351-vs-MCP4728 discrimination step at 0x60. Rev 5-6
    ran a probe-write (write 0xFF to reg 3, read back) before the
    reprogram; that probe-write left ESP-IDF's i2c_master in a state
    where the next transmit failed with ESP_ERR_INVALID_STATE. The
    discrimination was theoretical hedging -- user's stated bench
    sequence (install MCP4728 alone first, add Si5351 later) means
    "0x60 alone" unambiguously = factory MCP4728, so skip it.
    Side effect: if somebody DID hook up a Si5351 alone at 0x60, we
    would try to reprogram it and fail; the Si5351 registers would
    g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
    [main_lcd_bringup.cpp]
2026-08-12 firmware: rev 8 -- MCP4728 reprogram diagnostic (LDAC HIGH throughout)
    Bench log shows every reprogram transmit returning ESP_ERR_INVALID_STATE.
    In ESP-IDF v5.4 that's what i2c_master_transmit returns when the slave
    NAKs the address byte -- so the chip is refusing to talk when LDAC is
    LOW before the START condition.
    Per DS22187 §4.5.3.3 the datasheet explicitly says LDAC must be HIGH
    when START is generated (and transitions LOW during the slave-address
    ACK). Our previous code violated that by pulling LDAC LOW before
    START -- some MCP4728 revisions apparently refuse to ACK in that state.
    This rev holds LDAC HIGH for the whole transmit, then pulses LOW after.
    Won't perform a "proper" repro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
    [main_lcd_bringup.cpp, mcp4728.cpp]
2026-08-12 firmware: add LDAC scope diagnostic build (ldac_scope.bat)
    Adds a second build path -DLDAC_SCOPE_ONLY=ON that skips normal bring-up
    and just toggles GPIO 7 (Arduino D7 / MCP4728 LDAC) at 100 Hz forever.
    Point of the diagnostic is to prove or disprove that the D7 -> LDAC
    jumper is intact -- our reprogram keeps NAKing and it's time to rule
    out wiring vs firmware.
    * ldac_scope.bat -- one-click build/flash/monitor for the diagnostic.
    * CMakeLists.txt -- LDAC_SCOPE_ONLY option adds the #define.
    * main_lcd_bringup.cpp -- app_main branches on LDAC_SCOPE_ONLY at the
    very top; normal bring-up code is unchanged, guaranteed not entered
    when the diagnostic runs.
    Reflash with bringup.bat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
    [main_lcd_bringup.cpp]
2026-08-13 firmware: LDAC scope diagnostic -- gpio_reset_pin + INPUT_OUTPUT + readback
    Previous scope test used gpio_config(GPIO_MODE_OUTPUT). User disconnected
    the wire to the MCP4728 breakout, so nothing external was on the pad, and
    still saw D7 stuck HIGH while adjacent pins were LOW. That points to
    either (a) gpio_config not fully overriding whatever prior state ROM/
    USB-JTAG left on GPIO 7 or (b) a hardware fault on that specific pad.
    Three changes to disambiguate:
    1. gpio_reset_pin() first -- unbinds any peripheral wiring, disables
    pull-up/down, clears interrupts. Truly blank slate.
    2. gpio_set_direction INPUT_OUTPUT so we can read the pad back while
    still driving it.
    3. Log g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
    [main_lcd_bringup.cpp]
2026-08-13 firmware: LDAC scope -- crash-safe, heartbeat, error-log-not-panic
    Bench pattern (D7 pulses briefly, cycles a few times, then stuck HIGH)
    matches an ESP32 panic-reboot loop. Previous rev used ESP_ERROR_CHECK
    around gpio_reset_pin / gpio_set_pull_mode / gpio_set_direction /
    gpio_set_level; if any of those returned an error on this specific
    hardware, the panic path would exactly reproduce what's seen on the pad.
    New diagnostic:
    * No ESP_ERROR_CHECK anywhere -- every gpio API call's err code just
    gets logged to serial and the code continues.
    * Hardcode GPIO_NUM_7 (rule out pins:: namespace weirdness).
    * Plain GPIO_MODE_OUTPUT (skip INPUT_OUTPUT and gpio_get_level;
    both are addit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
    [main_lcd_bringup.cpp]
2026-08-13 firmware: batch files -- fullclean before every build
    Bench reports "LCD still shows Rev 8" after switching from bringup.bat
    to ldac_scope.bat, meaning ESP-IDF's build cache didn't pick up the
    -DLDAC_SCOPE_ONLY=ON flag change (LDAC scope guard should skip the LCD
    entirely). ESP-IDF's incremental build is code-diff-aware but not
    always -D-flag-aware; the recompile of main_lcd_bringup.cpp was elided.
    Insert "idf.py fullclean" before every build in both batch files.
    Costs ~30 s of extra build time; guarantees the binary matches whatever
    mode the .bat name says.
2026-08-13 firmware: rev 9 -- gpio_reset_pin in MCP4728 reprogram path
    Port the fix that unstuck the LDAC scope diagnostic (gpio_reset_pin +
    gpio_set_direction) into mcp4728::reprogram_address. On this Metro,
    gpio_config alone was leaving the pad refusing to be driven -- adjacent
    pins responded fine but GPIO 7 stayed HIGH. Once we called
    gpio_reset_pin first, GPIO 7 toggled cleanly on the scope. Same
    sequence now guarantees a clean pin state before the reprogram
    transaction.
    LDAC-HIGH-throughout behavior from rev 8 kept intact; if the chip
    still doesn't accept the reprogram on strict-timing chip revisions,
    next step is bit-banging.
    FW_REV bumped 8 -> 9 so the "which build am I running" LCD readout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
    [main_lcd_bringup.cpp, mcp4728.cpp]
2026-08-13 firmware: rev 10 -- MCP4728 reprogram: 400 kHz + GC reset + wait_all_done
    INVALID_STATE at exactly 60 ms on every reprogram attempt is too
    reproducible to be a slave NAK -- looks like ESP-IDF v5.4 i2c_master
    internal state. Three fixes stacked in this commit:
    1. General Call Reset (bus addr 0x00, data 0x06) issued BEFORE the
    reprogram transaction. Puts the MCP4728 back to POR state in
    case earlier LDAC-LOW attempts left it half-armed in reprogram
    mode with the state machine expecting a specific bit sequence.
    Sent best-effort -- errors are swallowed.
    2. i2c_master_bus_wait_all_done(100) before add_device. Ensures
    the driver has no queued/in-flight transaction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
    [main_lcd_bringup.cpp, mcp4728.cpp]
2026-08-13 firmware: rev 11 -- back out GC reset; probe before transmit; -Wunused fix
    Rev 10 log showed transmit still failing INVALID_STATE, and timing math
    confirmed it's returning IMMEDIATELY (the 60 ms observed was the post-
    transmit vTaskDelay for the EEPROM burn window, not a timeout). So
    the driver is refusing to queue the transaction outright.
    Working hypothesis after rev 10 evidence: the General Call Reset
    (0x00 / 0x06) I added left the i2c_master driver in a state where the
    follow-up transmit couldn't be queued. Removing it.
    Insurance added: a probe of cur_addr against the newly-added device
    handle, BEFORE the reprogram transmit. If that probe fails, we get
    a clean "chip not on bus" sign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
    [main.cpp, main_lcd_bringup.cpp, mcp4728.cpp]
2026-08-13 firmware: rev 12 -- always log the pre-reprogram probe result
    Rev 11 logged the probe outcome only on FAILURE, so a successful probe
    looked identical to no probe at all in the serial output. Bench user
    reasonably asked "did I miss it?" -- no, it was silent. Change to
    ESP_LOGI unconditionally, then still return early on error.
    No behavior change to the reprogram path itself; just visibility.
    [main_lcd_bringup.cpp, mcp4728.cpp]
2026-08-13 firmware: rev 13 -- bit-bang MCP4728 reprogram with datasheet LDAC timing
    Replace the ESP-IDF i2c_master reprogram path (which returned
    ESP_ERR_INVALID_STATE synchronously despite a preceding probe of the
    same address+handle succeeding) with a bit-bang implementation that
    temporarily hijacks SDA/SCL from the I2C0 peripheral matrix, drives
    the pins directly as GPIOs, and pulses LDAC HIGH -> LOW during the
    SCL-HIGH portion of the SLAVE ADDRESS byte's ACK bit -- exactly the
    timing DS22187 §4.5.3.3 calls out.
    Mechanism:
    1. wait_all_done on the i2c_master bus so it's idle.
    2. esp_rom_gpio_connect_out_signal(pin, SIG_GPIO_OUT_IDX, ...) to
    override the I2C peripheral's output signal on G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
    [main_lcd_bringup.cpp, mcp4728.cpp]
2026-08-13 firmware: rev 14 -- bit-bang @ 25 kHz + Adafruit-style LDAC-before-START
    Rev 13 got the address ACK but the three payload bytes all NAK'd. Two
    plausible causes stacked:
    * 100 kHz was aggressive with weak/mixed pull-ups on the bus (internal
    45k plus various 10k breakout pull-ups). Drop bit-bang clock to
    25 kHz -- BB_HALF_US 5 -> 20. Also bump SDA setup from 1 us -> 2 us
    and give the pull-up 3 us to lift SDA before sampling the ACK.
    * LDAC transition during the address-byte ACK window may have confused
    the state machine. Switch to the sequence Adafruit's Arduino
    MCP4728 library uses -- known to work on the same breakouts:
    1. bus idle (SDA, SCL HIGH)
    2.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
2026-08-13 firmware: rev 15 -- PCF8575 / LCD failure non-fatal; enables 5V-off tests
    Adds a namespace-scope s_display_ok bool that starts false and only
    becomes true if both s_pcf.begin() and s_lcd.begin() succeed. All the
    lcd_write_at / render_header_and_footer helpers now no-op when it's
    false, so PCF8575-missing / LCD-missing paths just skip LCD activity
    and continue.
    Motivation: MCP4728 reprogram diagnostic can now run with just the
    Metro (USB) + MCP4728 breakout (3.3 V from STEMMA QT) powered. Front-
    panel 5 V bench supply stays off so nothing else is on the I2C bus
    during the reprogram attempt -- cleaner isolation, faster power-cycle
    between attempts.
    Serial log continues to print each stage.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
    [main_lcd_bringup.cpp]
2026-08-14 firmware: rev 16 -- try legacy driver/i2c.h for the MCP4728 reprogram
    Both the new i2c_master.h stack and our own bit-bang produced identical
    addr:1 byte1:0 byte2:0 byte3:0 across two different chips, so it's not
    a chip defect and it's not the bit-level protocol we're generating.
    Left to try in-tree is ESP-IDF's legacy sync driver (driver/i2c.h) --
    completely different implementation than the new async driver, uses
    i2c_cmd_link_* + i2c_master_cmd_begin. Small chance it hits different
    timing/state that this chip revision will accept.
    Legacy and new drivers cannot coexist on the same port. So the flow
    is: install legacy driver EARLY (before i2c_bus_init), attempt the
    reprogram + verify, uni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
2026-08-14 firmware: rev 17 -- revert legacy driver attempt (boot-looped)
    Rev 16's legacy driver/i2c.h attempt boot-looped the Metro before even
    printing the rev banner. Almost certainly the two I2C driver stacks
    (driver/i2c_master.h + driver/i2c.h) can't safely coexist in a single
    compile unit on ESP-IDF v5.4.4 -- the link succeeds but the runtime
    behavior panics. Revert wholesale:
    * Remove #include "driver/i2c.h"
    * Remove the entire legacy_driver_reprogram_attempt() function
    * Restore the pre-legacy app_main flow (nvs -> i2c_bus_init)
    * Add fflush(stdout) after the rev banner so the banner is always
    guaranteed to make it out before any subsequent crash
    Back to rev 15 behavior + rev 16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
    [main_lcd_bringup.cpp]
2026-08-14 firmware: rev 18 -- LDAC timing per DS22187 5.6.8 (finally the right edge)
    The datasheet passage the user found nails what we were missing:
    "This command is valid only when the LDAC pin makes a transition from
    High to Low at the low time of the last bit (8th clock) of the
    second byte, and stays Low until the end of the third byte."
    Second byte here = second COMMAND byte (after the address), which for
    0x60 -> 0x67 is bytes[1] = 0x6E (the new-address byte). The LDAC
    edge has to happen during the SCL-LOW window after the LSB is sampled
    and before the ACK bit starts.
    Every previous attempt had LDAC transitioning at the WRONG time:
    rev 13: LDAC pulse during address-byte ACK
    rev 1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
    [main_lcd_bringup.cpp, mcp4728.cpp]
2026-08-14 arduino: one-shot MCP4728 reprogram sketch (0x60 -> 0x67)
    After six ESP-IDF variants (new i2c_master driver, bit-bang with
    multiple LDAC strategies, legacy driver) all failed to make our
    MCP4728 accept the "Write I2C Address" command, fall back to the
    Adafruit MCP4728 Arduino library. Same underlying I2C hardware,
    different driver stack, and empirically known to work on Adafruit-
    supplied breakouts.
    Sketch is one-shot:
    * Checks if 0x67 already ACKs (chip already reprogrammed -> no-op).
    * Confirms chip is at factory 0x60.
    * Calls Adafruit_MCP4728::setAddress(0x67, LDAC_PIN) -- library
    handles the LDAC toggle timing.
    * Verifies 0x67 now ACKs, prints SUCCESS or FAIL to serial.
    Be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
    [reprogram_mcp4728.ino]
2026-08-14 firmware: reprogram_only.bat -- isolated legacy-driver MCP4728 reprogram
    Rev 16 failed by putting driver/i2c.h + driver/i2c_master.h in the same
    compile unit (main_lcd_bringup.cpp), which likely caused the boot loop.
    This build fixes that by putting the legacy code in its own .cpp file
    that ONLY includes driver/i2c.h, and guarding both main.cpp and
    main_lcd_bringup.cpp so their app_mains drop out when REPROGRAM_ONLY
    is set.
    New file:
    * firmware/main/main_reprogram_only.cpp -- self-contained legacy-
    driver reprogram. Installs I2C_NUM_0 at 100 kHz, drives LDAC
    LOW-before-START (Adafruit style), sends the 3-byte command via
    i2c_cmd_link, verifies both 0x67 now ACKs and 0x60 no l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
    [main.cpp, main_lcd_bringup.cpp, main_reprogram_only.cpp]
2026-08-14 firmware: reprogram_only build -- true isolation, one .cpp compiled
    Previous rev registered ALL main/*.cpp files with idf_component_register
    regardless of build flags. Even though the OTHER app_mains were
    #ifdef'd out, the files still got compiled and pulled driver/i2c_master.h
    into the link. Boot loop reproduced with the same symptoms.
    Real fix: conditionally set the SRCS list at CMake time.
    if(REPROGRAM_ONLY)
    set(app_srcs "main_reprogram_only.cpp") # ONE file
    else()
    set(app_srcs <the usual list>)
    endif()
    Nothing else gets compiled in REPROGRAM_ONLY mode. No i2c_master.h
    lives anywhere in the binary.
    Also inlined the plan_reprogram_bytes() logic in main_reprogram_o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
    [main_reprogram_only.cpp]
2026-08-14 arduino: reprogram sketch -- use raw Wire, drop Adafruit lib dep
    Rev 1 of the sketch called mcp.setAddress() on Adafruit_MCP4728, but
    that method doesn't actually exist in the library's public API. Would
    have been a compile error the moment the user tried Upload.
    Rewrite to use raw Wire (built into Arduino ESP32; no library install).
    Sends the same 3-byte "Write I2C Address" sequence Adafruit's C library
    would send, LDAC LOW-before-START (before Wire.endTransmission's actual
    transaction).
    Also removes the library install step from the docs -- simpler bench
    setup, one less thing to go wrong.
    [reprogram_mcp4728.ino]
2026-08-14 mcp4728 reprogram: fix byte encoding + LDAC-timing per jknipper's proven impl
    Reference: https://github.com/jknipper/mcp4728_program_address which uses
    TrippyLighting's SoftI2cMaster ldacwrite() to actually make the MCP4728
    "Write I2C Address" command work. Two things every previous attempt got
    wrong:
    BYTE ENCODING (was: "Adafruit style", turned out to be a myth):
    Correct layout:
    Bits [7:5] = 011 (command family)
    Bits [4:2] = A2 A1 A0 (address bits, shifted LEFT by 2)
    Bits [1:0] = role code (01 arm, 10 new, 11 confirm)
    For 0x60 -> 0x67:
    byte 2 (arm w/ cur): was 0x61 -> now 0x61 (same because cur=0)
    byte 3 (new addr): was 0x6E -> now 0x7E
    byte 4 (confir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
    [mcp4728.cpp, reprogram_mcp4728.ino]
2026-08-15 firmware: rev 19 -- I2C bus scan at boot (full 0x08..0x77 sweep)
    Adds i2c_scan::scan(s_bus) call right after i2c_bus_init() in the
    bring-up app_main. Prints every ACKing address to serial so you can
    verify the whole bus at boot instead of guessing per-device.
    Everything else is unchanged from rev 18: Si5351 CLK2 at 14.200 MHz
    on boot, encoder at 1 kHz/detent (clamped 14.000-14.350 MHz), backlight
    17/31 duty white. Reprogrammed MCP4728 should now show at 0x67 in the
    scan output.
    FW_REV bumped 18 -> 19.
2026-08-15 firmware: bat files -- COM port auto-detect (was hardcoded COM11)
    After the Arduino-based MCP4728 reprogram flashed Adafruit's VID/PID
    onto the Metro's USB CDC, Windows re-enumerated the device as COM12.
    Hardcoded -p COM11 in the bat files then failed to find the board.
    Switch all three bat files (bringup, ldac_scope, reprogram_only) to
    auto-detect the port by default, with the first arg as an optional
    override:
    bringup.bat <-- idf.py auto-detects
    bringup.bat COM12 <-- force COM12
2026-08-20 firmware: rev 21 -- encoder retry + I2C bus recovery after seesaw lockup
    Port firmware changes from revB (revs 20-21):
    Rev 20: seesaw ATTINY intermittent NAK fix -- retry read_delta up to 3x
    before skipping poll cycle; counts accumulate in seesaw so no detents
    are lost across retries.
    Rev 21: I2C bus recovery after encoder lockup. Seesaw holding SDA low
    corrupts PCF8575 LCD writes (display garbage then blank). After 8
    consecutive all-retry-exhausted failures (~400 ms): bus reset, 100 ms
    seesaw recovery delay, PCF8575 shadow re-apply, full HD44780 re-init,
    display redraw.
    [main_lcd_bringup.cpp]
2026-08-20 firmware: rev 22 -- interrupt-driven encoder reads via ENC_INT (D4/GPIO4)
    Replace 50 ms polling loop with GPIO falling-edge ISR + binary semaphore.
    All seesaw INT pins are open-drain active-low and can be wired-OR on J50;
    the ISR gives the semaphore, the task blocks on it with 100 ms timeout
    (keeps display refresh alive when encoder is idle).
    Key details:
    - enc_ready = semaphore taken (ISR path) OR gpio_get_level==0 (catches
    missed edges on wired-OR with multiple encoders)
    - Failure streak only increments when enc_ready is true -- timeout cycles
    (J50 not wired) do not falsely accumulate failures or trigger bus reset
    - Without J50 wired: GPIO4 held high by R102 (10k on board), ISR never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
    [main_lcd_bringup.cpp, pin_map.h]
2026-08-20 fix: rename J50 -> J5 throughout (schematic reference is J5)
    front_panel_interface.md, main_lcd_bringup.cpp, pin_map.h all had J50;
    arduino.kicad_sch has the header as J5.
    [main_lcd_bringup.cpp, pin_map.h]
2026-08-22 firmware: enable seesaw ENCODER_INTENSET so ENC_INT actually asserts
    SeesawEncoder::begin() was only issuing a SW reset; without writing
    ENCODER_INTENSET (0x11/0x10 = 0x01) the seesaw ATTINY never drives
    INT low on new counts, so the ISR never fired and enc_ready was always
    false.
    [main_lcd_bringup.cpp]
2026-08-23 firmware: fix encoder detent divisor -- seesaw returns 1 count per detent
    ENCODER_COUNTS_PER_DETENT was 4 (sized for raw PCNT reads of a bare
    PEC11 with 4 quadrature transitions per detent). The seesaw decodes
    quadrature internally and reports 1 count per mechanical click, so the
    /4 was eating every detent until 4 accumulated.
    [main_lcd_bringup.cpp]
2026-08-23 firmware: fix misleading ENC_INT boot message
    "J5 NOT wired -- polling disabled" was printed whenever GPIO4 read
    high at boot, which is the correct idle state when no encoder counts
    are pending. Changed to "idle-high (ok)" / "asserted at boot" to
    reflect what the level actually means.
    [main_lcd_bringup.cpp]
2026-08-23 firmware: rev 23 -- interrupt-driven MBL-600 + seesaw in bringup
    VfoKnob (MBL-600 optical encoder):
    - Replace 20 ms polling loop with PCNT watchpoint ISR at ±1 count.
    Task blocks on xSemaphoreTake(portMAX_DELAY); wakes only when the
    encoder moves. No CPU use at rest.
    - Register on_reach_isr via pcnt_unit_register_event_callbacks() before
    pcnt_unit_enable(), as required by ESP-IDF.
    - Drop poll_period parameter from start() -- no longer meaningful.
    main_lcd_bringup (rev 23):
    - Add Stage B2: init + start g_vfo_knob (PCNT, GPIO2/3, CORE_KEYING).
    - Sync s_freq_hz from vfo::current_freq() each bringup_task loop so
    MBL-600 moves update the LCD and seesaw steps start from correct base.
    -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
    [main_lcd_bringup.cpp, vfo_knob.cpp, vfo_knob.h]
2026-08-24 firmware: fix MBL-600 revert -- debounce + correct step size (rev 24)
    Three issues caused the VFO display to flash and revert to 14.200 MHz:
    1. base_step_hz_ default was 10 Hz instead of 50 Hz (encoders table default).
    A single-tick 10 Hz forward step was trivially cancelled by 1-tick
    bounce-back on knob release.
    2. No direction-reversal debounce. Added 20 ms window in VfoKnob::run():
    any reversal arriving within 20 ms of the last applied step is dropped,
    preventing a single backward tick from undoing the preceding forward step.
    3. bringup_task synced s_freq_hz from vfo::current_freq() AFTER applying
    the seesaw delta, so the seesaw used a stale base when both encoders
    mo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
    [main_lcd_bringup.cpp, vfo_knob.cpp, vfo_knob.h]
2026-08-24 firmware: fix MBL-600 direction and debounce (rev 25)
    Swap A/B argument order in begin() call sites -- encoder B leads A for CW
    on the Rev A board, so passing B as the 'leading' channel fixes both-directions-
    decrease. Reduce direction-reversal debounce from 20 ms to 5 ms so the first
    CCW click after a CW turn is not suppressed.
    [main.cpp, main_lcd_bringup.cpp, vfo_knob.cpp, vfo_knob.h]
2026-08-24 firmware: restore 20 ms debounce -- 5 ms too short for RS-422 noise (rev 26)
    The 'first click not picked up' symptom in rev 24 was caused by the wrong
    A/B direction, not the 20 ms window: CW set last_dir=-1 so the next CW tick
    looked like a reversal and was suppressed. With direction now correct in
    rev 25, the 20 ms window is needed to kill spurious reverse ticks from the
    RS-422 receive chain that arrive 5-20 ms after a real edge.
    [main_lcd_bringup.cpp, vfo_knob.cpp]
2026-08-24 firmware: switch MBL-600 to 2x decode -- drop chan_b (rev 27)
    With 4x decode, chan_b counts A-signal edges gated by the B-signal level.
    The A-signal rising edge is the FIRST transition of each CCW half-cycle, so
    B has barely settled when chan_b samples it; RS-422 skew through the receive
    chain puts B in the wrong state, producing a spurious +1 count. That +1
    fires the ISR before the real -1 arrives, causing CCW to increment before
    decrementing (net zero), and with the 20ms debounce the -1 is suppressed at
    fast speeds so rapid CCW also increments.
    Fix: remove chan_b entirely (2x decode on the CW-lead signal only). When
    that signal edges, the lag signal is always mid-cycle and unambiguous.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
    [main_lcd_bringup.cpp, vfo_knob.cpp]
2026-08-24 firmware: switch to A-edge 2x decode + raw delta logging (rev 28)
    Counting B-signal edges (rev 27) fires PCNT at the first quadrature event
    of each CCW half-cycle; at that moment the A-signal (level gate) is just
    starting to settle and RS-422 skew puts it in the wrong state → +1 instead
    of -1 for CCW.
    Switch to counting A-signal edges gated by B-signal level. For CCW, A fires
    first so B is solidly LOW (pre-transition) at sample time -- no ambiguity.
    For CW, A fires second so B is solidly HIGH -- also unambiguous.
    Add ESP_LOGW of raw PCNT delta before debounce so we can confirm the decode
    direction from idf.py monitor. Remove after CCW is confirmed working.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
    [main_lcd_bringup.cpp, vfo_knob.cpp]
2026-08-24 firmware: diagnose GPIO2 stuck -- restore B-edge, add knob gpio cmd (rev 29)
    Rev 28 (counting A-signal edges on GPIO2) produced zero ISR fires, which
    means GPIO2 is not toggling. Only the B-signal (GPIO3) is confirmed to
    generate edges. Without a working A-signal the PCNT cannot distinguish CW
    from CCW.
    Restore B-edge (GPIO3) counting so CW at least works while the hardware is
    investigated. Add diagnostics:
    - ESP_LOGW on every ISR wake prints raw delta + GPIO2 and GPIO3 current
    levels; if A(GPIO2) always reads 0 the encoder A receiver is open.
    - `knob gpio` console command reads both GPIO levels and prints ISR count;
    poll_count=0 confirms no edges at all.
    Next step: check AM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
    [console_shell.cpp, main_lcd_bringup.cpp, vfo_knob.cpp]
2026-08-25 kicad: note incorrect AM26LS32ACN (U16) footprint pinout on interface sheet
    Adds a bold text note to interface.kicad_sch documenting which pins of U16
    (AM26LS32ACN) are swapped relative to the placed footprint. No footprint
    or netlist changes -- PCB Rev A is already fabricated. Fix will land in RevB.
    Also picks up KiCad's automatic (project "KiCAD" -> "analog") instance-path
    rename across all five sub-sheets (cosmetic metadata only).
    [analog.kicad_sch, arduino.kicad_sch, buffer_keyer.kicad_sch, interface.kicad_sch, vfo.kicad_sch]
2026-08-25 kicad: add text note for correct CD14538B pinout on arduino sheet
    Documents the incorrect pin assignments on the fabricated Rev A board:
    -TR_A→5, ~RST_A→3, -TR_B→11, ~RST_B→13.
    [arduino.kicad_sch]
2026-09-04 firmware: add U3 keyer bringup -- null DAC midline + 20 WPM dash test (rev 30)
    Add mcp4728::write_channel_dac() (Multi-Write DAC Register, no EEPROM burn)
    and wire it into LCD bringup Stage E: channels A+B set to code 2048 (~2.5 V,
    mid-scale with VDD ref) so T1/T2 start at approximately midline.
    Stage F initialises the MCP4921 envelope DAC and spawns keyer_dash_task,
    which runs continuous dashes at 20 WPM (180 ms on / 65 ms off) through
    U3 (MC1496) for RF keyer chain verification.
    [main_lcd_bringup.cpp, mcp4728.cpp, mcp4728.h]
2026-09-04 firmware: frequency-zone keyer control in U3 bringup (rev 31)
    keyer_dash_task now sweeps three zones via MBL-600 knob:
    < 14.200 MHz carrier high (key_down held)
    14.200–14.225 continuous 20 WPM dashes (inclusive end points)
    > 14.225 MHz carrier low (key_up held)
    State transitions fire at the end of the current dash/space cycle,
    giving ≤ 245 ms latency when sweeping through zones.
2026-09-04 firmware: fix TWDT reboot + step size in U3 bringup (rev 32)
    keyer_envelope.cpp: playout task parks in vTaskDelay(1ms) loop when
    phase reaches 1.0 (CarrierHigh held state) instead of busy-spinning;
    DAC holds CODE_FULL during yield so carrier stays up, but the core-1
    idle task gets CPU time and the 2-second TWDT no longer fires.
    next_us re-synced on park exit to avoid tick-debt burst.
    main_lcd_bringup.cpp: set_base_step_hz(1000) after MBL-600 start so
    knob steps are a consistent 1 kHz/count regardless of first-touch delta
    accumulation.
    [keyer_envelope.cpp, main_lcd_bringup.cpp]
2026-09-05 firmware: fix VFO step size -- set base_step_hz to 500 Hz (rev 33)
    PCNT accumulates delta=2 per mechanical detent (B-edge 2x decode).
    base_step_hz=1000 produced 2 kHz/detent; halving to 500 gives the
    intended 1 kHz/detent at normal speed.
    [main_lcd_bringup.cpp]
2026-09-15 firmware: seesaw encoder -> T1/T2 null balance trim (rev 34)
    Repurpose the I2C QT rotary encoder (seesaw at 0x37) from VFO stepping
    to differential null-trim: each detent adjusts MCP4728 ch A/B by ±8
    DAC codes (A=2048+bal, B=2048-bal). MBL-600 optical knob continues to
    tune VFO frequency. LCD row 3 shows live DAC codes and offset.
2026-09-15 firmware: fix MCP4921 SPI pin assignments in pin_map.h
    ENV_DAC_CS was GPIO13 (the SCK line) and ENV_DAC_SCK was GPIO12
    (an ADC pin) -- chip select was never asserted and clock was on
    the wrong pin, producing no output at TP15.
    Correct per arduino.kicad_sch net labels CS_DAC/SCK:
    ENV_DAC_CS GPIO13 -> GPIO10 (D10 / CS_DAC)
    ENV_DAC_SCK GPIO12 -> GPIO13 (D13 / SCK)
    ENV_DAC_MOSI GPIO11 unchanged (D11 / MOSI)
    Also fix stale D12 comment: GRID_BLOCK_CRASH -> ADC2.
    [pin_map.h]
2026-09-18 hardware: add RCA 40673 dual-gate MOSFET SPICE model and KiCad symbol
    Cascode two-NMOS Level-1 subcircuit derived from datasheet parameters
    (VTO=-2V, KP=7.5mA/V^2, LAMBDA=0.20 from ross=2.8kOhm cascode fit).
    KiCad symbol pinned to TO-72-4 lead map: 1=D, 2=G2, 3=G1, 4=S/Sub/Case.
    Datasheet PDF included as source reference.
